soheil647/High_Level_Synthesis/Catapult_ImageProssesing/ESL_modelsim/Lena_Out.bmp

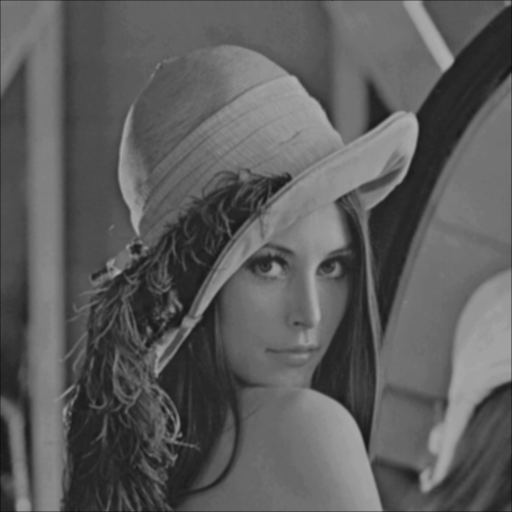
Catapult_ImageProssesing/ESL_modelsim/Lena_Out.bmp
