soheil647/High_Level_Synthesis/Catapult_Introduction/Report_AllStatus.pdf

All Status Report

مقدمه: در این ازمایش می خواهیم کد نرم افزاری را به زبان سخت افزار تبدیل کنیم و در هر مورد pipeline و Unroll کردن لوپ را ببینیم و این کاد را با استفاده از Catapult انجام می دهیم

کد++:C

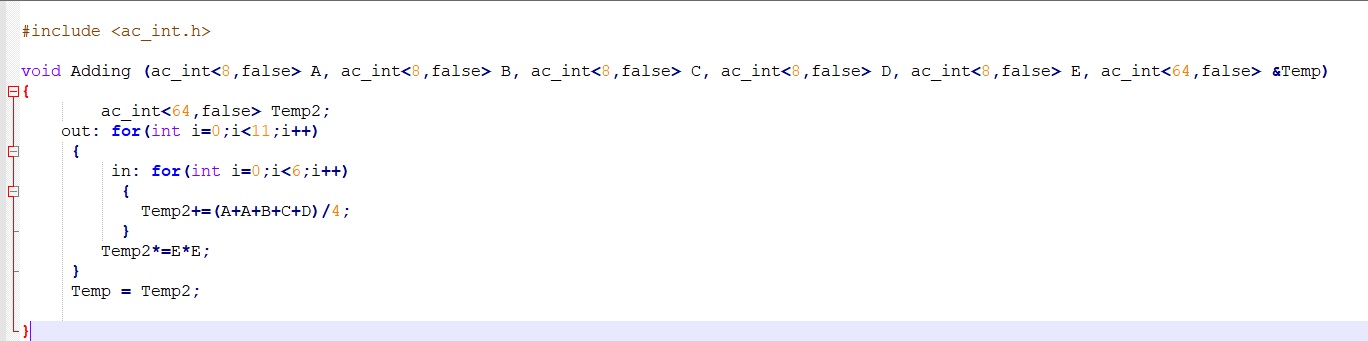
[picture p2: figure]

با استفاده از Catapult:

section A: (Min Latency) 1

Frequency: 50 MHz

Register count:179

Logic element count:395

Area: 2033.57

Latency cycle: 78

Latency time: 1560.00

Throughput cycle: 79

Throughput time: 1580.00

Data path:

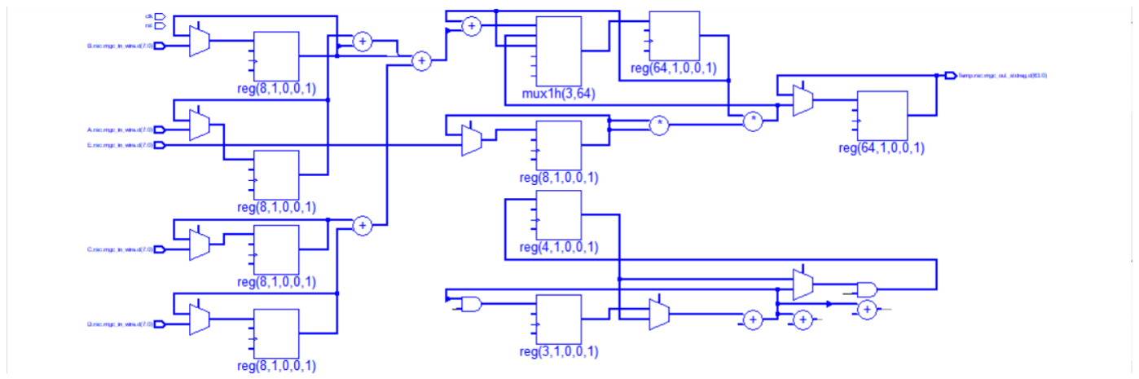
[picture p3: figure]

section B:

این قسمت pipeline با 1=II امکان پذیر نبود

main Loop Pipelining (II=2) 2

Frequency: 50Mhz

Register count: 194

Logic element count: 532

Area: 1902.86

Latency cycle: 132

Latency time: 2640.00

Throughput cycle: 132

Throughput time: 2640.00

Data path:

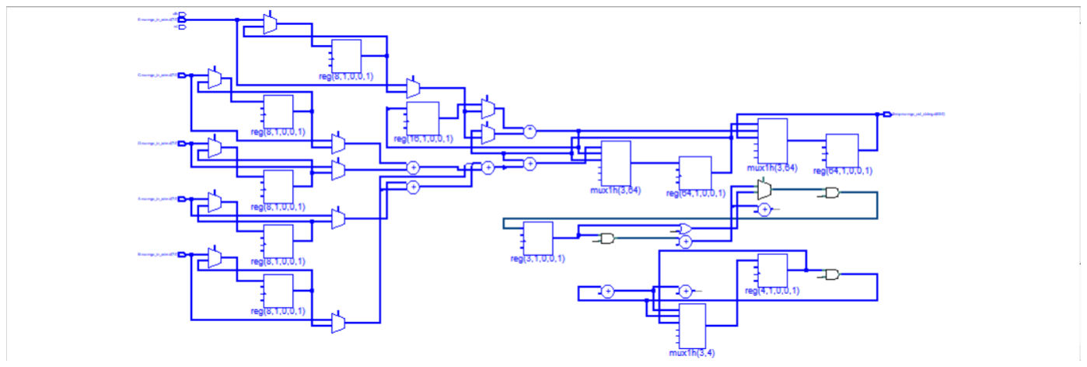
[picture p4: figure]

outer Loop Pipelining (II = 2) 3

Frequency:50Mhz

Register count: 197

Logic element count: 489

Area:1855.71

Latency cycle: 133

Latency time: 2660.00

Throughput cycle: 134

Throughput time: 2680.00

Data path:

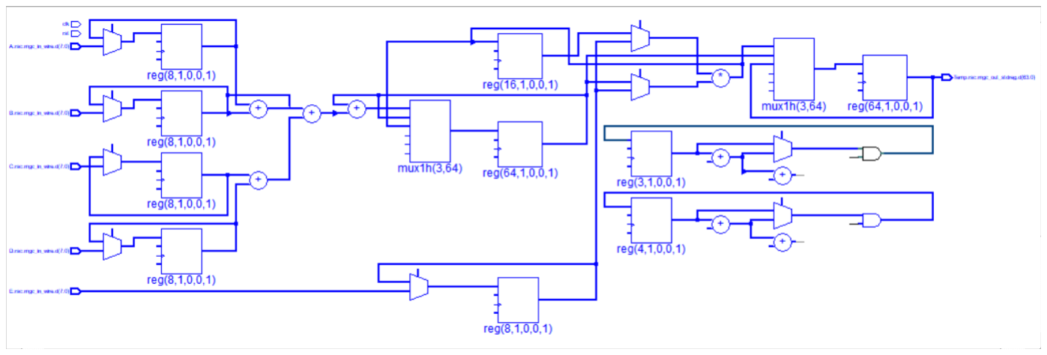
[picture p5: figure]

inner Loop Pipelining (II = 2) 4

Frequency: 50Mhz

Register count: 181

Logic element count: 398

Area:2036.65

Latency cycle: 144

Latency time: 2880.00

Throughput cycle: 145

Throughput time: 2900.00

Data path:

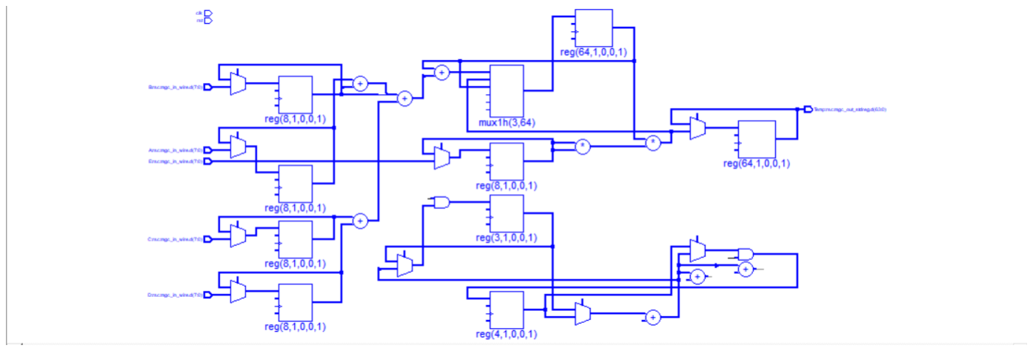
[picture p6: figure]

ر | عملکرد Pipeline: با Pipeline کردن مدار یم توانیم با Area
یکمتLatency ی بگرتیمکه به مع ین رسی ع تر بودن مدار است و

بهت ر
این
در بری 3 مورد Pipeline کردن main بوده است | ی

از بقیه بهت ر

section C:

outer loop unrolling 5

Frequency: 50Mhz

Register count: 274

Logic element count: 579

Area: 2156.89

Latency cycle: 78

Latency time: 1560.00

Throughput cycle: 79

Throughput time: 1580.00

Data path:

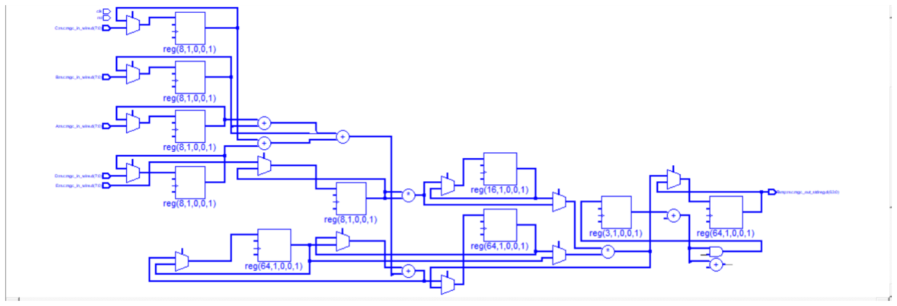
[picture p7: figure]

inner loop unrolling 6

Frequency: 50Mhz

Register count: 256

Logic element count: 427

Area: 1681.82

Latency cycle: 23

Latency time: 460.00

Throughput: 24

Throughput time: 480.00

Data path:

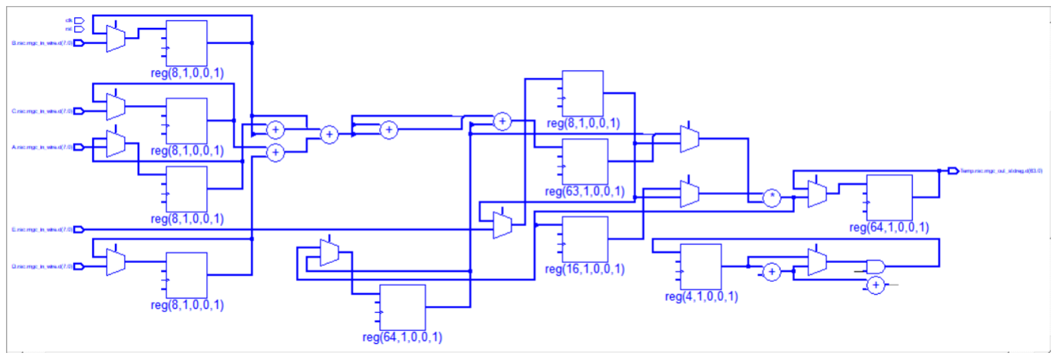
[picture p8: figure]

عملکرد Unroll: با Unroll کردن loop های مدار ما یم توانیم Iteration ها را با هم اجرا کنیم و این کار Latencyمدار را کم یم کند و رسعت باال یم رود ویل

Section D: (goal = Area) 7

Frequency: 50 MHz

Register count:197

Logic element count:492

Area: 1767.57

Latency cycle: 89

Latency time: 1780.00

Throughput cycle: 90

Throughput time: 1800.00

Data path:

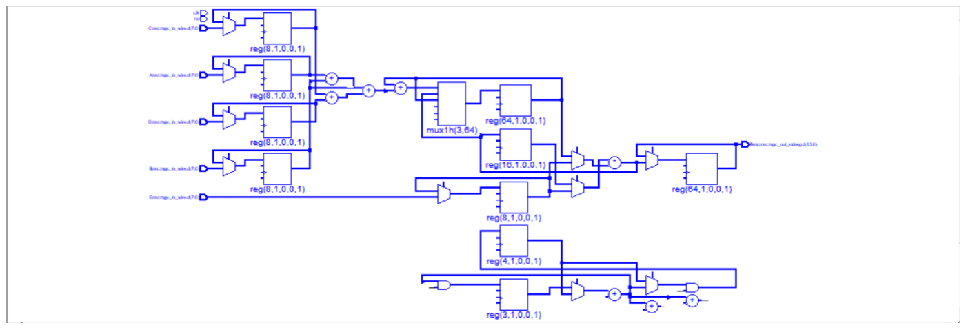
[picture p9: figure]

section D_B:

**Pipeline با 1=II قابل انجام نبوده است**

main Loop Pipelining (II=2) 8

Frequency: 50MHz

Register count: 194

Logic element count: 532

Area: 1902.86

Latency cycle: 132

Latency time: 2640.00

Throughput cycle: 132

Throughput time: 2640.00

Data path:

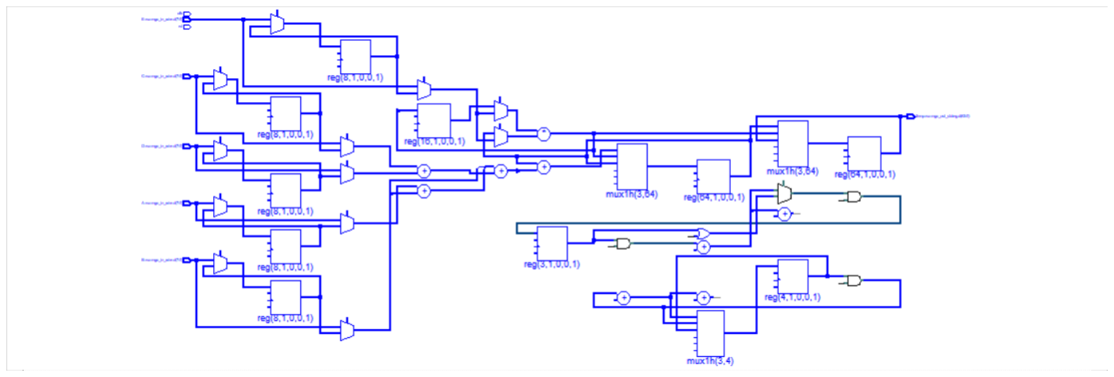
[picture p10: figure]

outer Loop Pipelining (II=2) 9

Frequency:50MHz

Register count: 197

Logic element count: 489

Area:1855.71

Latency cycle: 133

Latency time: 2660.00

Throughput cycle: 134

Throughput time: 2680.00

Data path:

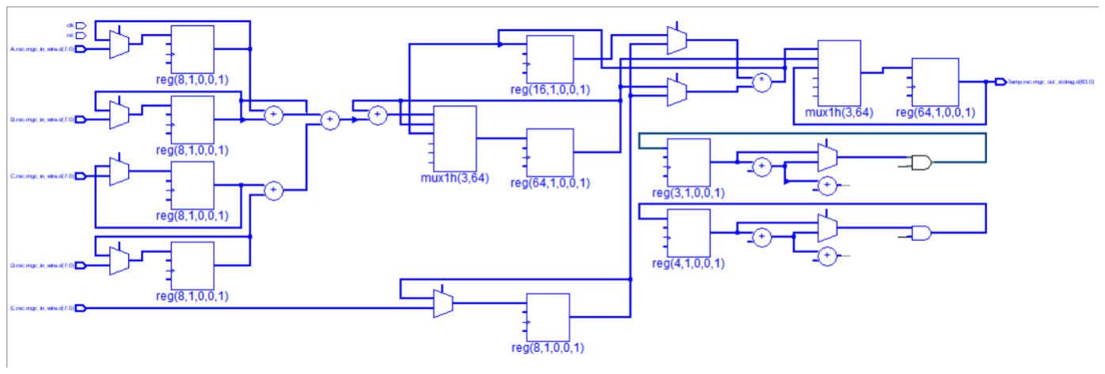
[picture p11: figure]

inner Loop Pipelining (II = 2) 10

Frequency: 50MHz

Register count: 199

Logic element count: 196

Area:1771.38

Latency cycle: 155

Latency time: 3100.00

Throughput cycle: 156

Throughput time: 3120.00

Data path:

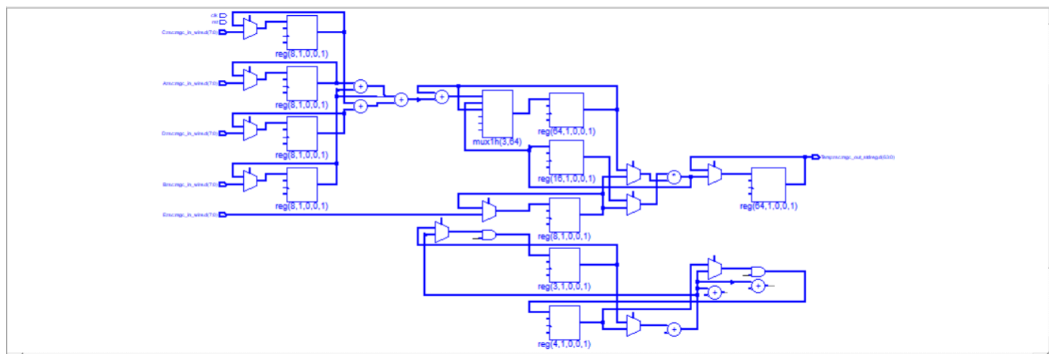
[picture p12: figure]

section C:

outer loop unrolling 11

Frequency: 50MHz

Register count: 276

Logic element count: 589

Area: 1579.79

Latency cycle: 79

Latency time: 1898.79

Throughput cycle: 80

Throughput time: 1600.00

Data path:

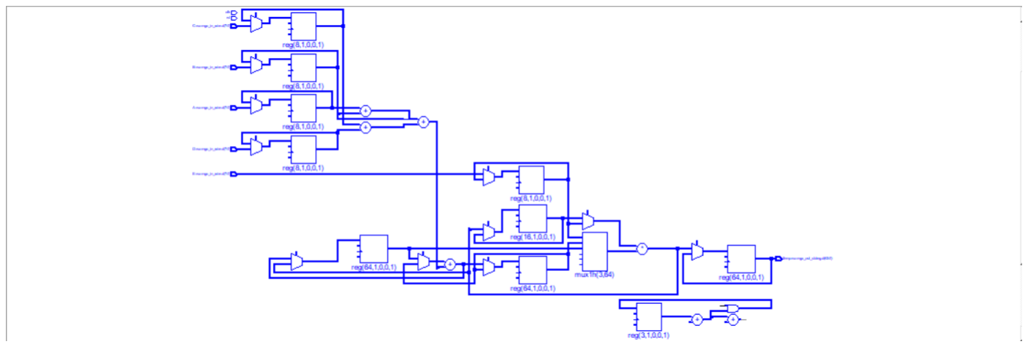
[picture p13: figure]

inner loop unrolling 12

Frequency: 50MHz

Register count: 256

Logic element count: 427

Area: 1681.82

Latency cycle: 23

Latency time: 460.00

Throughput: 24

Throughput time: 480.00

Data path:

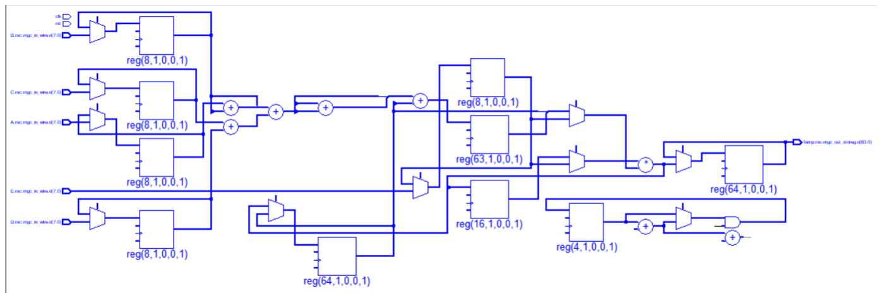
[picture p14: figure]
