soheil647/High_Level_Synthesis/Chisel_Introduction/Summery.pdf

Summery

چکیده:

در این پروژه می خواهیم نصب و کار با کتابخانه Chisel در زبان scala را بیاموزیم برای این کار نیاز است تا ابتدا سیستم عامل linux را نصب کنیم

مقدمه:

هزف از انجام این ازمایش یادگیری پایه ای Chisel و انجام دو ماژول ساده است برای این کار در ترمینال Linux قسمت های مورد نیاز را نصب کرده سپس Chisel را نصب می کنیم و در ان فایل Scala. را ساخته و ماژول های خود را در ان می نویسیم . در این ازمایش می خواهیم دو ماژول ALU و Stack را بسازیم

ابزار ها:

در این ازمایش در محیط Linux با استفاده از زبان Scala و کتابخانه Chisel ماژول های مورد نیاز را می سازیم

قسمت اول:

در قسمت اول خواسته شده تا یک ALU ساده با استفاده از 4 ALU که هر کدام عمل خاص خود را دارند بسازیم

ابتدا بعد از نصب Chisel و باز کردن فایل ان به پوشه solution/src رفته و یک فایل Scala. می سازیم و در ان پروژه را می سازیم

ابتده 4 ماژولALU برای هر یک از عملیات های جمع تفریق ضرب و تقسیم را مانند شکل های زیر می سازیم

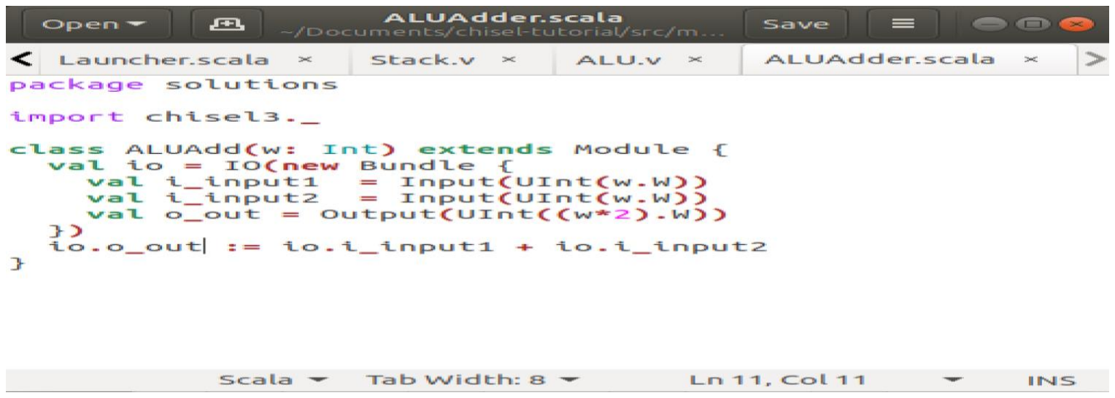
[picture p15: figure]

:ADDER:1 Figure

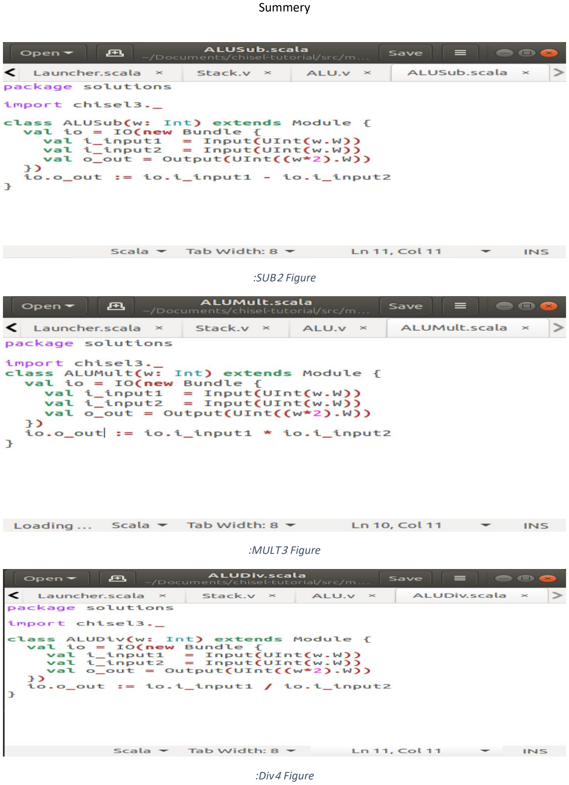
[picture p16: page 2]

:SUB2 Figure

:MULT3 Figure

:Div4 Figure

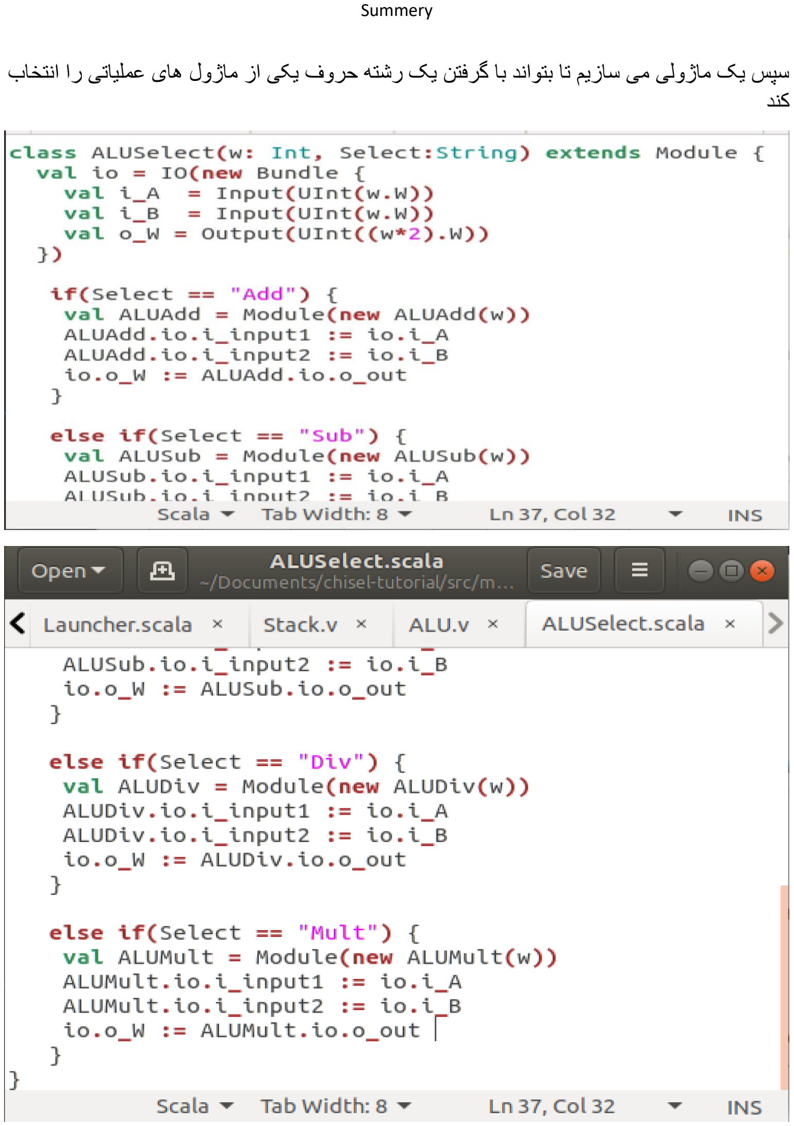
[picture p17: page 3]

سپس یک ماژولی می سازیم تا بتواند با گرفتن یک رشته حروف یکی از ماژول های عملیاتی را انتخاب کند

و سچس یک ماژول ساخته تا همه را به هم وصل کند ورودی خروجی ها را بگیرد و مقدار Delay دلخواه بدهد

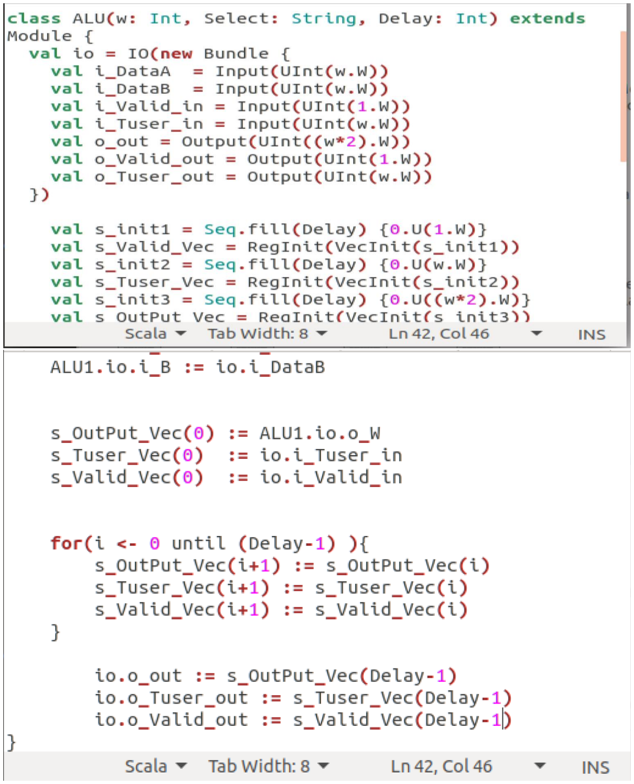
[picture p18: figure]

بعد از نوشتن ماژول ها ان را در ترمینال Compile می کنیم و از صحت ان مطمن می شویم

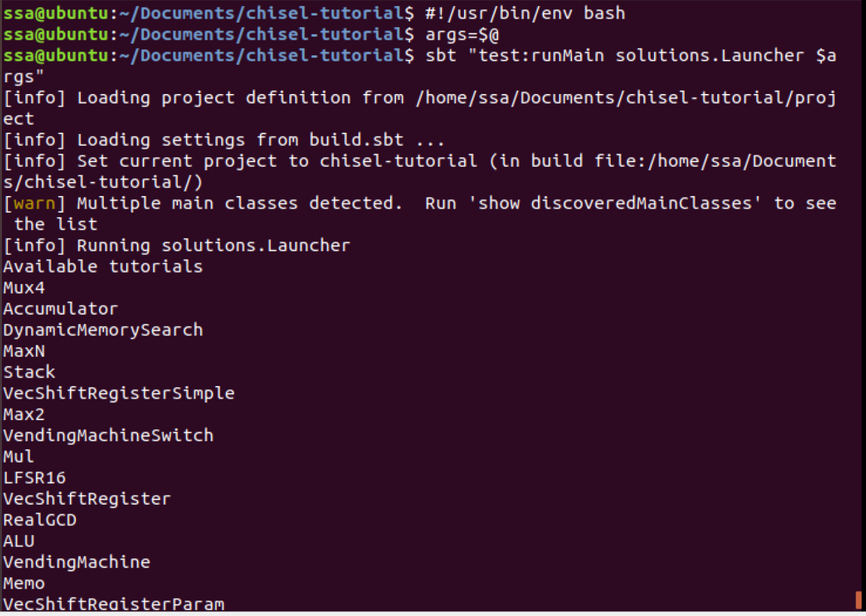
[picture p19: figure]

سپس به فایل تست رفته و تست ان را می نویسیم مانند شکل زیر:

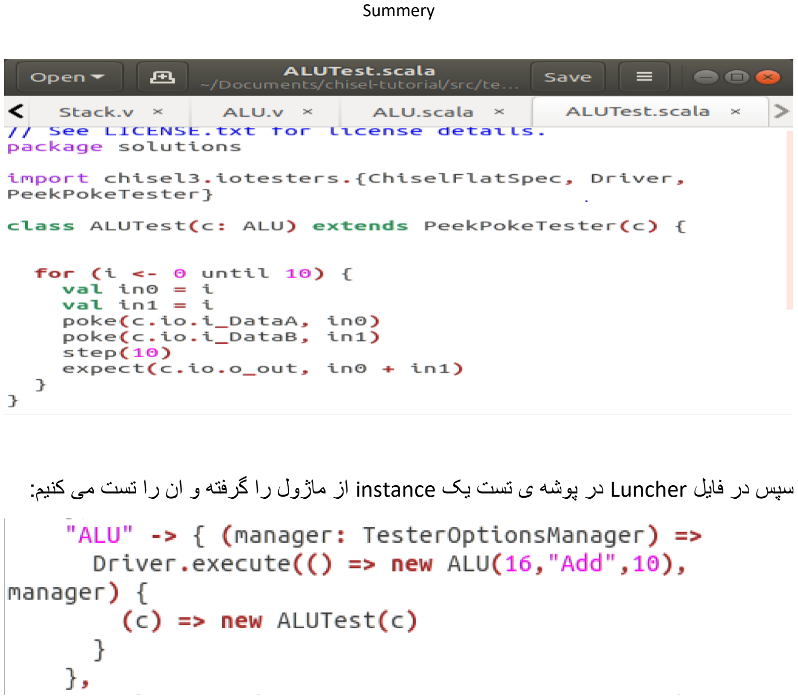
[picture p20: page 6]

سپس در فایل Luncher در پوشه ی تست یک instance از ماژول را گرفته و ان را تست می کنیم:

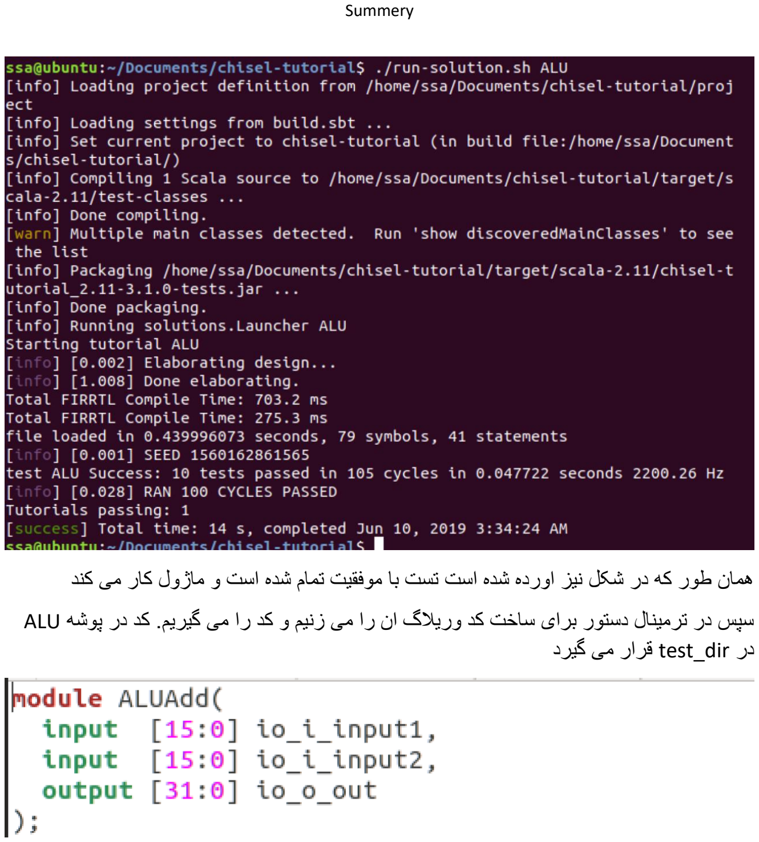
[picture p21: page 7]

همان طور که در شکل نیز اورده شده است تست با موفقیت تمام شده است و ماژول کار می کند

سپس در ترمینال دستور برای ساخت کد وریالگ ان را می زنیم و کد را می گیریم. کد در پوشه ALU در dir_test قرار می گیرد

کد را به Quartes برده و سنتز می کنیم و داریم:

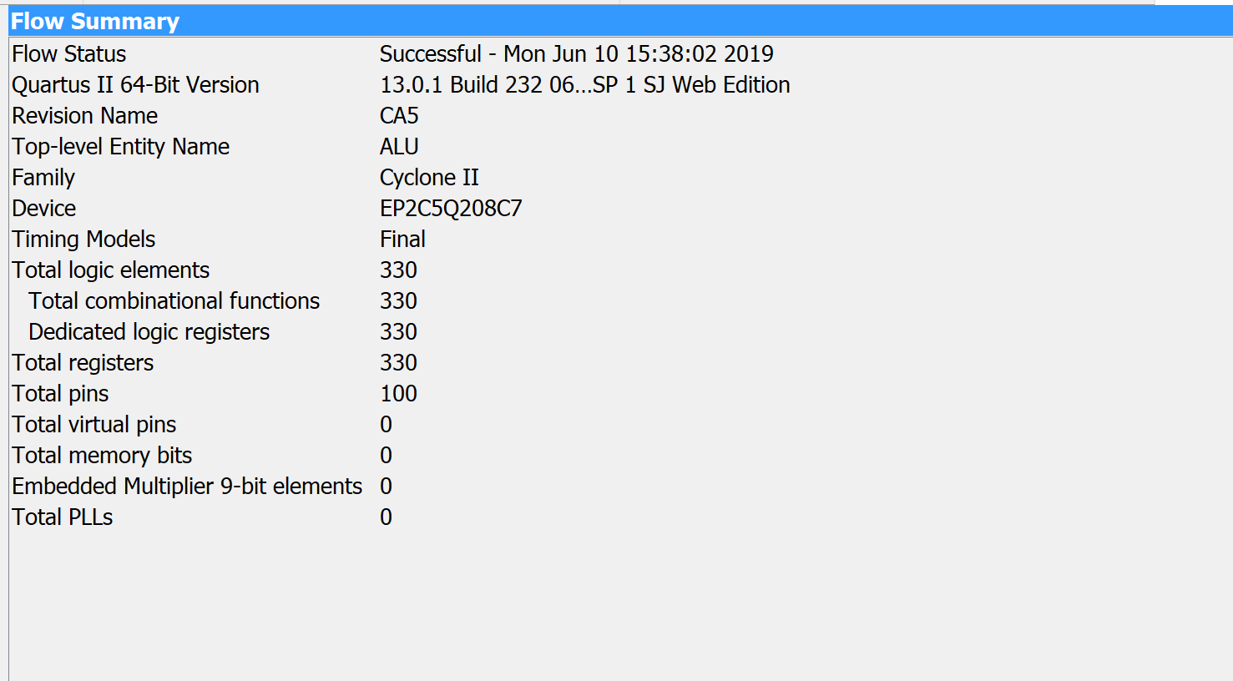
[picture p22: figure]

قسمت دوم:

در این قسمت می خاهیم یک استک بسازیم:

همانند قسمت قبل ابتدا فایل ماژول را ساخته و Compile می کنیم

ماژول استک را مانند زیر می سازیم:

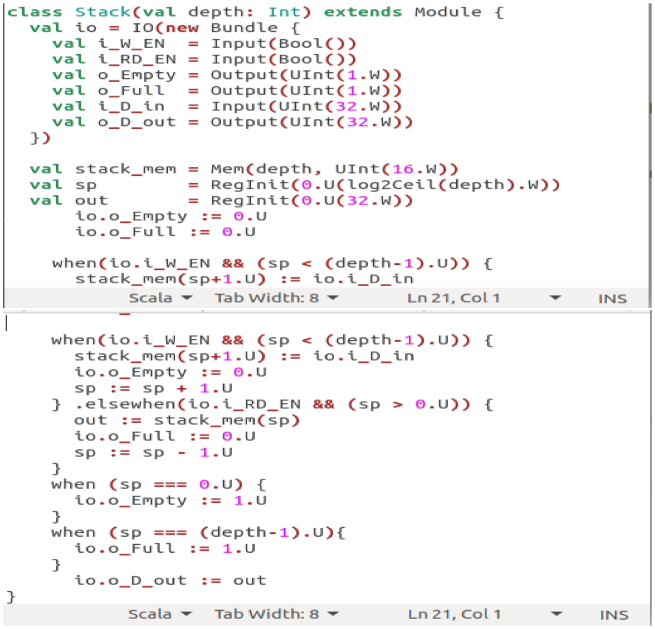
[picture p23: figure]

سپس ان را در ترمینال Compile می کنیم و درستی ان را جک می کنیم

سپس به پوشه تست رفته و تست بنچ مربوط به ان را می نویسیم

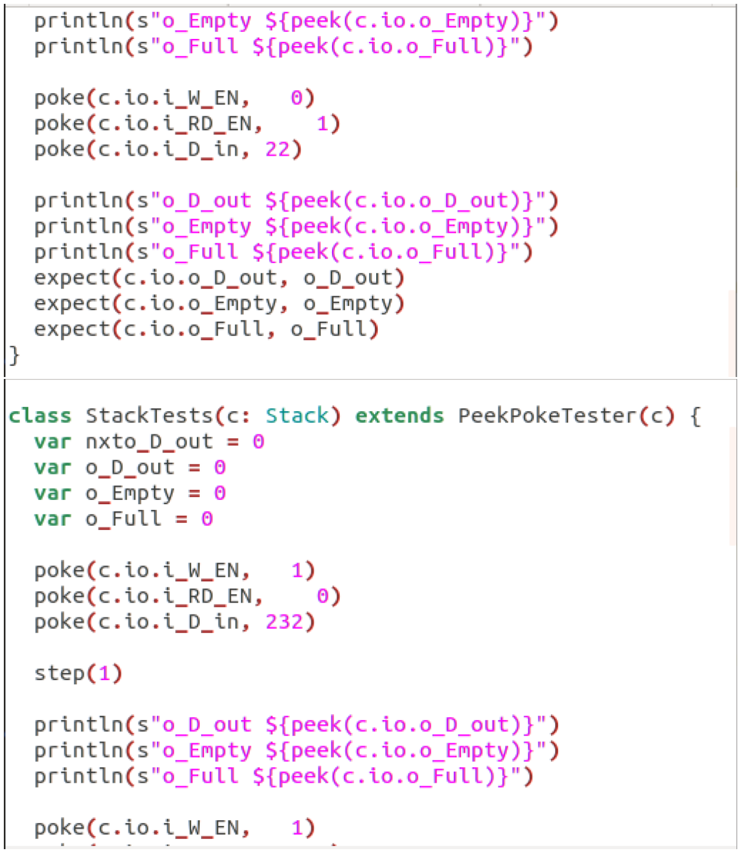
[picture p24: figure]
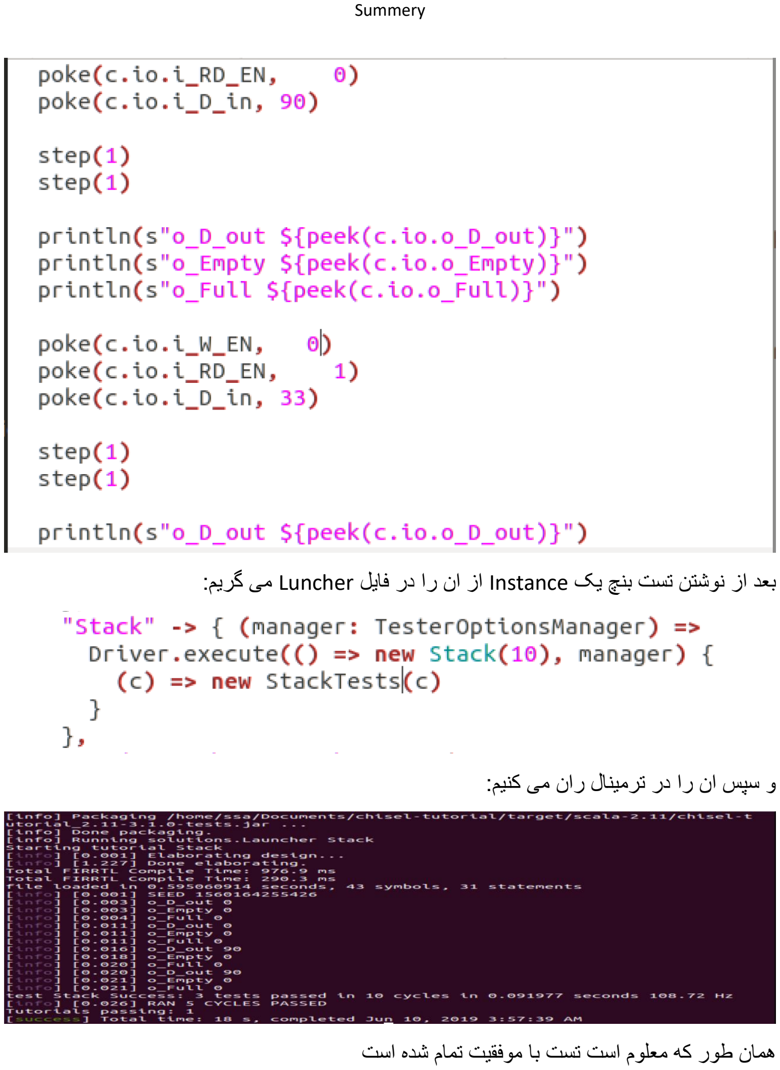
[picture p25: page 11]

بعد از نوشتن تست بنچ یک Instance از ان را در فایل Luncher می گریم:

و سپس ان را در ترمینال ران می کنیم:

همان طور که معلوم است تست با موفقیت تمام شده است

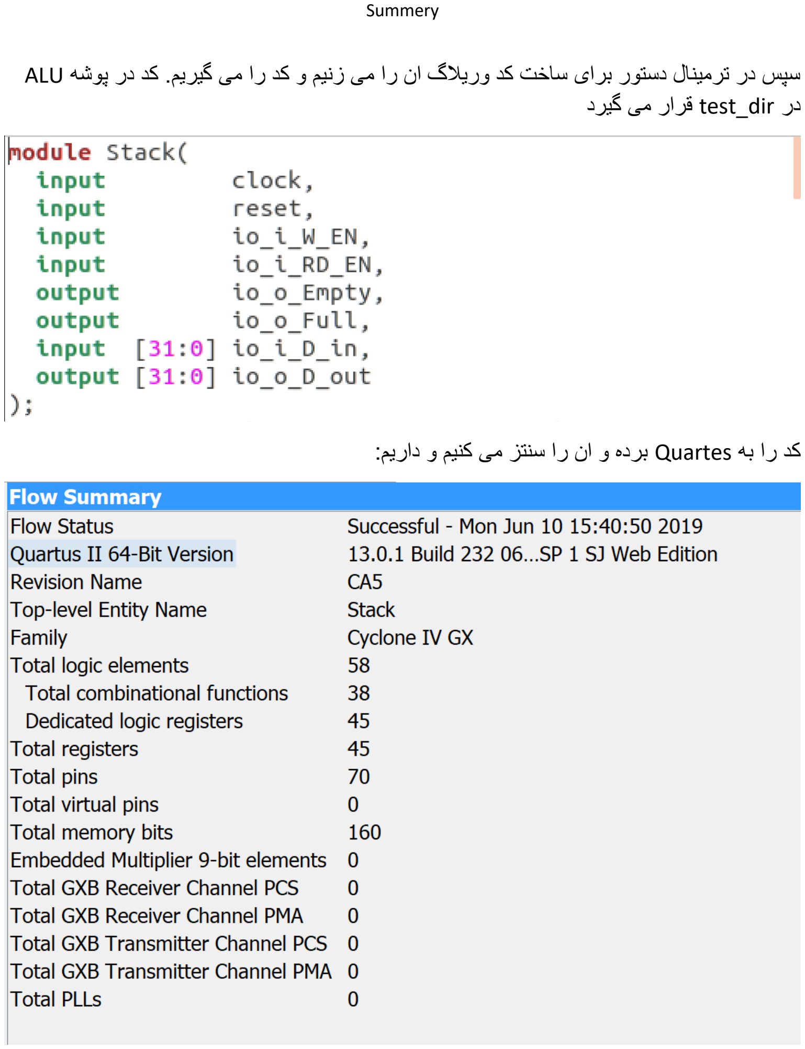
[picture p26: page 12]

سپس در ترمینال دستور برای ساخت کد وریالگ ان را می زنیم و کد را می گیریم. کد در پوشه ALU در dir_test قرار می گیرد

کد را به Quartes برده و ان را سنتز می کنیم و داریم:
