soheil647/High_Level_Synthesis/Matlab_HDLCoder_FIR/Gozaresh.pdf

Summery

### چکیده:

در این پروژه می خواهیم فیلتر FIR را با الگوریتم های مختلفی بسازیم و کار با HDL Matlab یاد بگیریم

### مفدمه:

در این پروژه از Coder HDL Matlab و Modelsim استفاده شده است که ما ابتدا فیلتری را به صورت دستی با زبان Verilog ساختیم سپس همان فیلتر را با Matlab ساختیم و کد Verilog را با ان تولید کردیم این کار را یک بار با الگریتم CSD و یک بار به صورت DA ساخته ایم

### ابزار ها:

در این پروژه از Modelsim و Matlab و Quartes استفاده شده است و مدل FPGA را II Cyclone انتخاب کرده ایم

### قسمت :1

1( ابتدا فیلتر FIR را که در زیر نیز امده است به صورت دستی نوشته ایم. در این فیلتر ضرایب 480و 320-و 31 است که انها را به صورت CSD در نظر گرفته ایم

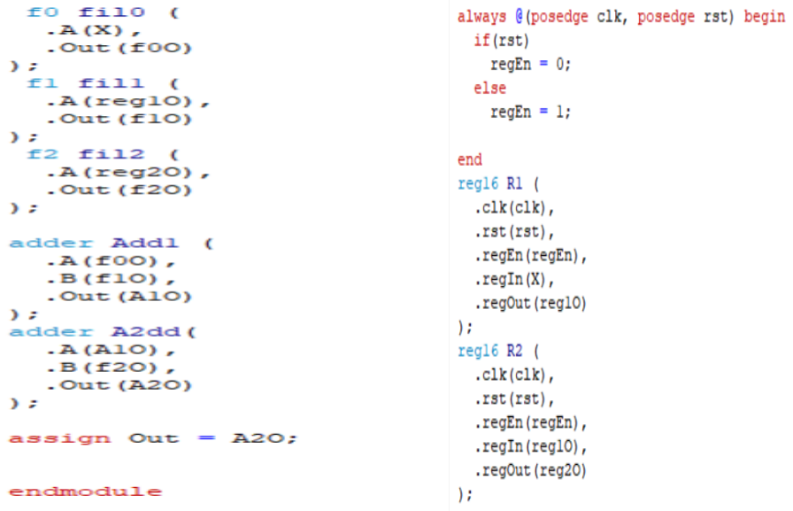
[picture p27: figure]

کد کامل در فایل قرار دهده شده است و ضرایب به صورت CSD هستند

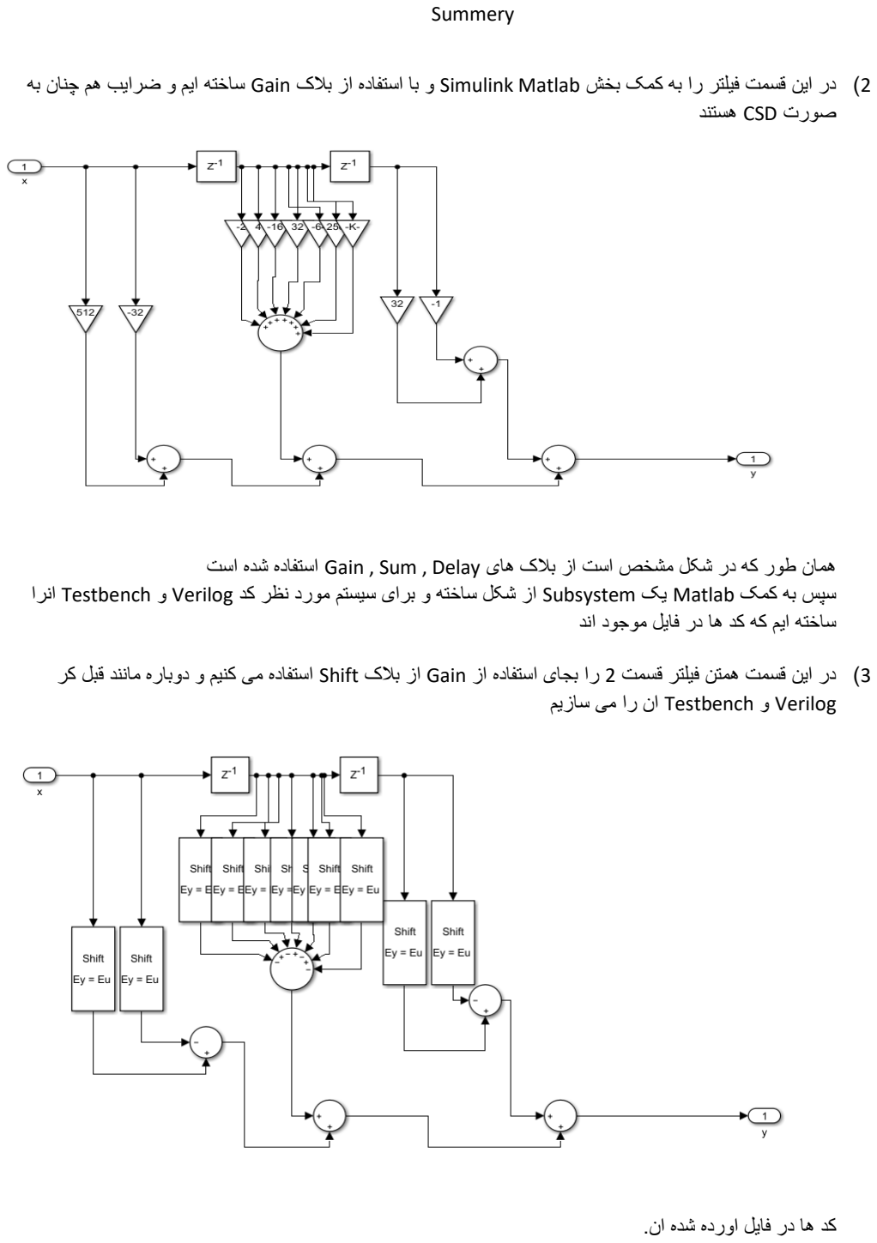
[picture p28: page 2]

2( در این قسمت فیلتر را به کمک بخش Matlab Simulink و با استفاده از بالک Gain ساخته ایم و ضرایب هم چنان به صورت CSD هستند

همان طور که در شکل مشخص است از بالک های Delay , Sum , Gain استفاده شده است سپس به کمک Matlab یک Subsystem از شکل ساخته و برای سیستم مورد نظر کد Verilog و Testbench انرا ساخته ایم که کد ها در فایل موجود اند

3( در این قسمت همتن فیلتر قسمت 2 را بجای استفاده از Gain از بالک Shift استفاده می کنیم و دوباره مانند قبل کر Verilog و Testbench ان را می سازیم

کد ها در فایل اورده شده ان.

4( با استفاده از کد های Testbench تولید شده فیلتر های ساخته شده را امتحان می کنیم و می بینیم که درست کار می کنند

5( حال کد های Verilog را به Quartes برده و انها را synthesis می کنیم و داده های زیر به دست می ایند:

Handwrite_FIR_CSD☺ Total Logic Elements: 135, Total Registers: 33;
Matlab_Gain_FIR☺ Total Logic Elements: 208, Total Registers: 102;
Matlab_Shift_FIR☺ Total Logic Elements: 133, Total Registers: 32;

6( تفاوت کد های Shift , Gain در ان است که در Gain کد تولید شده به ازای هر Block Gain یک رجیستر استفاده شده و تمام مقادیر ثابت ان رجیستر شده اند ولی در Shift این مقادیر با استفاده از Assign بدست امده ان و دیگر رجیستر
ن یستند به امین دلیل تعداد رجیستر و LE کمتری استفاده شده است.

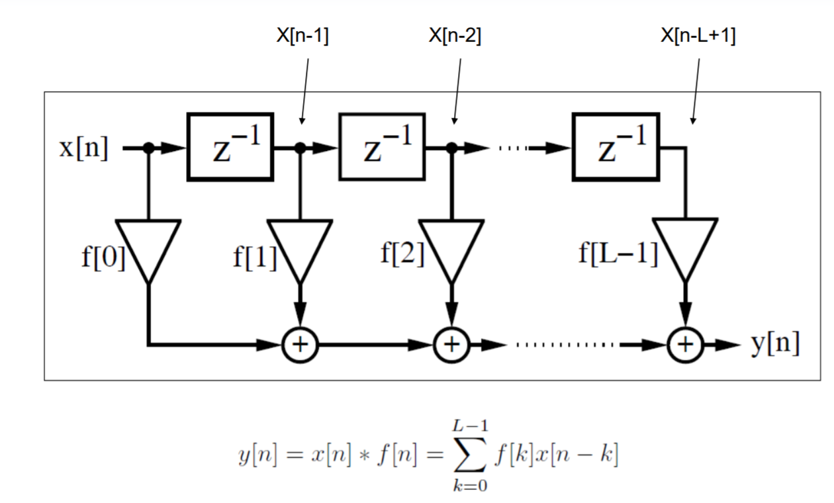
[picture p29: figure]
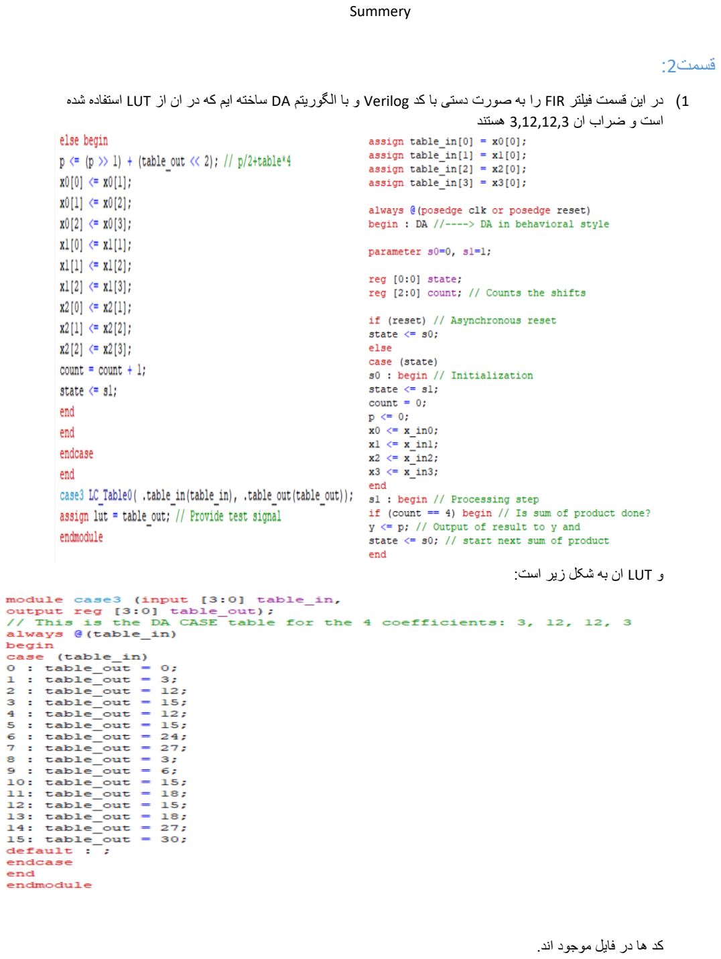
[picture p30: page 4]

### قسمت :2

1( در این قسمت فیلتر FIR را به صورت دستی با کد Verilog و با الگوریتم DA ساخته ایم که در ان از LUT استفاده شده است و ضراب ان 3,12,12,3 هستند

و LUT ان به شکل زیر است:

کد ها در فایل موجود اند.

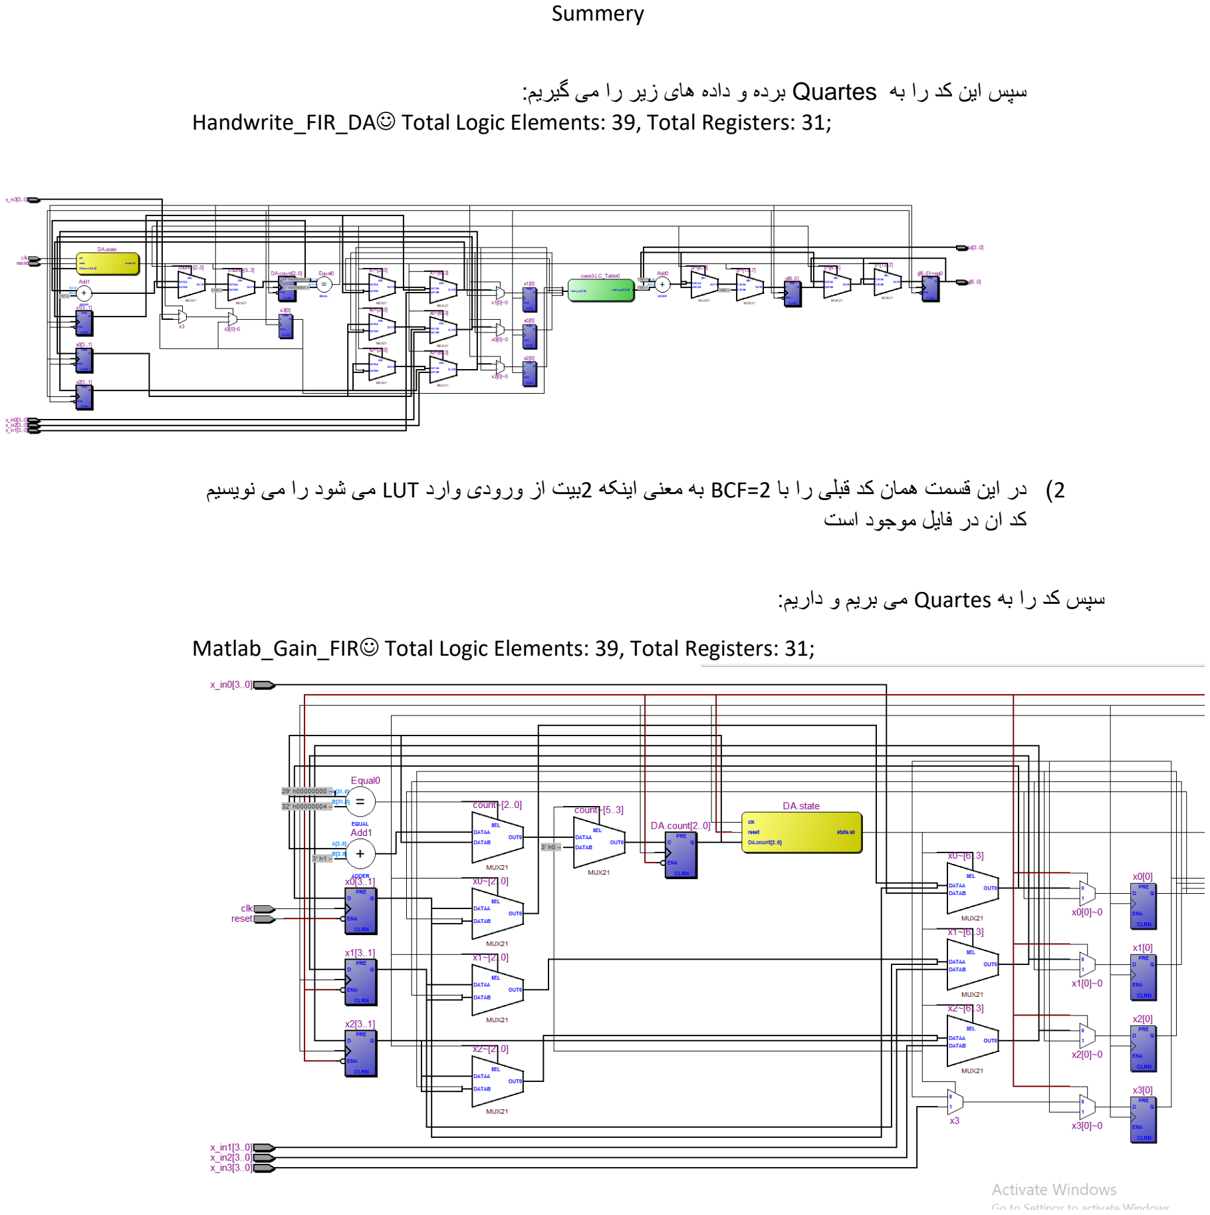
[picture p31: page 5]

سپس این کد را به Quartes برده و داده های زیر را می گیریم: Handwrite_FIR_DA☺ Total Logic Elements: 39, Total Registers: 31;

2( در این قسمت همان کد قبلی را با 2=BCF به معنی اینکه 2بیت از ورودی وارد LUT می شود را می نویسیم کد ان در فایل موجود است

سپس کد را به Quartes می بریم و داریم:

Matlab_Gain_FIR☺ Total Logic Elements: 39, Total Registers: 31;

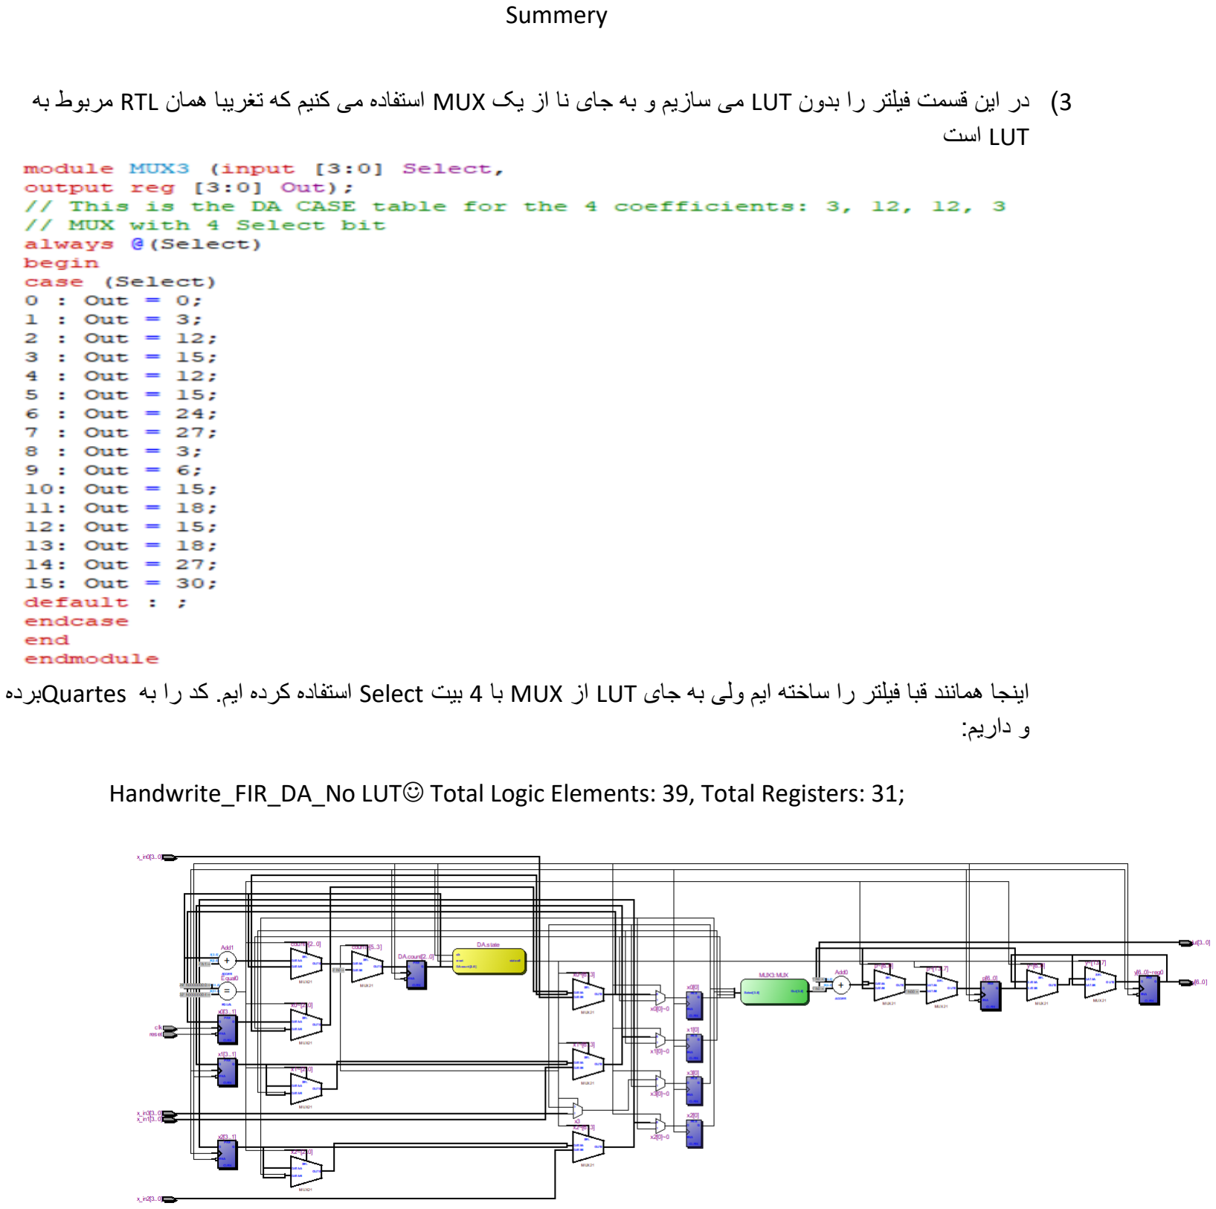
[picture p32: page 6]

3( در این قسمت فیلتر را بدون LUT می سازیم و به جای نا از یک MUX استفاده می کنیم که تغریبا همان RTL مربوط به LUT است

اینجا همانند قبا فیلتر را ساخته ایم ولی به جای LUT از MUX با 4 بیت Select استفاده کرده ایم. کد را به Quartesبرده و داریم:

Handwrite_FIR_DA_No LUT☺ Total Logic Elements: 39, Total Registers: 31;

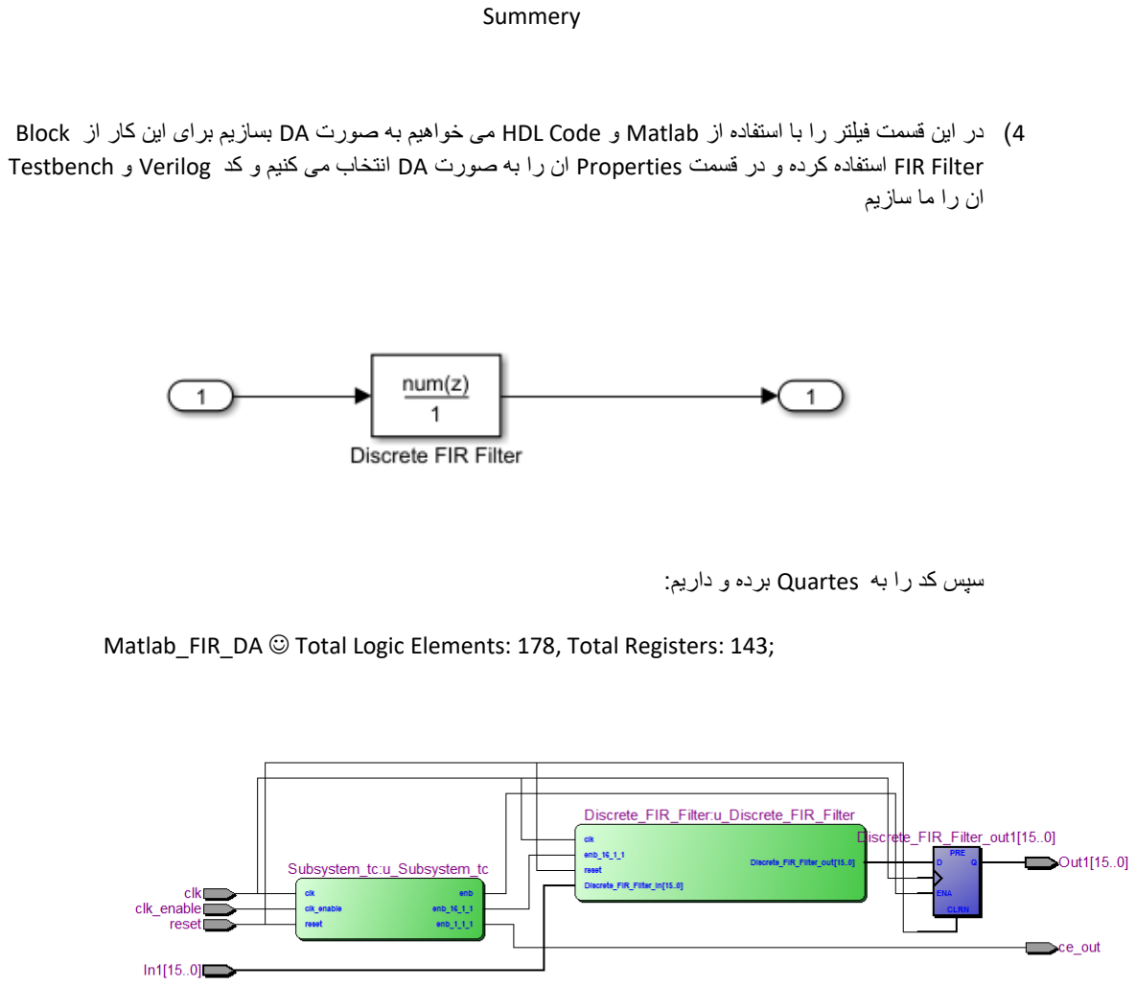
[picture p33: page 7]

4( در این قسمت فیلتر را با استفاده از Matlab و Code HDL می خواهیم به صورت DA بسازیم برای این کار از Block Filter FIR استفاده کرده و در قسمت Properties ان را به صورت DA انتخاب می کنیم و کد Verilog و Testbench
ان را ما سازیم

سپس کد را به Quartes برده و داریم:

Matlab_FIR_DA ☺ Total Logic Elements: 178, Total Registers: 143;

5( برای مقایسه این روش ها داریم:

Logic elements: HDL Code > No LUT > BCF=1 > BCF=2

Registers: HDL Code > No LUT > BCF=1 > BCF=2

دلیل ان این است که در 2=BCF LUT ها 8 بیتی است و به تعدهد کمتری رجیستر نیاز دارید و در LUT No که از MUX استفاده شده چون LUT ندارد و RTL است تعداد بیشتر دارد و در نهایت Code HDL بیشترین است
