soheil647/High_Level_Synthesis/Verilog_Cordic/Summery.pdf

Summery

## چکیده:

در این پروژه به بررسی و محاسبه ی توابع مختلف با استفاد از الگوریتم CORDIC می پردازیم و سعی می کنیم ان ها را به ازای مقادیر مختلف محاسبه کنیم و فرق بین CORDIC و بسط تیلور را در اخر مقایسه می کنیم

## مقدمه:

هدف از انجام این پروژه یادگیری الگوریتم CORDIC و نوشتن ان به زبان Verilog است. در این پروژه در Modelsim با استفاده از Verilog توابع مختلف را پیاده سازی کرده و ان ها را بررسی می کنیم.

## مراحل انجام تمرین:

در این پروژه ابتدا سعی می کنیم توابع Cos , Sin را با CORDIC محاسبه کنیم سپس تابع قدر مطلق را محاسبه کرده و سپس تابع جذر را به دو روش CORDIC و series Tylor محاسبه می کنیم و ان ها را با هم مقایسه می کنیم

## قسمت اول:

می خواهیم تابع Trigonometry را با CORDIC پیاده سازی کنیم

این ت ابع ورودی Theta را گرفته و مقادیر Cos , Sin ان را محاسبه می کند برای این کار یک سیگنال ورودی Valid و دو سیگنال Busy , Done نیز استفاده شده است.

طبق CORDIC در مد گردشی مقدار z را به 0 می رسانیم و مقادیر Cos , Sin را بدست می اوریم

برای این الگریتم ابتدا نیاز به مقادیر ثابت -1Tan ها داریم که در عکس امده اند.

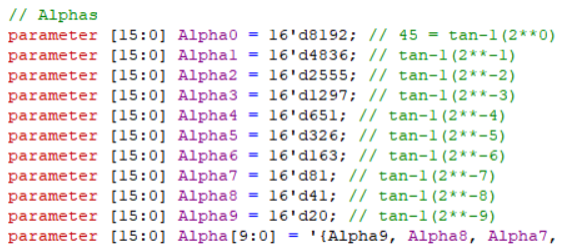
[picture p34: figure]
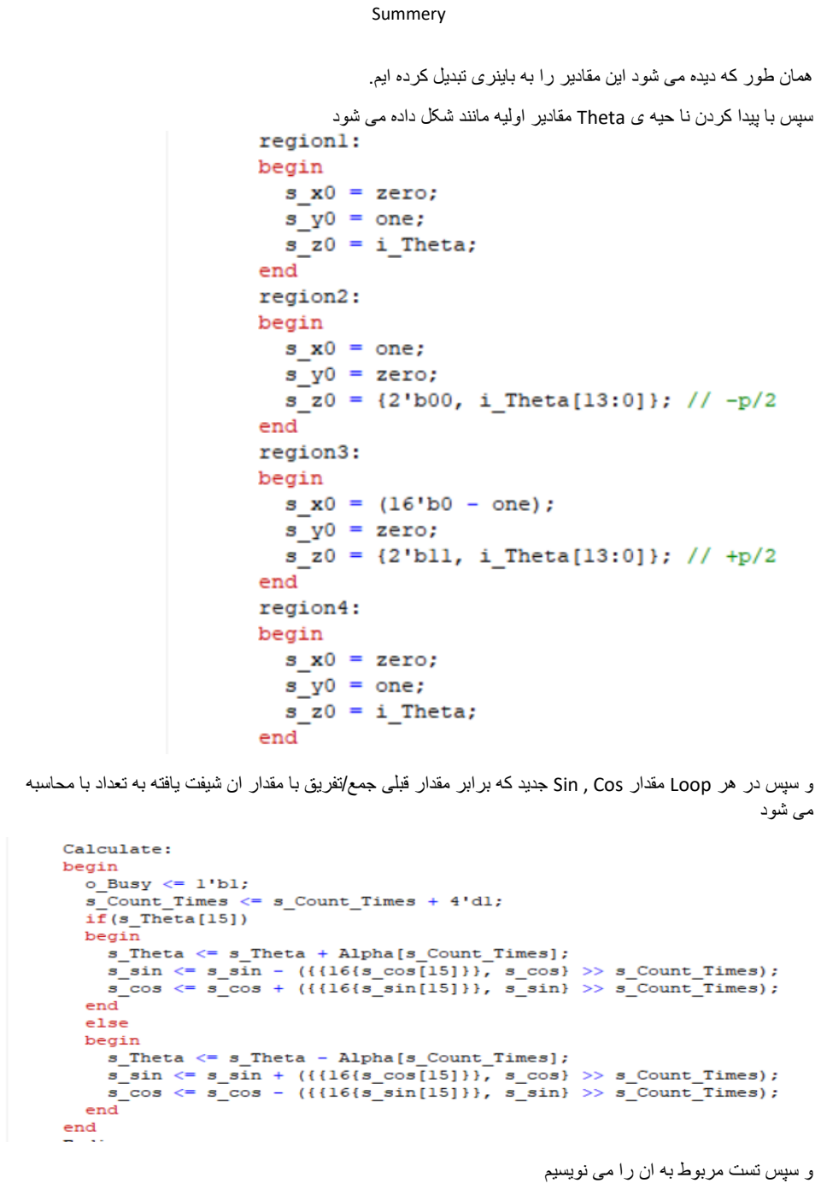
[picture p35: page 2]

همان طور که دیده می شود این مقادیر را به باینری تبدیل کرده ایم.

سپس با پیدا کردن نا حیه ی Theta مقادیر اولیه مانند شکل داده می شود

و سپس در هر Loop مقدار Cos , Sin جدید که برابر مقدار قبلی جمع/تفریق با مقدار ان شیفت یافته به تعداد با محاسبه می شود

و سپس تست مربوط به ان را می نویسیم

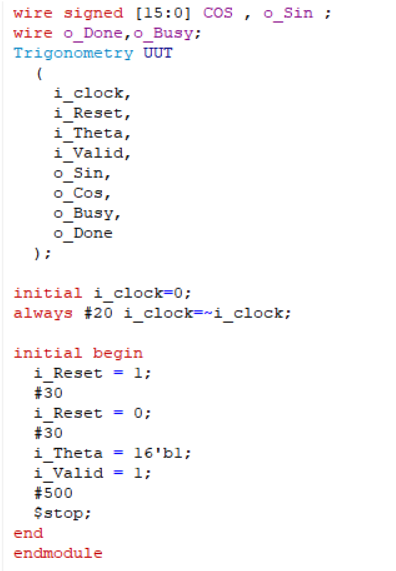
[picture p36: figure]

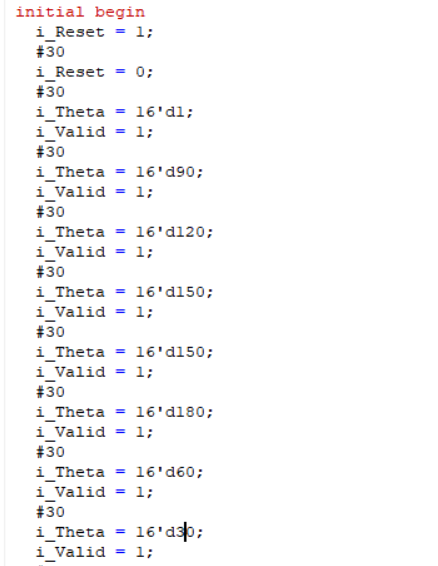
[picture p37: figure]

و مقادیر بدست امده را می بینیم

## قسمت دوم:

در این قسمت می خواهیم تابع قدر مطلق را پیاده سازی کنیم

تابع قدر مطلق به صورت

|A + jB| = K1√y
2 + x X | 2 0 = A , Y0 = B

با استفاده از الگریتم CORDIC پیاده سازی می شود در این قسمت از Pipeline با 1=Throughput نیز استفاده شده است و ضریب K برابر 1.62 در نظر گرفته شده است

برای این کار ابتدا به مقادیر -1Tan ها مانند قبل نیاز داریم

سپس باید با توجه به مقدار B , A ناحیه ی کارمان را پیدا کنیم

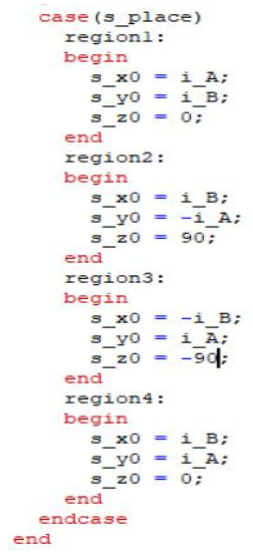
[picture p38: figure]
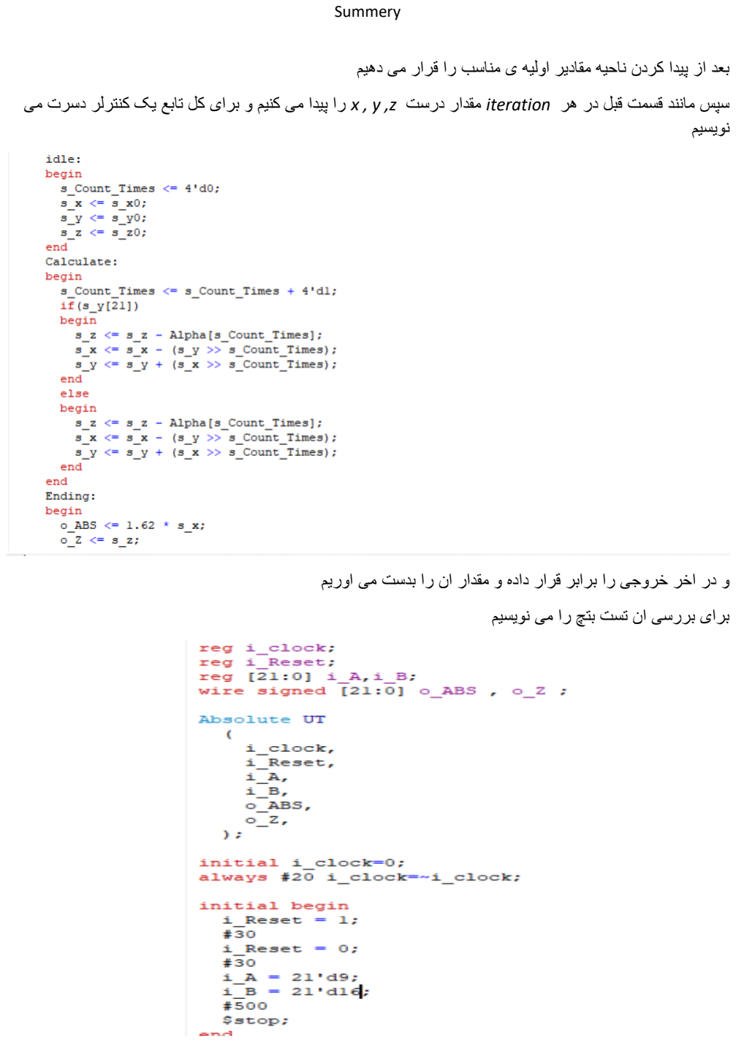
[picture p39: page 6]

بعد از پیدا کردن ناحیه مقادیر اولیه ی مناسب را قرار می دهیم

سپس مانند قسمت قبل در هر iteration مقدار درست z, y , x را پیدا می کنیم و برای کل تابع یک کنترلر دسرت می نویسیم

و در اخر خروجی را برابر قرار داده و مقدار ان را بدست می اوریم

برای بررسی ان تست بتچ را می نویسیم

## قسمت سوم:

در این قسمت می خواهیم تابع جذر را پیاده سازی کنیم

تابع قدر مطلق به صورت

√W = √y
2 − x X | 2 0 = W + 0.25 , Y0 = W + 0.25

با استفاده از الگریتم CORDIC پیاده سازی می شود در این قسمت از Pipeline با 1=Throughput نیز استفاده شده است

این تابع به صورت مستقیم از CORDIC قابل محاسبه نیست ول می توان با تغییر کوچکی در مقدار اولیه های تابع قدر مطلق ان را بدست اورد

برای این کار مانند قبل عمل می کنیم

ابتدا مقادیر -1Tan ها را ذخیره می کنیم

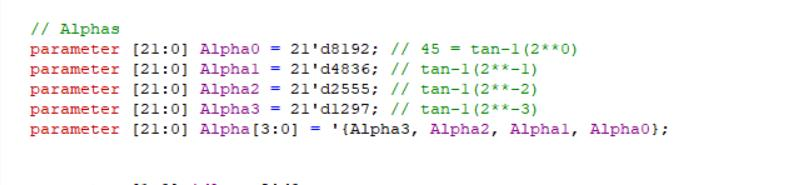
[picture p40: figure]

سپس برای پیدا کردن ناحیه ی کار چون x باید از Y بزرگ تر باشد پس بر خالف قسمت قبل فقط 1 ناحیه داریم که در شکل زیر اورده شده است

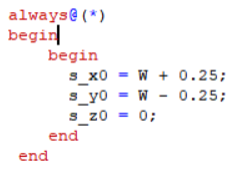
[picture p41: figure]

سپس برای هر Iteration مقادیر مورد نظر را با استفاده از الگوریتم پیدا کرده در مواقع نیاز ان را شیفت داده و یا از مقادیر ثابت Alpha استفاده می کنیم و برای ان کنترلر درست را می نویسیم

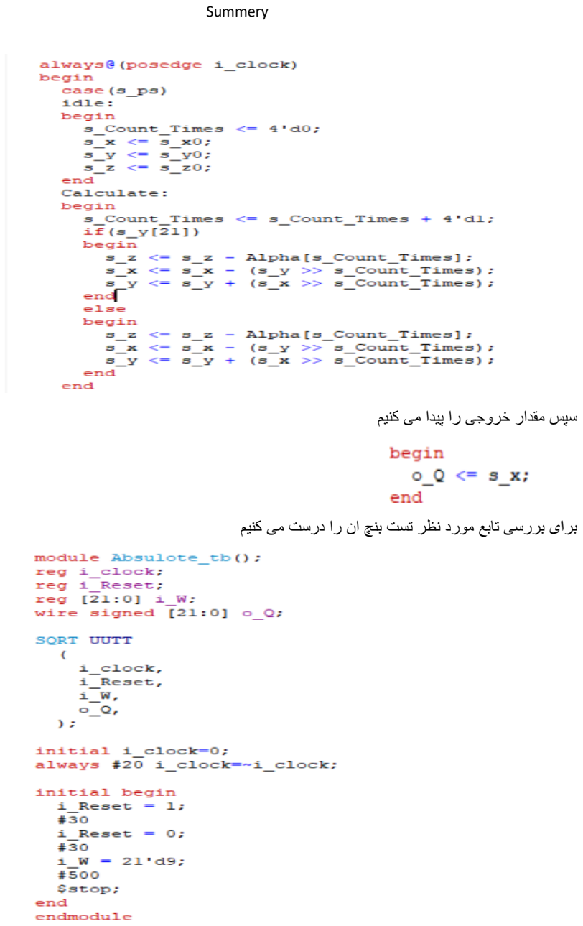
[picture p42: page 8]

سپس مقدار خروجی را پیدا می کنیم

برای بررسی تابع مورد نظر تست بنچ ان را درست می کنیم

## قسمت جهار:

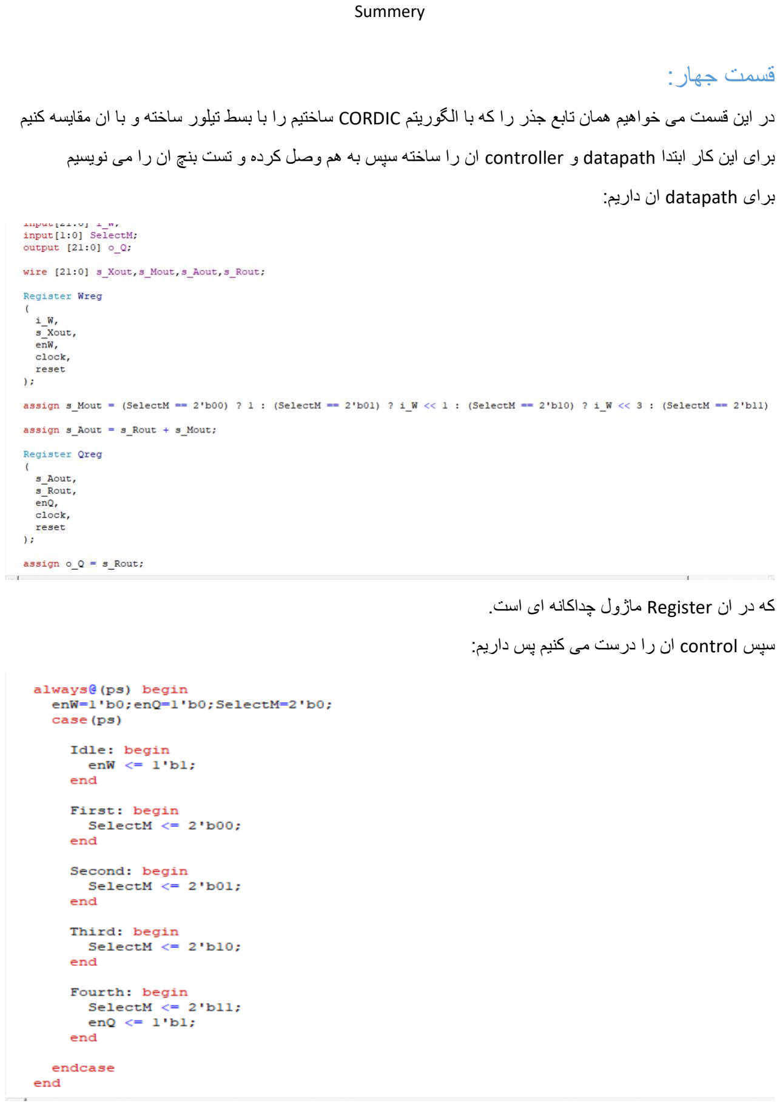
[picture p43: page 9]

در این قسمت می خواهیم همان تابع جذر را که با الگوریتم CORDIC ساختیم را با بسط تیلور ساخته و با ان مقایسه کنیم

برای این کار ابتدا datapath و controller ان را ساخته سپس به هم وصل کرده و تست بنچ ان را می نویسیم

برای datapath ان داریم:

که در ان Register ماژول چداکانه ای است.

سپس control ان را درست می کنیم پس داریم:

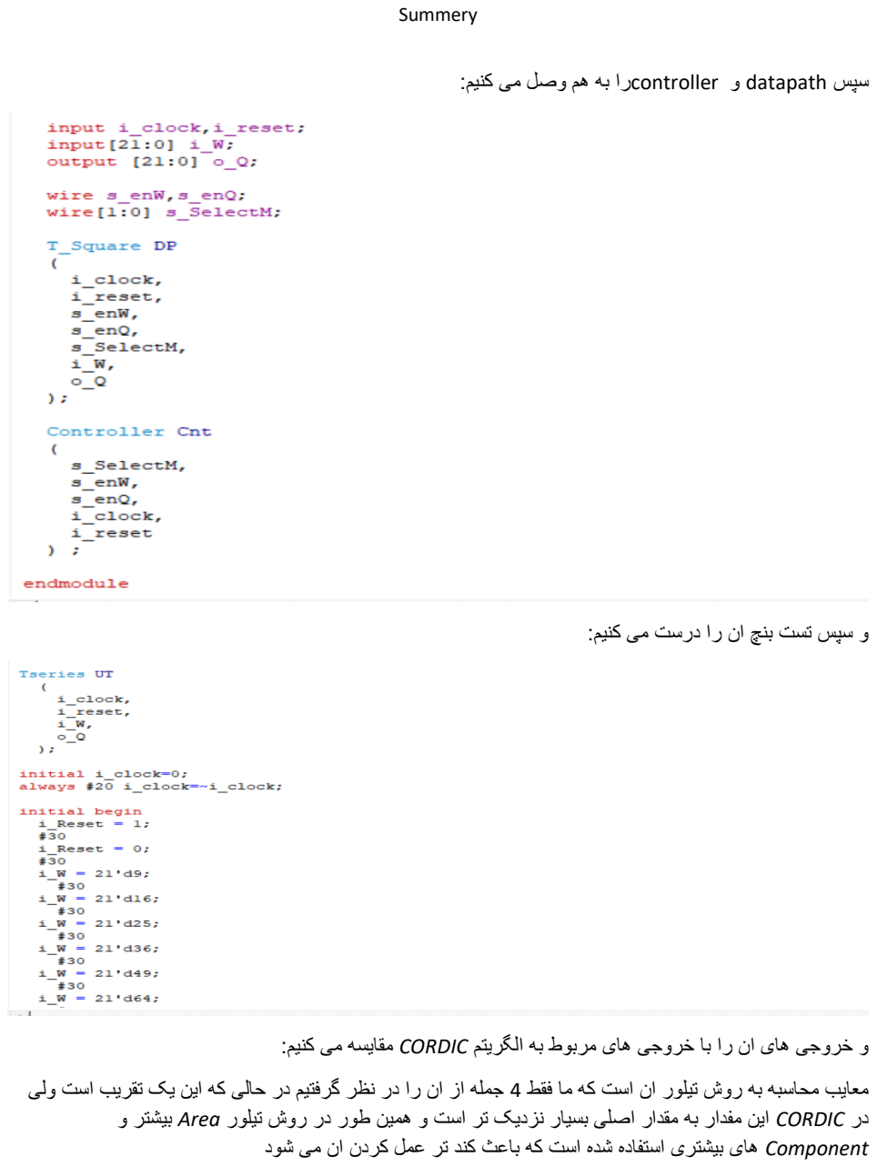
[picture p44: page 10]

سپس datapath و controllerرا به هم وصل می کنیم:

و سپس تست بنچ ان را درست می کنیم:

و خروجی های ان را با خروجی های مربوط به الگریتم CORDIC مقایسه می کنیم:

معایب محاسبه به روش تیلور ان است که ما فقط 4 جمله از ان را در نظر گرفتیم در حالی که این یک تقریب است ولی در CORDIC این مفدار به مقدار اصلی بسیار نزدیک تر است و همین طور در روش تیلور Area بیشتر و Component های بیشتری استفاده شده است که باعث کند تر عمل کردن ان می شود
