soheil647/High_Level_Synthesis/Catapult_ImageProssesing/Catapult/Convolotion.v15/rtl.vhdl_order.txt

./rtl_funcs.vhd
./rtl_mux_pkg.vhdl
./rtl.vhdl
