soheil647/High_Level_Synthesis/(list of files, cad)

Other CAD files:
Catapult_ImageProssesing/ESL_modelsim/work/@convolotion/verilog.psm
Catapult_ImageProssesing/ESL_modelsim/work/@convolotion_core/verilog.psm
Catapult_ImageProssesing/ESL_modelsim/work/@convolotion_core_fsm/verilog.psm
Catapult_ImageProssesing/ESL_modelsim/work/@e@s@l_quartes/verilog.psm
Catapult_ImageProssesing/ESL_modelsim/work/@ram/verilog.psm
Catapult_ImageProssesing/ESL_modelsim/work/@rom/verilog.psm
Catapult_ImageProssesing/ESL_modelsim/work/@test/verilog.psm
Catapult_ImageProssesing/ESL_modelsim/work/@top_@file/verilog.psm
Matlab_HDLCoder_FIR/modesim_ESL/work/@discrete_@f@i@r_@filter/verilog.psm
Matlab_HDLCoder_FIR/modesim_ESL/work/@f@i@r/verilog.psm
Matlab_HDLCoder_FIR/modesim_ESL/work/@f@i@r_@t@b/verilog.psm
Matlab_HDLCoder_FIR/modesim_ESL/work/@m@u@x3/verilog.psm
Matlab_HDLCoder_FIR/modesim_ESL/work/@subsystem/verilog.psm
Matlab_HDLCoder_FIR/modesim_ESL/work/@subsystem_tb/verilog.psm
Matlab_HDLCoder_FIR/modesim_ESL/work/@subsystem_tc/verilog.psm
Matlab_HDLCoder_FIR/modesim_ESL/work/adder/verilog.psm
Matlab_HDLCoder_FIR/modesim_ESL/work/case3/verilog.psm
Matlab_HDLCoder_FIR/modesim_ESL/work/da/verilog.psm
Matlab_HDLCoder_FIR/modesim_ESL/work/dafsm/verilog.psm
Matlab_HDLCoder_FIR/modesim_ESL/work/f0/verilog.psm
Matlab_HDLCoder_FIR/modesim_ESL/work/f1/verilog.psm
Matlab_HDLCoder_FIR/modesim_ESL/work/f2/verilog.psm
Matlab_HDLCoder_FIR/modesim_ESL/work/reg16/verilog.psm
Verilog_Cordic/CA4/work/@absolute/verilog.psm
Verilog_Cordic/CA4/work/@absulote_tb/verilog.psm
Verilog_Cordic/CA4/work/@controller/verilog.psm
Verilog_Cordic/CA4/work/@register/verilog.psm
Verilog_Cordic/CA4/work/@s@q@r@t/verilog.psm
Verilog_Cordic/CA4/work/@t_@square/verilog.psm
Verilog_Cordic/CA4/work/@trigonometry/verilog.psm
Verilog_Cordic/CA4/work/@tseries/verilog.psm
Verilog_Cordic/CA4/work/@tseries_tb/verilog.psm
Verilog_Cordic/CA4/work/cordic/verilog.psm
Verilog_Cordic/CA4/work/cordic_10_tb/verilog.psm
Verilog_Cordic/CA4/work/cordic_tb/verilog.psm
