soheil647/High_Level_Synthesis/Matlab_HDLCoder_FIR/HDL Coder Tutorial.pdf

بسمه تعالي

درس طراحي در سطح سیستم
نکاتي در مورد استفاده از Coder HDL
پردیس دانشکدههای فنی دانشگاه تهران دانشکده مهندسی برق و کامپيوتر
دکتر بيژن عليزاده
نيمسال دوم سال تحصيلی 9397-98
)arman.helli@yahoo.com( | واسعی | آرمان : | نگارش
در ابتدای استفاده از محيط سيمولينک برای توليد کد HDL حتما باید تنظيمات زیر را انجام بدهيم:

در ابتدا از منوی Simulation گزینه ی Parameters Configuration Model را انتخاب میکنيم.

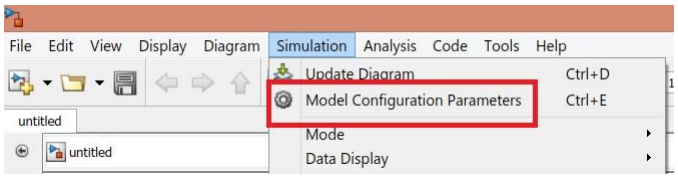
[picture p45: figure]

شکل 9 – تنظيمات شبيهسازی
بعد تنظيمات Solver را به گونهی زیر تغيير میدهيم. Solver نقش شبيهسازی ورودی و محاسبهی خروجی طبق ورودی را دارد و چون باید کد HDL توليد کنيم، پس ورودیها باید به صورت گسسته باشند و تنظيمات زیر نقش تعيين گسسته بودن مدل شبيهسازی را ایفا میکنند:

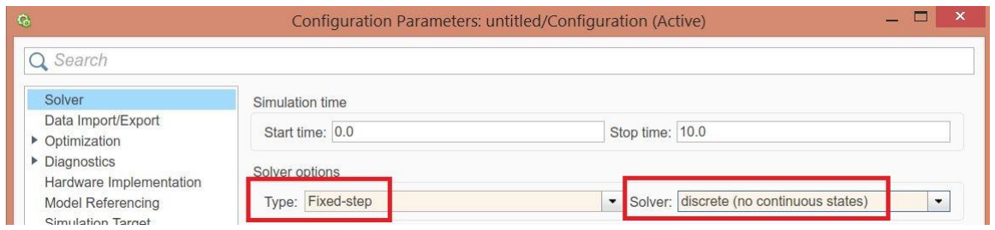
[picture p46: figure]

شکل 2 – تنظيمات Solver
برای سيستمهایی با انجام عملياتی مانند جمع و بهره)مانند فيلترهای FIR )که بلوکهای مربوطه به شکل Fixed Point توسط Coder HDL پشتيبانی میشوند صرفا نوع ورودی مورد نظر را با دبل کليک کردن بر روی ورودیها انتخاب میکنيم. سيستم ساده زیر را درنظر بگيرید:

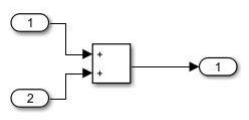
[picture p47: figure]

شکل 3 – سيستم ساده در نظر گرفته شده برای توليد کد HDL
روند تعيين نوع ورودی در شکل زیر مشاهده میشود. (1,8,0)fixdt به این معنی است که 9 عالمتدار بودن نوع داده را تعيين میکند، 8 به معنای تعداد بيت ورودی است و 0 نيز تعداد بيتهای اعشاری را نشان میدهد.

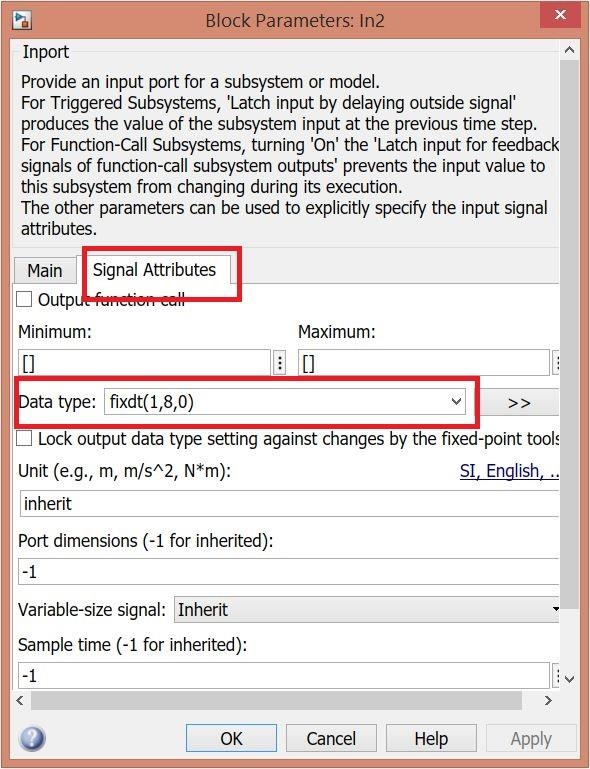
[picture p48: figure]

شکل 4 – تنظيمات نوع ورودی
همچنين نوع خروجی را نيز از نوع auto :Inherit انتخاب میکنيم که خود Coder HDL با مالحظات ریاضی و منطقی تعداد بيتهای آن را تعيين کند. سپس در محيط خط فرمان متلب دستور زیر را برای انتخاب ابزار سنتز وارد میکنيم:

Hdlsetuptoolpath ('ToolName', 'Altera Quartus II', 'ToolPath', 'C:\intelFPGA_lite\16.1\quartus\bin64\quartus.exe');
در مثال باال نوع سنتز طول II Quartus بود ولی می توان ابزار های دیگری مانند Vivado یا ISE را نيز انتخاب کرد. منتها باید دقت شود که پارامترهای ToolName و ToolPath هميشه به شکل باال در دستور نوشته میشوند

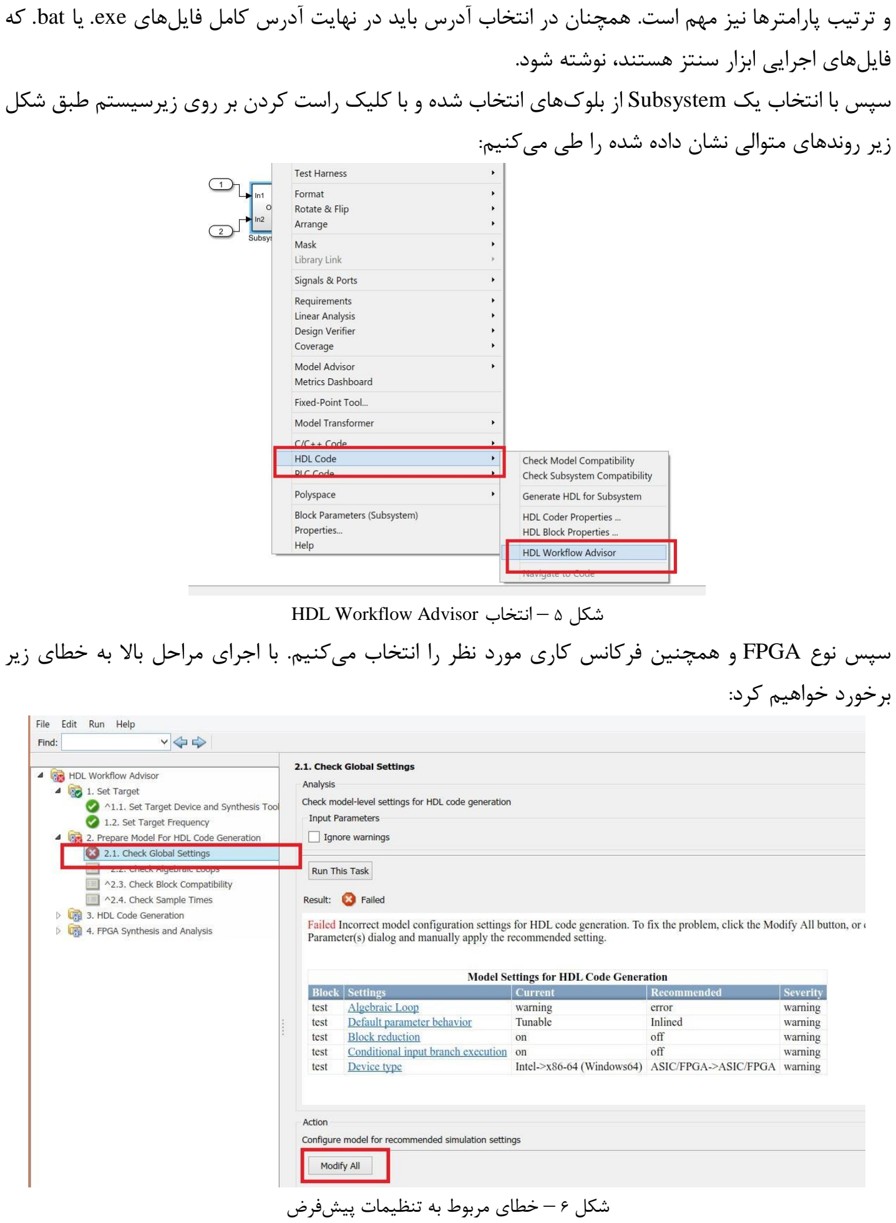
[picture p49: page 3]

و ترتيب پارامترها نيز مهم است. همچنان در انتخاب آدرس باید در نهایت آدرس کامل فایلهای exe. یا bat. که فایلهای اجرایی ابزار سنتز هستند، نوشته شود. سپس با انتخاب یک Subsystem از بلوکهای انتخاب شده و با کليک راست کردن بر روی زیرسيستم طبق شکل زیر روندهای متوالی نشان داده شده را طی میکنيم:

HDL Workflow Advisor | انتخاب | – 5 | شکل
سپس نوع FPGA و همچنين فرکانس کاری مورد نظر را انتخاب میکنيم. با اجرای مراحل باال به خطای زیر برخورد خواهيم کرد:

شکل 6 – خطای مربوط به تنظيمات پيشفرض

این خطا درواقع نوع واکنش ابزار سنتز به مواردی همچون حلقهی جبری یا فعال بودن تنظيماتی مانند کاهش بهينه بلوکها را نشان میدهد. با کليک بر گزینهی All Modify تنظيمات پيشفرض به تنظيمات پيشنهاد داده شده توسط خود Coder HDL تغيير داده میشوند و با بار دیگر اجرای این مرحله، این خطا برطرف خواهد شد. مراحل بعدی نيز در صورت وجود نداشتن حلقهی جبری و فيدبک و تنظيمات صحيح Solver که در باال اشاره شد نيز بدون هيچ مشکلی طی میشوند. مرحله 3 نيز به تنظيمات نوع کد توليدی)Verilog یا VHDL )و همچنين پایپ الین شدن و به اشتراک گذاشتن منابع اختصاص دارد. شکل زیر طی شدن موفقيت آميز مراحل متوالی را نشان میدهد:

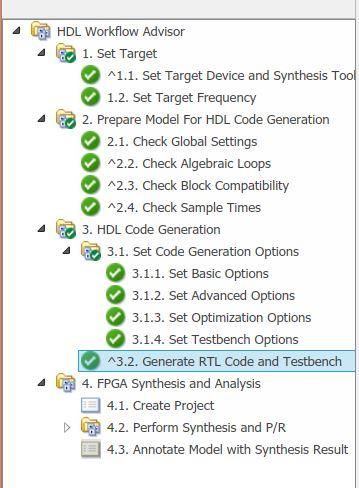
[picture p50: figure]

شکل 7 – طی شدن موفقيت آميز تمامی مراحل
برای صرفا توليد کد HDL اجرای مراحل تا مرحله 3.2 کافی است. حال نگاهی به کد HDL توليد شده برای سيستم مذکور در باال می اندازیم:

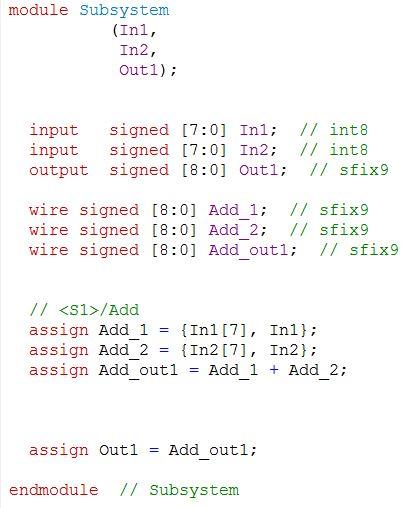
[picture p51: figure]

همانطور که در کد توليد شده مشاهده میشود،Coder HDL نوع خروجی را 9 بيت درنظر گرفته است که با توجه به ورودی 8 بيتی انتخاب شده کامال صحيح است. اما بلوک هایی نيز وجود دارند که فقط از اعداد point floating پشتيبانی میکنند مانند توابع مثلثاتی. سيستم زیر را در نظر بگيرید:

شکل 8 – سيستم درنظر گرفته شده دوم برای توليد کد HDL
در ابتدا نوع ورودی را از جنس (1,16,13)fixdt انتخاب میکنيم. )دليل انتخاب این بازه آن است که چون ورودی باید به رادیان باشد و زاویه مورد نظر ما بين π و π –است، پس در یک عدد 96 بيتی، صرفا 3 بيت عالمت و صحيح برای نمایش این بازه کفایت میکند.( سپس باید از ابزار Tool Point-Fixed استفاده کنيم که پنجره آن با کليک راست کردن روی زیرسيستم باز میشود:

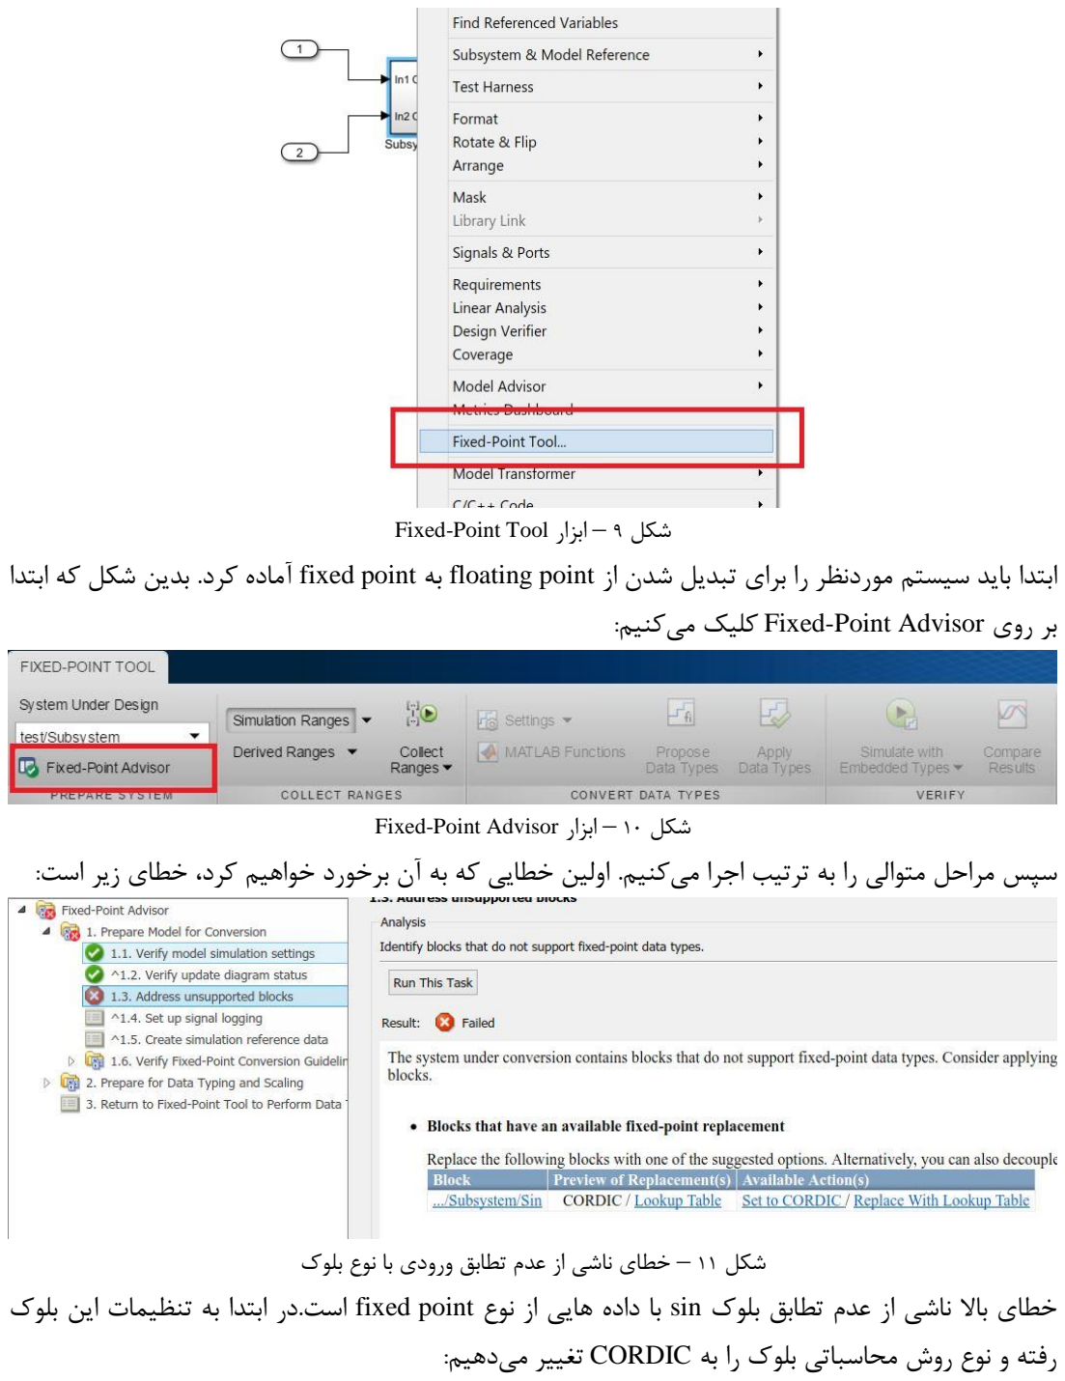
[picture p52: page 6]

Fixed-Point Tool | ابزار – 9 | شکل
ابتدا باید سيستم موردنظر را برای تبدیل شدن از point floating به point fixed آماده کرد. بدین شکل که ابتدا

بر روی Advisor Point-Fixed کليک میکنيم:

Fixed-Point Advisor | ابزار – 90 | شکل
سپس مراحل متوالی را به ترتيب اجرا میکنيم. اولين خطایی که به آن برخورد خواهيم کرد، خطای زیر است:

شکل 99 – خطای ناشی از عدم تطابق ورودی با نوع بلوک
خطای باال ناشی از عدم تطابق بلوک sin با داده هایی از نوع point fixed است.در ابتدا به تنظيمات این بلوک رفته و نوع روش محاسباتی بلوک را به CORDIC تغيير میدهيم:

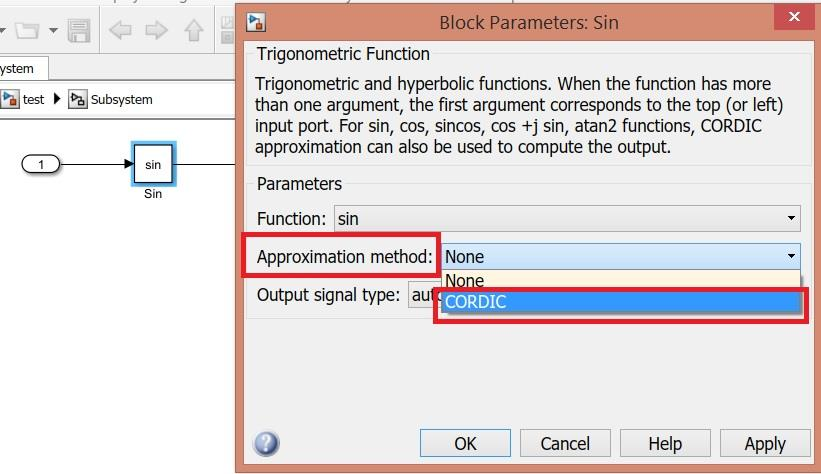
[picture p53: figure]

شکل 92 – تغيير روش محاسبات بلوک sin
با انتخاب این گزینه همچنين تعداد تکرارهای مبتنی بر الگوریتم CORDIC را نيز میتوان انتخاب کرد. هشدار بعدی مربوط به log کردن حداقل یک سيگنال است که برای شبيهسازی سيستم توسط خود نرمافزار به کار میرود. بهتر است سيگنال ورودی را برای این کار انتخاب کنيم. طریقه log کردن سيگنال نيز در شکل زیر نشان داده شده:

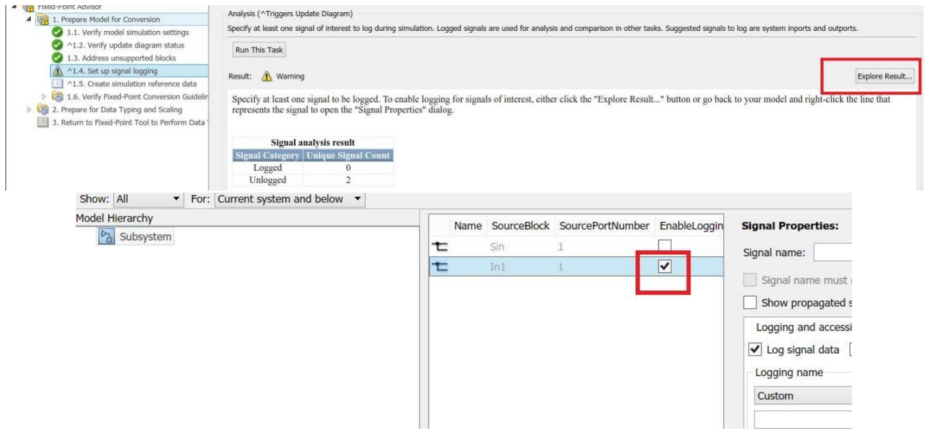
[picture p54: figure]

شکل 93 – log کردن سيگنال ها
بعد از طی شدن مراحل باال به هشدار زیر که باز به نوع برخورد با سيگنال مرجع برای شبيهسازی است، برخورد خواهيم کرد و سپس باز هم با استفاده از دکمه All Modify و اجرای دوباره این مشکل را برطرف میکنيم.

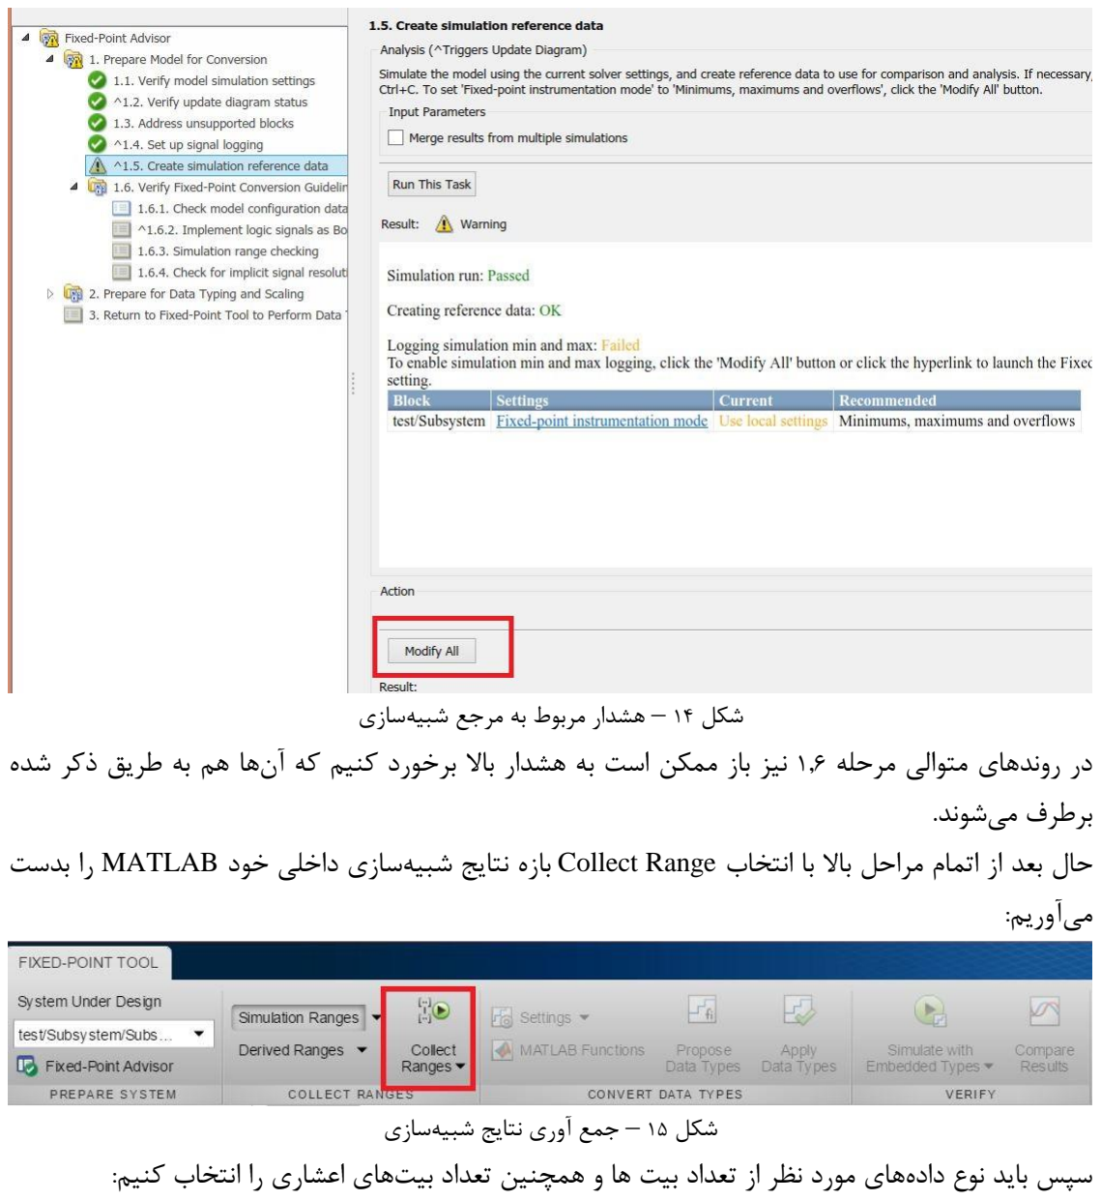
[picture p55: page 8]

شکل 94 – هشدار مربوط به مرجع شبيهسازی
در روندهای متوالی مرحله 9.6 نيز باز ممکن است به هشدار باال برخورد کنيم که آنها هم به طریق ذکر شده برطرف میشوند.
حال بعد از اتمام مراحل باال با انتخاب Range Collect بازه نتایج شبيهسازی داخلی خود MATLAB را بدست میآوریم:

شکل 95 – جمع آوری نتایج شبيهسازی
سپس باید نوع دادههای مورد نظر از تعداد بيت ها و همچنين تعداد بيتهای اعشاری را انتخاب کنيم:

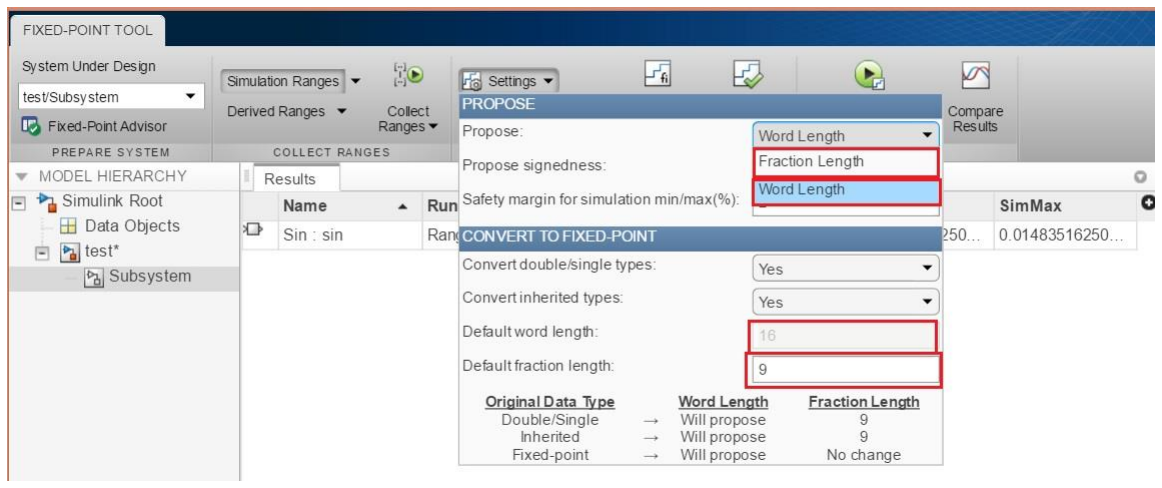
[picture p56: figure]

شکل 96 – انتخاب نوع داده ها
با انتخاب Length Fraction به عنوان پارامتر ثابت انتخاب طول Word برای ما باز میشود و سپس با انتخاب Length Word به عنوان پارامتر ثابت میتوانيم تعداد بيت اعشاری را انتخاب کنيم. چون در اینجا طول Word مد نظر است پس آن را به عنوان هدف انتخاب میکنيم. سپس با انتخاب Types Data Propose هدف را نهایی خواهيم کرد و بعد با انتخاب تيک نشان داده شده نوع داده مورد نظر را تایيد نهایی و با کليک بر Types Data Apply کار را تکميل میکنيم. همانگونه که در شکل زیر نشان داده شده است، نوع خروجی خود به خود به (1,16,14)fixdt تغيير میکند و چون سينوس یک زاویه بين 1 و -1 میباشد، پس نوع خروجی نيز درست مشخص شده است.

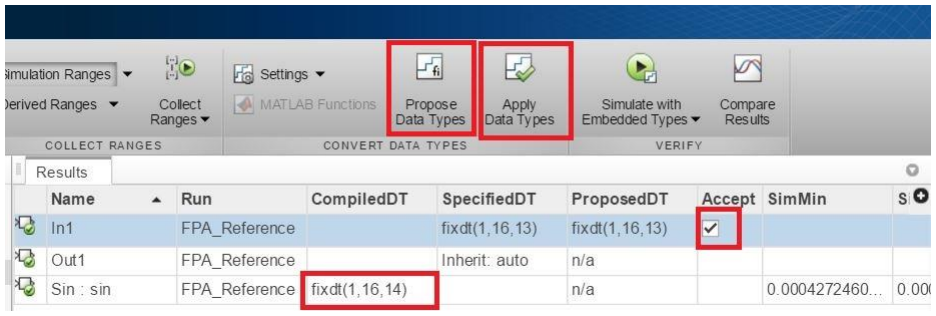
[picture p57: figure]

شکل 97 – نحوه تثبيت نوع داده ها
مابقی مراحل هم که برای توليد کد HDL است همانند مثال قبلی میباشد.
