soheil647/High_Level_Synthesis/Chisel_Introduction/CA5/Chisel/chisel-installation.pdf

# Chisel Installation

## Jonathan Bachrach EECS Department, UC Berkeley {jrb}@eecs.berkeley.edu

## August 29, 2014

# 1 Introduction

## This document is an installation guide for Chisel (Con-

structing Hardware In a Scala Embedded Language).

## Chisel is a hardware construction language embed-

ded in the high-level programming language Scala.

## 1.1 Github

### - Get an account on www.github.com

## - Register your public key on github.com

## 1.2 Development Tool Installation

### 1.2.1 MacOSX

1. Install XCODE including console tools.

## 2. Install MacPorts from http://www.macports.org

## From there install the following MacPorts packages:

### 1. git

### 2. openjdk6

## using

sudo p o r t i n s t a l l

### 1.2.2 Linux

## To install Chisel on Linux, install the following packages:

### 1. git

2. g++

### 3. openjdk-7-jre

### 4. openjdk-7-jdk

## using

sudo apt - g e t i n s t a l l

# 2 Setting Up Tutorial

## cd above directory = $DIR you’ve chosen to place Chisel tutorial and type:

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

## Your copy of the Chisel Tutorial repository will then be in $DIR/chisel-tutorial. Define this as a variable in your bash environment: The following is the Chisel tutorial directory structure:

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

The tutorial is split into problems and solutions,

## where the problems have some piece of the design to be filled in by the user and where the solutions are meant to be complete designs that should pass the given tests. In order to run either, you change directory into the appropriate subdirectory and type make of the particular lesson name:

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

## or you can run all tests using

1

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

## and the output should show that all tests have

passed.

## In order to produce Verilog, just do the following:

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

# 3 Creating Your Own Projects

## SBT has a particular directory structure that we adhere to and somewhat improve. Assuming that we have a project named gpu, then the following would be the directory structure template:

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

## and the following is the build.scala template:

import s b t ._
import Keys ._

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

## If you want to update your version of Chisel, all you have to do is change the version number for

Chisel. For instance,

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

## is using release 1.0, and

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

## is using release 1.0.1

2
