soheil647/High_Level_Synthesis/Catapult_ImageProssesing/result.txt

53	83	83	83	83	81	80	78	78	78	78	78	78	78	78	78	78	78	78	78	78	78	78	78	78	78	78	78	78	78	78	78	78	80	79	80	78	78	80	81	83	82	81	81	81	83	83	83	83	83	83	81	82	80	81	81	79	82	81	83	83	83	83	83	83	83	84	84	85	86	86	87	87	86	87	86	85	84	83	83	81	82	81	81	80	77	77	75	76	73	72	69	68	65	63	60	57	54	51	48	47	45	45	45	45	45	45	47	46	47	47	46	49	46	47	45	45	47	48	48	47	45	45	45	47	46	49	48	50	50	50	50	50	50	50	51	52	51	51	50	51	51	52	52	51	51	51	51	52	52	53	52	51	50	50	50	50	50	51	51	51	50	50	50	50	50	50	50	50	50	50	51	51	51	50	50	50	50	50	51	51	52	50	50	51	51	52	52	53	53	53	53	54	56	55	57	54	55	53	53	53	53	55	54	55	55	54	55	53	53	55	54	55	53	53	53	53	53	53	53	53	53	53	53	52	52	52	53	53	53	53	53	53	53	53	53	53	53	53	53	53	53	52	52	52	52	52	50	51	52	53	53	53	52	51	50	51	51	51	50	50	50	50	50	50	50	51	51	52	52	53	53	52	52	52	53	53	53	53	53	53	53	52	52	52	53	52	51	50	48	49	46	47	45	45	44	44	44	44	44	43	40	40	39	41	41	42	41	42	41	41	41	42	41	43	41	43	44	45	45	45	45	44	42	42	41	41	41	41	41	41	42	41	42	41	41	39	40	37	38	36	38	37	38	36	36	36	35	32	32	31	33	31	30	28	28	28	28	28	28	30	29	30	30	29	30	28	27	29	28	30	27	27	26	26	25	25	25	25	25	26	27	28	26	26	25	25	25	25	26	27	28	28	30	32	40	46	54	57	60	63	65	67	68	68	68	67	65	63	61	61	61	60	56	51	44	36	31	27	24	22	20	20	20	19	19	20	19	19	20	19	19	19	19	19	18	19	19	19	19	19	19	19	18	18	18	19	20	19	20	20	20	19	22	23	25	23	22	20	20	21	20	21	20	20	20	20	19	20	22	23	26	26	26	28	31	38	43	46	45	43	44	42	40	37	34	31	30	27	26	25	25	25	25	25	25	26	26	27	27	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
