soheil647/High_Level_Synthesis/Catapult_ImageProssesing/ESL_modelsim/result.txt

35
53
53
53
53
51
50
4e
4e
4e
4e
4e
4e
4e
4e
4e
4e
4e
4e
4e
4e
4e
4e
4e
4e
4e
4e
4e
4e
4e
4e
4e
4e
50
4f
50
4e
4e
50
51
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
ae
a5
80
54
32
2c
2d
2f
2a
26
23
21
20
22
25
25
29
2b
2e
31
33
37
3f
41
42
3d
31
2a
27
29
2e
34
36
37
3b
42
49
4e
4c
4c
46
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
ae
96
6a
3d
29
2a
2d
2c
28
24
21
20
21
23
26
2a
2b
30
34
37
3b
3e
3d
3c
37
2f
2b
27
28
2a
2c
2f
33
34
36
3d
44
44
3e
3a
3a
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
