soheil647/High_Level_Synthesis/Catapult_ImageProssesing/Result Summery.pdf

Image Processing

### چکیده:

این ازمایش درباره ی پردازش تصویر ساده با استفاده از HLS است که ما در این جا از Catapult استفاده کرده ایم.

### مقدمه:

در این ازمایش ابتدا عکسی را به وسیله ی matlab به پیکسل های ان تبدیل کرده سپس در کرنل مخصوصی ضرب می شوند و توسط catapult اجرا می شود و 1 ram و یک rom می نویسیم و دیتا ی جدید را ذخیره می کنیم و سپس به وسیله ی متلب ان را نمایش می دهیم

انجام پروژه:

### مرحله:1

ابتده عکس داده شده را به پیکسل هایش تبدیل می کنیم که چون عکس سیاه سفید است از هر پیکسل فقط 1 مقدار داریم. این کار را با متلب و دستور imread انجام می دهیم

### مرحله:2

سپس کرنل خود را پیدا کردیم)Blur Gaussian 3 × 3 )

### مرحله:3

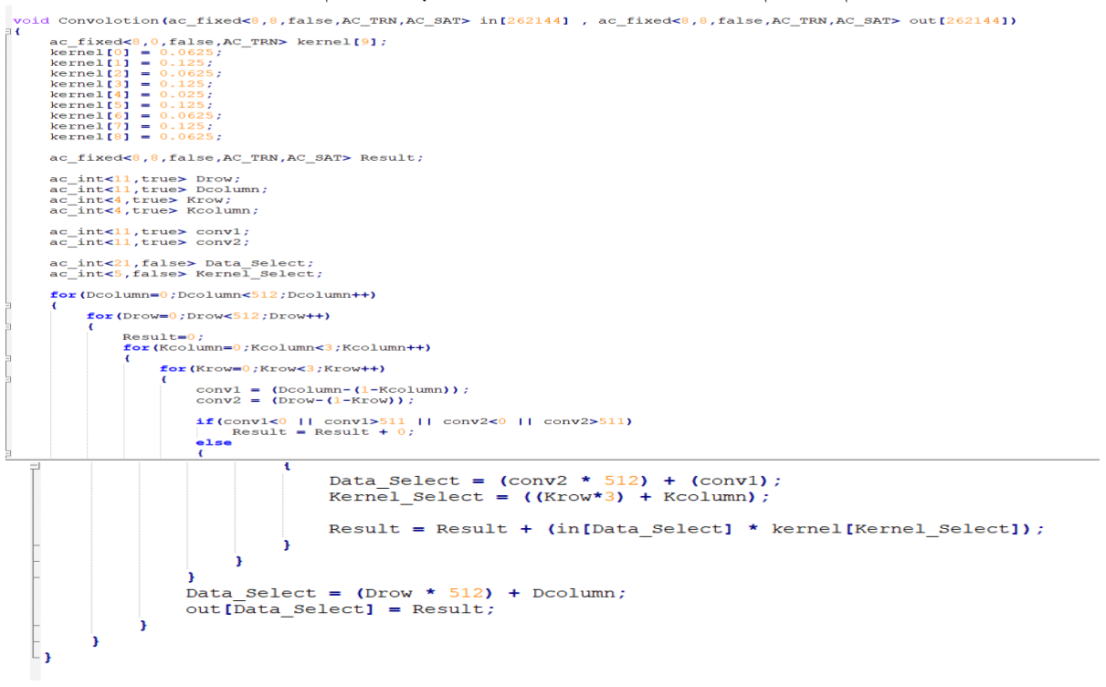
[picture p61: figure]

برنامه ای به زبان C می نویسیم و الگریتم ضرب را در ان همان طور که گفته شده پیاده می کنیم

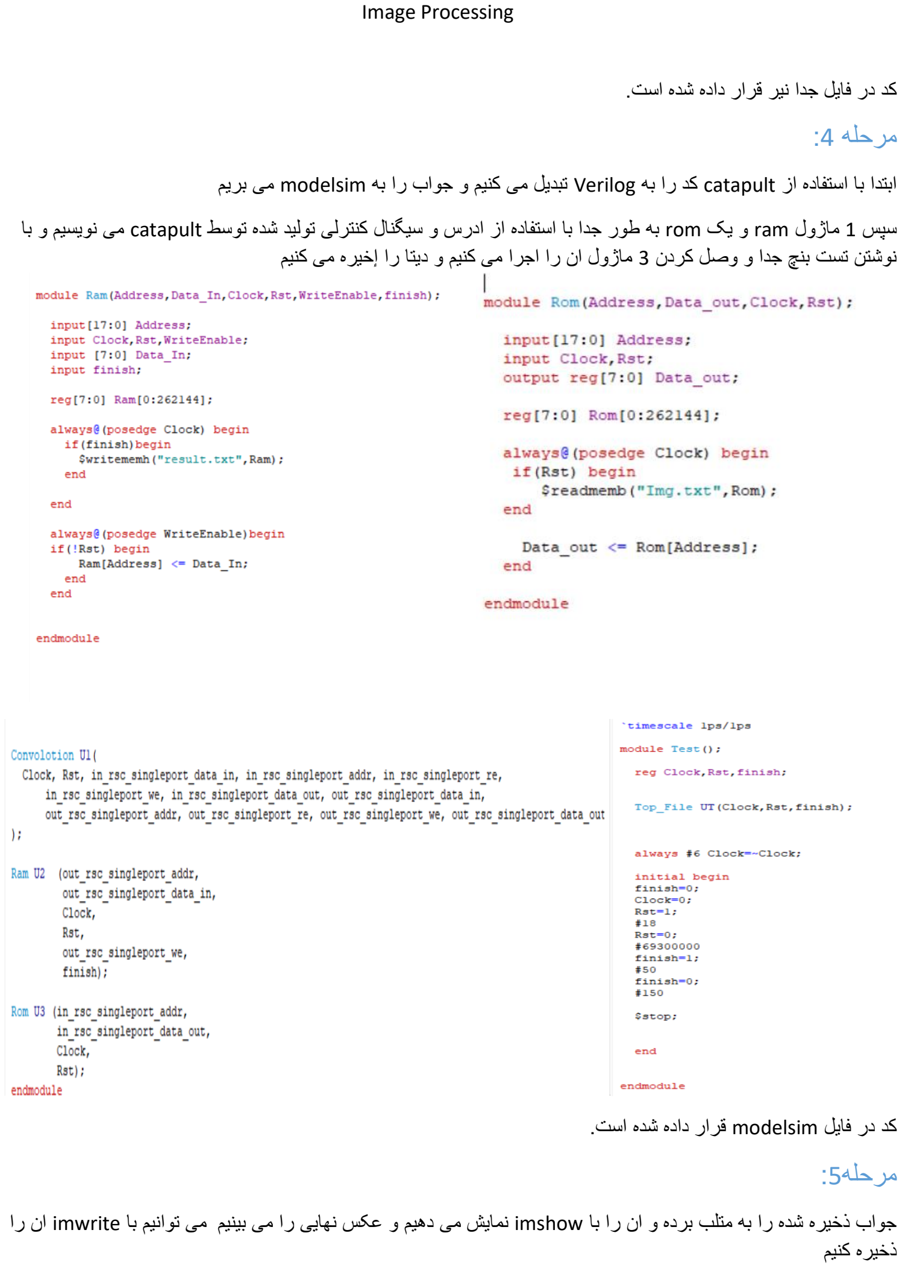
[picture p62: page 2]

کد در فایل جدا نیر قرار داده شده است.

### مرحله :4

ابتدا با استفاده از catapult کد را به Verilog تبدیل می کنیم و جواب را به modelsim می بریم

سپس 1 ماژول ram و یک rom به طور جدا با استفاده ا ز ادرس و سیگنال کنترلی تولید شده توسط catapult می نویسیم و با نوشتن تست بنچ جدا و وصل کردن 3 ماژول ان را اجرا می کنیم و دیتا را إخیره می کنیم

کد در فایل modelsim قرار داده شده است.

### مرحله:5

جواب ذخیره شده را به متلب برده و ان را با imshow نمایش می دهیم و عکس نهایی را می بینیم می توانیم با imwrite ان را ذخیره کنیم

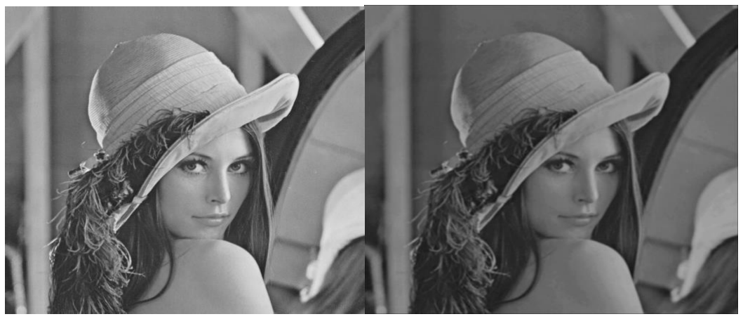
[picture p63: figure]

a:input | b:output

می بینیم که عکس همان طور که انتظار می رفت Blur شده است

### مرحله:۶

قبل از pipelining loop :

Latency Cycle: 5767165, Latency Time: 115343300.00, Slack: 10.57

Throughput Cycle: 5767681, Throughput Time: 115353620.00, Area: 505.82

:Main Loop Pipeline

Latency Cycle: 4718790, Latency Time: 94371800.00, Slack: 10.88

Throughput Cycle: 4718592, Throughput Time: 94371840.00, Area: 667.21

:First Loop Pipeline (Row of pixels)

Latency Cycle: 4718790, Latency Time: 94371800.00, Slack: 9.75

Throughput Cycle: 4718594, Throughput Time: 94371880.00, Area: 614.12

:Second Loop Pipeline (Column of pixels)

Latency Cycle: 4719101, Latency Time: 94382020.00, Slack: 10.88

Throughput Cycle: 4719617, Throughput Time: 94392340.00, Area: 573.95

:Third Loop Pipeline (Row of kernel)

Latency Cycle: 4980733, Latency Time: 99614660.00, Slack: 10.88

Throughput Cycle: 4981249, Throughput Time: 99624980.00, Area: 521.43

:Fourth Loop Pipeline (Column of kernel)

Latency Cycle: 5767165, Latency Time: 115343300.0.00, Slack: 10.566727

Throughput Cycle: 5767681, Throughput Time: 115353620.0.00, Area: 505.8216669600001

تمام حاالت باال برای 2=II انجام شده است

### مرحله :۷

قبل از Unrolling loop :

Latency Cycle: 5767165, Latency Time: 115343300.00, Slack: 10.57

Throughput Cycle: 5767681, Throughput Time: 115353620.00, Area: 505.82

:First Loop Unroll (Row of pixels)

Latency Cycle: 6041087, Latency Time: 120821740.00, Slack: 10.566727

Throughput Cycle: 6041602, Throughput Time: 120832040.00, Area: 560.4563520700001

:Second Loop Unroll (Column of pixels)

Latency Cycle: 6041085, Latency Time: 120821700.00, Slack: 10.566727

Throughput Cycle: 6041601, Throughput Time: 120832020.00, Area: 553.47773927

:Third Loop Unroll (Row of kernel)

Latency Cycle: 4980733, Latency Time: 99614660.00, Slack: 9.433713

Throughput Cycle: 4981249, Throughput Time: 99624980.0, Area: 542.64190249

:Fourth Loop Unroll (Column of kernel)

Latency Cycle: 3407869, Latency Time: 68157380.0, Slack: 5.8345590000000005

Throughput Cycle: 3408385, Throughput Time: 68167700.0, Area: 620.6673237

تمام کار های باال با unroll partialبا 3=ii انجام شده است ) نمی توانست بدون partial انرول کند(

### مرحله :۸

با تغییر در ساختار کد می توان Area یای کمتری استفاده کرد ) می توان ریسورس ها را ایتیمایز کرد(

و اگر کد به صورت Class نوشته شود با کمترین تغییر تو کد میشه ازش استفاده کرد.
