soheil647/High_Level_Synthesis/Catapult_ImageProssesing/Catapult/Convolotion.v15/concat_rtl.vhdl

--------> ./rtl_funcs.vhd 
-----------------------------------------------------------------------
-- Package that declares synthesizable functions needed for RTL output
-----------------------------------------------------------------------

library ieee;
use ieee.std_logic_1164.all;
use ieee.std_logic_arith.all;

PACKAGE funcs IS

-----------------------------------------------------------------
-- utility functions
-----------------------------------------------------------------

   FUNCTION TO_STDLOGIC(arg1: BOOLEAN) RETURN STD_LOGIC;
   FUNCTION TO_STDLOGIC(arg1: STD_ULOGIC_VECTOR(0 DOWNTO 0)) RETURN STD_LOGIC;
   FUNCTION TO_STDLOGIC(arg1: STD_LOGIC_VECTOR(0 DOWNTO 0)) RETURN STD_LOGIC;
   FUNCTION TO_STDLOGIC(arg1: UNSIGNED) RETURN STD_LOGIC;
   FUNCTION TO_STDLOGIC(arg1: SIGNED(0 DOWNTO 0)) RETURN STD_LOGIC;
   FUNCTION TO_STDLOGICVECTOR(arg1: STD_LOGIC) RETURN STD_LOGIC_VECTOR;

   FUNCTION maximum(arg1, arg2 : INTEGER) RETURN INTEGER;
   FUNCTION minimum(arg1, arg2 : INTEGER) RETURN INTEGER;
   FUNCTION ifeqsel(arg1, arg2, seleq, selne : INTEGER) RETURN INTEGER;
   FUNCTION resolve_std_logic_vector(input1: STD_LOGIC_VECTOR; input2 : STD_LOGIC_VECTOR) RETURN STD_LOGIC_VECTOR;

-----------------------------------------------------------------
-- logic functions
-----------------------------------------------------------------

   FUNCTION and_s(inputs: STD_LOGIC_VECTOR) RETURN STD_LOGIC;
   FUNCTION or_s (inputs: STD_LOGIC_VECTOR) RETURN STD_LOGIC;
   FUNCTION xor_s(inputs: STD_LOGIC_VECTOR) RETURN STD_LOGIC;

   FUNCTION and_v(inputs: STD_LOGIC_VECTOR; olen: POSITIVE) RETURN STD_LOGIC_VECTOR;
   FUNCTION or_v (inputs: STD_LOGIC_VECTOR; olen: POSITIVE) RETURN STD_LOGIC_VECTOR;
   FUNCTION xor_v(inputs: STD_LOGIC_VECTOR; olen: POSITIVE) RETURN STD_LOGIC_VECTOR;

-----------------------------------------------------------------
-- mux functions
-----------------------------------------------------------------

   FUNCTION mux_s(inputs: STD_LOGIC_VECTOR; sel: STD_LOGIC       ) RETURN STD_LOGIC;
   FUNCTION mux_s(inputs: STD_LOGIC_VECTOR; sel: STD_LOGIC_VECTOR) RETURN STD_LOGIC;
   FUNCTION mux_v(inputs: STD_LOGIC_VECTOR; sel: STD_LOGIC       ) RETURN STD_LOGIC_VECTOR;
   FUNCTION mux_v(inputs: STD_LOGIC_VECTOR; sel: STD_LOGIC_VECTOR) RETURN STD_LOGIC_VECTOR;

   FUNCTION mux1hot_s(inputs: STD_LOGIC_VECTOR; sel: STD_LOGIC_VECTOR) RETURN STD_LOGIC;
   FUNCTION mux1hot_v(inputs: STD_LOGIC_VECTOR; sel: STD_LOGIC_VECTOR) RETURN STD_LOGIC_VECTOR;

-----------------------------------------------------------------
-- latch functions
-----------------------------------------------------------------
   FUNCTION lat_s(dinput: STD_LOGIC       ; clk: STD_LOGIC; doutput: STD_LOGIC       ) RETURN STD_LOGIC;
   FUNCTION lat_v(dinput: STD_LOGIC_VECTOR; clk: STD_LOGIC; doutput: STD_LOGIC_VECTOR) RETURN STD_LOGIC_VECTOR;

-----------------------------------------------------------------
-- tristate functions
-----------------------------------------------------------------
--   FUNCTION tri_s(dinput: STD_LOGIC       ; control: STD_LOGIC) RETURN STD_LOGIC;
--   FUNCTION tri_v(dinput: STD_LOGIC_VECTOR; control: STD_LOGIC) RETURN STD_LOGIC_VECTOR;

-----------------------------------------------------------------
-- compare functions returning STD_LOGIC
-- in contrast to the functions returning boolean
-----------------------------------------------------------------

   FUNCTION "=" (l, r: UNSIGNED) RETURN STD_LOGIC;
   FUNCTION "=" (l, r: SIGNED  ) RETURN STD_LOGIC;
   FUNCTION "/="(l, r: UNSIGNED) RETURN STD_LOGIC;
   FUNCTION "/="(l, r: SIGNED  ) RETURN STD_LOGIC;
   FUNCTION "<="(l, r: UNSIGNED) RETURN STD_LOGIC;
   FUNCTION "<="(l, r: SIGNED  ) RETURN STD_LOGIC;
   FUNCTION "<" (l, r: UNSIGNED) RETURN STD_LOGIC;
   FUNCTION "<" (l, r: SIGNED  ) RETURN STD_LOGIC;
   FUNCTION ">="(l, r: UNSIGNED) RETURN STD_LOGIC;
   FUNCTION ">="(l, r: SIGNED  ) RETURN STD_LOGIC;
   FUNCTION ">" (l, r: UNSIGNED) RETURN STD_LOGIC;
   FUNCTION ">" (l, r: SIGNED  ) RETURN STD_LOGIC;

   -- RETURN 2 bits (left => lt, right => eq)
   FUNCTION cmp (l, r: STD_LOGIC_VECTOR) RETURN STD_LOGIC;

-----------------------------------------------------------------
-- Vectorized Overloaded Arithmetic Operators
-----------------------------------------------------------------

   FUNCTION faccu(arg: UNSIGNED; width: NATURAL) RETURN UNSIGNED;

   FUNCTION fabs(arg1: SIGNED  ) RETURN UNSIGNED;

   FUNCTION "/"  (l, r: UNSIGNED) RETURN UNSIGNED;
   FUNCTION "MOD"(l, r: UNSIGNED) RETURN UNSIGNED;
   FUNCTION "REM"(l, r: UNSIGNED) RETURN UNSIGNED;
   FUNCTION "**" (l, r: UNSIGNED) RETURN UNSIGNED;

   FUNCTION "/"  (l, r: SIGNED  ) RETURN SIGNED  ;
   FUNCTION "MOD"(l, r: SIGNED  ) RETURN SIGNED  ;
   FUNCTION "REM"(l, r: SIGNED  ) RETURN SIGNED  ;
   FUNCTION "**" (l, r: SIGNED  ) RETURN SIGNED  ;

-----------------------------------------------------------------
--               S H I F T   F U C T I O N S
-- negative shift shifts the opposite direction
-- *_stdar functions use shift functions from std_logic_arith
-----------------------------------------------------------------

   FUNCTION fshl(arg1: UNSIGNED; arg2: UNSIGNED; olen: POSITIVE) RETURN UNSIGNED;
   FUNCTION fshr(arg1: UNSIGNED; arg2: UNSIGNED; olen: POSITIVE) RETURN UNSIGNED;
   FUNCTION fshl(arg1: UNSIGNED; arg2: SIGNED  ; olen: POSITIVE) RETURN UNSIGNED;
   FUNCTION fshr(arg1: UNSIGNED; arg2: SIGNED  ; olen: POSITIVE) RETURN UNSIGNED;

   FUNCTION fshl(arg1: SIGNED  ; arg2: UNSIGNED; olen: POSITIVE) RETURN SIGNED  ;
   FUNCTION fshr(arg1: SIGNED  ; arg2: UNSIGNED; olen: POSITIVE) RETURN SIGNED  ;
   FUNCTION fshl(arg1: SIGNED  ; arg2: SIGNED  ; olen: POSITIVE) RETURN SIGNED  ;
   FUNCTION fshr(arg1: SIGNED  ; arg2: SIGNED  ; olen: POSITIVE) RETURN SIGNED  ;

   FUNCTION fshl(arg1: UNSIGNED; arg2: UNSIGNED; sbit: STD_LOGIC; olen: POSITIVE) RETURN UNSIGNED;
   FUNCTION fshr(arg1: UNSIGNED; arg2: UNSIGNED; sbit: STD_LOGIC; olen: POSITIVE) RETURN UNSIGNED;
   FUNCTION fshl(arg1: UNSIGNED; arg2: SIGNED  ; sbit: STD_LOGIC; olen: POSITIVE) RETURN UNSIGNED;
   FUNCTION fshr(arg1: UNSIGNED; arg2: SIGNED  ; sbit: STD_LOGIC; olen: POSITIVE) RETURN UNSIGNED;

   FUNCTION frot(arg1: STD_LOGIC_VECTOR; arg2: STD_LOGIC_VECTOR; signd2: BOOLEAN; sdir: INTEGER range -1 TO 1) RETURN STD_LOGIC_VECTOR;
   FUNCTION frol(arg1: STD_LOGIC_VECTOR; arg2: UNSIGNED) RETURN STD_LOGIC_VECTOR;
   FUNCTION fror(arg1: STD_LOGIC_VECTOR; arg2: UNSIGNED) RETURN STD_LOGIC_VECTOR;
   FUNCTION frol(arg1: STD_LOGIC_VECTOR; arg2: SIGNED  ) RETURN STD_LOGIC_VECTOR;
   FUNCTION fror(arg1: STD_LOGIC_VECTOR; arg2: SIGNED  ) RETURN STD_LOGIC_VECTOR;

   -----------------------------------------------------------------
   -- *_stdar functions use shift functions from std_logic_arith
   -----------------------------------------------------------------
   FUNCTION fshl_stdar(arg1: UNSIGNED; arg2: UNSIGNED; olen: POSITIVE) RETURN UNSIGNED;
   FUNCTION fshr_stdar(arg1: UNSIGNED; arg2: UNSIGNED; olen: POSITIVE) RETURN UNSIGNED;
   FUNCTION fshl_stdar(arg1: UNSIGNED; arg2: SIGNED  ; olen: POSITIVE) RETURN UNSIGNED;
   FUNCTION fshr_stdar(arg1: UNSIGNED; arg2: SIGNED  ; olen: POSITIVE) RETURN UNSIGNED;

   FUNCTION fshl_stdar(arg1: SIGNED  ; arg2: UNSIGNED; olen: POSITIVE) RETURN SIGNED  ;
   FUNCTION fshr_stdar(arg1: SIGNED  ; arg2: UNSIGNED; olen: POSITIVE) RETURN SIGNED  ;
   FUNCTION fshl_stdar(arg1: SIGNED  ; arg2: SIGNED  ; olen: POSITIVE) RETURN SIGNED  ;
   FUNCTION fshr_stdar(arg1: SIGNED  ; arg2: SIGNED  ; olen: POSITIVE) RETURN SIGNED  ;

   FUNCTION fshl_stdar(arg1: UNSIGNED; arg2: UNSIGNED; sbit: STD_LOGIC; olen: POSITIVE) RETURN UNSIGNED;
   FUNCTION fshr_stdar(arg1: UNSIGNED; arg2: UNSIGNED; sbit: STD_LOGIC; olen: POSITIVE) RETURN UNSIGNED;
   FUNCTION fshl_stdar(arg1: UNSIGNED; arg2: SIGNED  ; sbit: STD_LOGIC; olen: POSITIVE) RETURN UNSIGNED;
   FUNCTION fshr_stdar(arg1: UNSIGNED; arg2: SIGNED  ; sbit: STD_LOGIC; olen: POSITIVE) RETURN UNSIGNED;

-----------------------------------------------------------------
-- indexing functions: LSB always has index 0
-----------------------------------------------------------------

   FUNCTION readindex(vec: STD_LOGIC_VECTOR; index: INTEGER                 ) RETURN STD_LOGIC;
   FUNCTION readslice(vec: STD_LOGIC_VECTOR; index: INTEGER; width: POSITIVE) RETURN STD_LOGIC_VECTOR;

   FUNCTION writeindex(vec: STD_LOGIC_VECTOR; dinput: STD_LOGIC       ; index: INTEGER) RETURN STD_LOGIC_VECTOR;
   FUNCTION n_bits(p: NATURAL) RETURN POSITIVE;
   --FUNCTION writeslice(vec: STD_LOGIC_VECTOR; dinput: STD_LOGIC_VECTOR; index: INTEGER) RETURN STD_LOGIC_VECTOR;
   FUNCTION writeslice(vec: STD_LOGIC_VECTOR; dinput: STD_LOGIC_VECTOR; enable: STD_LOGIC_VECTOR; byte_width: INTEGER;  index: INTEGER) RETURN STD_LOGIC_VECTOR ;

   FUNCTION ceil_log2(size : NATURAL) return NATURAL;
   FUNCTION bits(size : NATURAL) return NATURAL;
END funcs;


--------------------------- B O D Y ----------------------------


PACKAGE BODY funcs IS

-----------------------------------------------------------------
-- utility functions
-----------------------------------------------------------------

   FUNCTION TO_STDLOGIC(arg1: BOOLEAN) RETURN STD_LOGIC IS
     BEGIN IF arg1 THEN RETURN '1'; ELSE RETURN '0'; END IF; END;
   FUNCTION TO_STDLOGIC(arg1: STD_ULOGIC_VECTOR(0 DOWNTO 0)) RETURN STD_LOGIC IS
     BEGIN RETURN arg1(0); END;
   FUNCTION TO_STDLOGIC(arg1: STD_LOGIC_VECTOR(0 DOWNTO 0)) RETURN STD_LOGIC IS
     BEGIN RETURN arg1(0); END;
   FUNCTION TO_STDLOGIC(arg1: UNSIGNED) RETURN STD_LOGIC IS
     BEGIN RETURN arg1(0); END;
   FUNCTION TO_STDLOGIC(arg1: SIGNED(0 DOWNTO 0)) RETURN STD_LOGIC IS
     BEGIN RETURN arg1(0); END;

   FUNCTION TO_STDLOGICVECTOR(arg1: STD_LOGIC) RETURN STD_LOGIC_VECTOR IS
     VARIABLE result: STD_LOGIC_VECTOR(0 DOWNTO 0);
   BEGIN
     result := (0 => arg1);
     RETURN result;
   END;

   FUNCTION maximum (arg1,arg2: INTEGER) RETURN INTEGER IS
   BEGIN
     IF(arg1 > arg2) THEN
       RETURN(arg1) ;
     ELSE
       RETURN(arg2) ;
     END IF;
   END;

   FUNCTION minimum (arg1,arg2: INTEGER) RETURN INTEGER IS
   BEGIN
     IF(arg1 < arg2) THEN
       RETURN(arg1) ;
     ELSE
       RETURN(arg2) ;
     END IF;
   END;

   FUNCTION ifeqsel(arg1, arg2, seleq, selne : INTEGER) RETURN INTEGER IS
   BEGIN
     IF(arg1 = arg2) THEN
       RETURN(seleq) ;
     ELSE
       RETURN(selne) ;
     END IF;
   END;

   FUNCTION resolve_std_logic_vector(input1: STD_LOGIC_VECTOR; input2: STD_LOGIC_VECTOR) RETURN STD_LOGIC_VECTOR IS
     CONSTANT len: INTEGER := input1'length;
     ALIAS input1a: STD_LOGIC_VECTOR(len-1 DOWNTO 0) IS input1;
     ALIAS input2a: STD_LOGIC_VECTOR(len-1 DOWNTO 0) IS input2;
     VARIABLE result: STD_LOGIC_VECTOR(len-1 DOWNTO 0) := (others=>'0');
   BEGIN
     result := (others => '0');
--pragma translate_off
     FOR i IN len-1 DOWNTO 0 LOOP
       result(i) := resolved(input1a(i) & input2a(i));
     END LOOP;
--pragma translate_on
     RETURN result;
   END;

   FUNCTION resolve_unsigned(input1: UNSIGNED; input2: UNSIGNED) RETURN UNSIGNED IS
   BEGIN RETURN UNSIGNED(resolve_std_logic_vector(STD_LOGIC_VECTOR(input1), STD_LOGIC_VECTOR(input2))); END;

   FUNCTION resolve_signed(input1: SIGNED; input2: SIGNED) RETURN SIGNED IS
   BEGIN RETURN SIGNED(resolve_std_logic_vector(STD_LOGIC_VECTOR(input1), STD_LOGIC_VECTOR(input2))); END;

-----------------------------------------------------------------
-- Logic Functions
-----------------------------------------------------------------

   FUNCTION "not"(arg1: UNSIGNED) RETURN UNSIGNED IS
     BEGIN RETURN UNSIGNED(not STD_LOGIC_VECTOR(arg1)); END;
   FUNCTION and_s(inputs: STD_LOGIC_VECTOR) RETURN STD_LOGIC IS
     BEGIN RETURN TO_STDLOGIC(and_v(inputs, 1)); END;
   FUNCTION or_s (inputs: STD_LOGIC_VECTOR) RETURN STD_LOGIC IS
     BEGIN RETURN TO_STDLOGIC(or_v(inputs, 1)); END;
   FUNCTION xor_s(inputs: STD_LOGIC_VECTOR) RETURN STD_LOGIC IS
     BEGIN RETURN TO_STDLOGIC(xor_v(inputs, 1)); END;

   FUNCTION and_v(inputs: STD_LOGIC_VECTOR; olen: POSITIVE) RETURN STD_LOGIC_VECTOR IS
     CONSTANT ilen: POSITIVE := inputs'length;
     CONSTANT ilenM1: POSITIVE := ilen-1; --2.1.6.3
     CONSTANT olenM1: INTEGER := olen-1; --2.1.6.3
     CONSTANT ilenMolenM1: INTEGER := ilen-olen-1; --2.1.6.3
     VARIABLE inputsx: STD_LOGIC_VECTOR(ilen-1 DOWNTO 0);
     CONSTANT icnt2: POSITIVE:= inputs'length/olen;
     VARIABLE result: STD_LOGIC_VECTOR(olen-1 DOWNTO 0);
   BEGIN
--pragma translate_off
     ASSERT ilen REM olen = 0 SEVERITY FAILURE;
--pragma translate_on
     inputsx := inputs;
     result := inputsx(olenM1 DOWNTO 0);
     FOR i IN icnt2-1 DOWNTO 1 LOOP
       inputsx(ilenMolenM1 DOWNTO 0) := inputsx(ilenM1 DOWNTO olen);
       result := result AND inputsx(olenM1 DOWNTO 0);
     END LOOP;
     RETURN result;
   END;

   FUNCTION or_v(inputs: STD_LOGIC_VECTOR; olen: POSITIVE) RETURN STD_LOGIC_VECTOR IS
     CONSTANT ilen: POSITIVE := inputs'length;
     CONSTANT ilenM1: POSITIVE := ilen-1; --2.1.6.3
     CONSTANT olenM1: INTEGER := olen-1; --2.1.6.3
     CONSTANT ilenMolenM1: INTEGER := ilen-olen-1; --2.1.6.3
     VARIABLE inputsx: STD_LOGIC_VECTOR(ilen-1 DOWNTO 0);
     CONSTANT icnt2: POSITIVE:= inputs'length/olen;
     VARIABLE result: STD_LOGIC_VECTOR(olen-1 DOWNTO 0);
   BEGIN
--pragma translate_off
     ASSERT ilen REM olen = 0 SEVERITY FAILURE;
--pragma translate_on
     inputsx := inputs;
     result := inputsx(olenM1 DOWNTO 0);
     FOR i IN icnt2-1 DOWNTO 1 LOOP
       inputsx(ilenMolenM1 DOWNTO 0) := inputsx(ilenM1 DOWNTO olen);
       result := result OR inputsx(olenM1 DOWNTO 0);
     END LOOP;
     RETURN result;
   END;

   FUNCTION xor_v(inputs: STD_LOGIC_VECTOR; olen: POSITIVE) RETURN STD_LOGIC_VECTOR IS
     CONSTANT ilen: POSITIVE := inputs'length;
     CONSTANT ilenM1: POSITIVE := ilen-1; --2.1.6.3
     CONSTANT olenM1: INTEGER := olen-1; --2.1.6.3
     CONSTANT ilenMolenM1: INTEGER := ilen-olen-1; --2.1.6.3
     VARIABLE inputsx: STD_LOGIC_VECTOR(ilen-1 DOWNTO 0);
     CONSTANT icnt2: POSITIVE:= inputs'length/olen;
     VARIABLE result: STD_LOGIC_VECTOR(olen-1 DOWNTO 0);
   BEGIN
--pragma translate_off
     ASSERT ilen REM olen = 0 SEVERITY FAILURE;
--pragma translate_on
     inputsx := inputs;
     result := inputsx(olenM1 DOWNTO 0);
     FOR i IN icnt2-1 DOWNTO 1 LOOP
       inputsx(ilenMolenM1 DOWNTO 0) := inputsx(ilenM1 DOWNTO olen);
       result := result XOR inputsx(olenM1 DOWNTO 0);
     END LOOP;
     RETURN result;
   END;

-----------------------------------------------------------------
-- Muxes
-----------------------------------------------------------------

   FUNCTION mux_sel2_v(inputs: STD_LOGIC_VECTOR; sel: STD_LOGIC_VECTOR(1 DOWNTO 0))
   RETURN STD_LOGIC_VECTOR IS
     CONSTANT size   : POSITIVE := inputs'length / 4;
     ALIAS    inputs0: STD_LOGIC_VECTOR( inputs'length-1 DOWNTO 0) IS inputs;
     VARIABLE result : STD_LOGIC_Vector( size-1 DOWNTO 0):= (others=>'0') ;
   BEGIN
     -- synthesis only
     -- simulation inconsistent with control values 'UXZHLWD'
     CASE sel IS
     WHEN "00" =>
       result := inputs0(1*size-1 DOWNTO 0*size);
     WHEN "10" =>
       result := inputs0(2*size-1 DOWNTO 1*size);
     WHEN "01" =>
       result := inputs0(3*size-1 DOWNTO 2*size);
     WHEN "11" =>
       result := inputs0(4*size-1 DOWNTO 3*size);
     WHEN others =>
--pragma translate_off
       result := (others => '0');
--pragma translate_on
     END CASE;
     RETURN result;
   END;

   FUNCTION mux_sel3_v(inputs: STD_LOGIC_VECTOR; sel: STD_LOGIC_VECTOR(2 DOWNTO 0))
   RETURN STD_LOGIC_VECTOR IS
     CONSTANT size   : POSITIVE := inputs'length / 8;
     ALIAS    inputs0: STD_LOGIC_VECTOR(inputs'length-1 DOWNTO 0) IS inputs;
     VARIABLE result : STD_LOGIC_Vector(size-1 DOWNTO 0) := (others=>'0');
   BEGIN
     -- synthesis only
     -- simulation inconsistent with control values 'UXZHLWD'
     CASE sel IS
     WHEN "000" =>
       result := inputs0(1*size-1 DOWNTO 0*size);
     WHEN "001" =>
       result := inputs0(2*size-1 DOWNTO 1*size);
     WHEN "010" =>
       result := inputs0(3*size-1 DOWNTO 2*size);
     WHEN "011" =>
       result := inputs0(4*size-1 DOWNTO 3*size);
     WHEN "100" =>
       result := inputs0(5*size-1 DOWNTO 4*size);
     WHEN "101" =>
       result := inputs0(6*size-1 DOWNTO 5*size);
     WHEN "110" =>
       result := inputs0(7*size-1 DOWNTO 6*size);
     WHEN "111" =>
       result := inputs0(8*size-1 DOWNTO 7*size);
     WHEN others =>
--pragma translate_off
       result := (others => '0');
--pragma translate_on
     END CASE;
     RETURN result;
   END;

   FUNCTION mux_sel4_v(inputs: STD_LOGIC_VECTOR; sel: STD_LOGIC_VECTOR(3 DOWNTO 0))
   RETURN STD_LOGIC_VECTOR IS
     CONSTANT size   : POSITIVE := inputs'length / 16;
     ALIAS    inputs0: STD_LOGIC_VECTOR(inputs'length-1 DOWNTO 0) IS inputs;
     VARIABLE result : STD_LOGIC_Vector(size-1 DOWNTO 0) := (others => '0');
   BEGIN
     -- synthesis only
     -- simulation inconsistent with control values 'UXZHLWD'
     CASE sel IS
     WHEN "0000" =>
       result := inputs0( 1*size-1 DOWNTO 0*size);
     WHEN "0001" =>
       result := inputs0( 2*size-1 DOWNTO 1*size);
     WHEN "0010" =>
       result := inputs0( 3*size-1 DOWNTO 2*size);
     WHEN "0011" =>
       result := inputs0( 4*size-1 DOWNTO 3*size);
     WHEN "0100" =>
       result := inputs0( 5*size-1 DOWNTO 4*size);
     WHEN "0101" =>
       result := inputs0( 6*size-1 DOWNTO 5*size);
     WHEN "0110" =>
       result := inputs0( 7*size-1 DOWNTO 6*size);
     WHEN "0111" =>
       result := inputs0( 8*size-1 DOWNTO 7*size);
     WHEN "1000" =>
       result := inputs0( 9*size-1 DOWNTO 8*size);
     WHEN "1001" =>
       result := inputs0( 10*size-1 DOWNTO 9*size);
     WHEN "1010" =>
       result := inputs0( 11*size-1 DOWNTO 10*size);
     WHEN "1011" =>
       result := inputs0( 12*size-1 DOWNTO 11*size);
     WHEN "1100" =>
       result := inputs0( 13*size-1 DOWNTO 12*size);
     WHEN "1101" =>
       result := inputs0( 14*size-1 DOWNTO 13*size);
     WHEN "1110" =>
       result := inputs0( 15*size-1 DOWNTO 14*size);
     WHEN "1111" =>
       result := inputs0( 16*size-1 DOWNTO 15*size);
     WHEN others =>
--pragma translate_off
       result := (others => '0');
--pragma translate_on
     END CASE;
     RETURN result;
   END;

   FUNCTION mux_sel5_v(inputs: STD_LOGIC_VECTOR; sel: STD_LOGIC_VECTOR(4 DOWNTO 0))
   RETURN STD_LOGIC_VECTOR IS
     CONSTANT size   : POSITIVE := inputs'length / 32;
     ALIAS    inputs0: STD_LOGIC_VECTOR(inputs'length-1 DOWNTO 0) IS inputs;
     VARIABLE result : STD_LOGIC_Vector(size-1 DOWNTO 0 ):= (others=>'0');
   BEGIN
     -- synthesis only
     -- simulation inconsistent with control values 'UXZHLWD'
     CASE sel IS
     WHEN "00000" =>
       result := inputs0( 1*size-1 DOWNTO 0*size);
     WHEN "00001" =>
       result := inputs0( 2*size-1 DOWNTO 1*size);
     WHEN "00010" =>
       result := inputs0( 3*size-1 DOWNTO 2*size);
     WHEN "00011" =>
       result := inputs0( 4*size-1 DOWNTO 3*size);
     WHEN "00100" =>
       result := inputs0( 5*size-1 DOWNTO 4*size);
     WHEN "00101" =>
       result := inputs0( 6*size-1 DOWNTO 5*size);
     WHEN "00110" =>
       result := inputs0( 7*size-1 DOWNTO 6*size);
     WHEN "00111" =>
       result := inputs0( 8*size-1 DOWNTO 7*size);
     WHEN "01000" =>
       result := inputs0( 9*size-1 DOWNTO 8*size);
     WHEN "01001" =>
       result := inputs0( 10*size-1 DOWNTO 9*size);
     WHEN "01010" =>
       result := inputs0( 11*size-1 DOWNTO 10*size);
     WHEN "01011" =>
       result := inputs0( 12*size-1 DOWNTO 11*size);
     WHEN "01100" =>
       result := inputs0( 13*size-1 DOWNTO 12*size);
     WHEN "01101" =>
       result := inputs0( 14*size-1 DOWNTO 13*size);
     WHEN "01110" =>
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
   END;

   FUNCTION mux_s(inputs: STD_LOGIC_VECTOR; sel: STD_LOGIC) RETURN STD_LOGIC IS
   BEGIN RETURN TO_STDLOGIC(mux_v(inputs, sel)); END;

   FUNCTION mux_s(inputs: STD_LOGIC_VECTOR; sel: STD_LOGIC_VECTOR) RETURN STD_LOGIC IS
   BEGIN RETURN TO_STDLOGIC(mux_v(inputs, sel)); END;

   FUNCTION mux_v(inputs: STD_LOGIC_VECTOR; sel: STD_LOGIC) RETURN STD_LOGIC_VECTOR IS  --pragma hls_map_to_operator mux
     ALIAS    inputs0: STD_LOGIC_VECTOR(inputs'length-1 DOWNTO 0) IS inputs;
     CONSTANT size   : POSITIVE := inputs'length / 2;
     CONSTANT olen   : POSITIVE := inputs'length / 2;
     VARIABLE result : STD_LOGIC_VECTOR(olen-1 DOWNTO 0) := (others=>'0');
   BEGIN
--pragma translate_off
     ASSERT inputs'length = olen * 2 SEVERITY FAILURE;
--pragma translate_on
       CASE sel IS
       WHEN '1' | 'H' =>
         result := inputs0( size-1 DOWNTO 0);
       WHEN '0' | 'L' =>
         result := inputs0(2*size-1  DOWNTO size);
       WHEN others =>
--pragma translate_off
         result := resolve_std_logic_vector(inputs0(size-1 DOWNTO 0), inputs0( 2*size-1 DOWNTO size));
--pragma translate_on
       END CASE;
       RETURN result;
   END;
--   BEGIN RETURN mux_v(inputs, TO_STDLOGICVECTOR(sel)); END;

   FUNCTION mux_v(inputs: STD_LOGIC_VECTOR; sel : STD_LOGIC_VECTOR) RETURN STD_LOGIC_VECTOR IS --pragma hls_map_to_operator mux
     ALIAS    inputs0: STD_LOGIC_VECTOR( inputs'length-1 DOWNTO 0) IS inputs;
     ALIAS    sel0   : STD_LOGIC_VECTOR( sel'length-1 DOWNTO 0 ) IS sel;

     VARIABLE sellen : INTEGER RANGE 2-sel'length TO sel'length;
     CONSTANT size   : POSITIVE := inputs'length / 2;
     CONSTANT olen   : POSITIVE := inputs'length / 2**sel'length;
     VARIABLE result : STD_LOGIC_VECTOR(olen-1 DOWNTO 0):= (others=>'0');
     TYPE inputs_array_type is array(natural range <>) of std_logic_vector( olen - 1 DOWNTO 0);
     VARIABLE inputs_array : inputs_array_type( 2**sel'length - 1 DOWNTO 0);
   BEGIN
     sellen := sel'length;
--pragma translate_off
     ASSERT inputs'length = olen * 2**sellen SEVERITY FAILURE;
     sellen := 2-sellen;
--pragma translate_on
     CASE sellen IS
     WHEN 1 =>
       CASE sel0(0) IS

       WHEN '1' | 'H' =>
         result := inputs0(  size-1 DOWNTO 0);
       WHEN '0' | 'L' =>
         result := inputs0(2*size-1 DOWNTO size);
       WHEN others =>
--pragma translate_off
         result := resolve_std_logic_vector(inputs0( size-1 DOWNTO 0), inputs0( 2*size-1 DOWNTO size));
--pragma translate_on
       END CASE;
     WHEN 2 =>
       result := mux_sel2_v(inputs, sel);
     WHEN 3 =>
       result := mux_sel3_v(inputs, sel);
     WHEN 4 =>
       result := mux_sel4_v(inputs, sel);
     WHEN 5 =>
       result := mux_sel5_v(inputs, sel);
     WHEN 6 =>
       result := mux_sel6_v(inputs, sel);
     WHEN others =>
-- pragma translate_off
       IF(Is_X(sel0)) THEN
         result := (others => '0');
       ELSE
-- pragma translate_on
         FOR i in 0 to 2**sel'length - 1 LOOP
           inputs_array(i) := inputs0( ((i + 1) * olen) - 1  DOWNTO i*olen);
         END LOOP;
         result := inputs_array(CONV_INTEGER( (UNSIGNED(NOT sel0)) ));
-- pragma translate_off
       END IF;
-- pragma translate_on
     END CASE;
     RETURN result;
   END;

-----------------------------------------------------------------
-- 1-hot Multipexors
-----------------------------------------------------------------

   FUNCTION mux1hot_sel4_v(inputs: STD_LOGIC_VECTOR; sel: STD_LOGIC_VECTOR(3 DOWNTO 0))
   RETURN STD_LOGIC_VECTOR IS
     CONSTANT size   : POSITIVE := inputs'length / 4;
     ALIAS    inputs0: STD_LOGIC_VECTOR(inputs'length-1 DOWNTO 0) IS inputs;
     VARIABLE result : STD_LOGIC_Vector(size-1 DOWNTO 0) := (others=>'0');
   BEGIN
     -- synthesis only
     -- simulation inconsistent with input values 'UXZHLWD'
     CASE sel IS
     WHEN "1000" =>
       result := inputs0(1*size-1 DOWNTO 0*size);
     WHEN "0100" =>
       result := inputs0(2*size-1 DOWNTO 1*size);
     WHEN "0010" =>
       result := inputs0(3*size-1 DOWNTO 2*size);
     WHEN "0001" =>
       result := inputs0(4*size-1 DOWNTO 3*size);
     WHEN others =>
       result := (others => '0');
     END CASE;
     RETURN result;
   END;

   FUNCTION mux1hot_sel16_v(inputs: STD_LOGIC_VECTOR; sel: STD_LOGIC_VECTOR(15 DOWNTO 0))
   RETURN STD_LOGIC_VECTOR IS
     CONSTANT size   : POSITIVE := inputs'length / 16;
     ALIAS    inputs0: STD_LOGIC_VECTOR(inputs'length-1 DOWNTO 0) IS inputs;
     VARIABLE result : STD_LOGIC_Vector(size-1 DOWNTO 0);
   BEGIN
     -- synthesis only
     -- simulation inconsistent with input values 'UXZHLWD'
     CASE sel IS
     WHEN "1000000000000000" =>
       result := inputs0(1*size-1 DOWNTO 0*size);
     WHEN "0100000000000000" =>
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
       result := inputs0(240*size-1 DOWNTO 239*size);
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
