soheil647/High_Level_Synthesis/Catapult_Introduction/Catapult_1/Adding.v12/cycle_mgc_ioport.vhd

--------------------------------------------------------------------
--                M G C _ I O P O R T _ C O M P S
--------------------------------------------------------------------

LIBRARY ieee;
USE ieee.std_logic_1164.all;
USE ieee.std_logic_unsigned.all;

PACKAGE mgc_ioport_comps IS

-- INPUT COMPONENTS

COMPONENT mgc_in_wire
  GENERIC (
    rscid    : INTEGER;
    width    : INTEGER
  );
  PORT (
    d        : OUT std_logic_vector(width-1 DOWNTO 0);
    z        : IN  std_logic_vector(width-1 DOWNTO 0)
  );
END COMPONENT;

COMPONENT mgc_in_wire_en
  GENERIC (
    rscid    : INTEGER;
    width    : INTEGER
  );
  PORT (
    ld       : IN  std_logic;
    d        : OUT std_logic_vector(width-1 DOWNTO 0);
    lz       : OUT std_logic;
    z        : IN  std_logic_vector(width-1 DOWNTO 0)
  );
END COMPONENT;

COMPONENT mgc_in_wire_wait
  GENERIC (
    rscid    : INTEGER;
    width    : INTEGER
  );
  PORT (
    ld       : IN  std_logic;
    vd       : OUT std_logic;
    d        : OUT std_logic_vector(width-1 DOWNTO 0);
    lz       : OUT std_logic;
    vz       : IN  std_logic;
    z        : IN  std_logic_vector(width-1 DOWNTO 0)
   );
END COMPONENT;

COMPONENT mgc_chan_in
  GENERIC (
    rscid    : INTEGER;
    width    : INTEGER;
    sz_width : INTEGER
  );
  PORT (
    ld       : IN  std_logic;
    vd       : OUT std_logic;
    d        : OUT std_logic_vector(width-1 DOWNTO 0);
    lz       : OUT std_logic;
    vz       : IN  std_logic;
    z        : IN  std_logic_vector(width-1 DOWNTO 0);
    size     : OUT std_logic_vector(sz_width-1 DOWNTO 0);
    req_size : IN  std_logic;
    sizez    : IN std_logic_vector(sz_width-1 DOWNTO 0);
    sizelz   : OUT std_logic
   );
END COMPONENT;

COMPONENT mgc_in_wire_wait_nb
  GENERIC (
    rscid    : INTEGER;
    width    : INTEGER;
    sz_width : INTEGER
  );
  PORT (
    ld       : IN  std_logic;
    vd       : OUT std_logic;
    d        : OUT std_logic_vector(width-1 DOWNTO 0);
    lz       : OUT std_logic;
    vz       : IN  std_logic;
    z        : IN  std_logic_vector(width-1 DOWNTO 0);
    size     : OUT   std_logic_vector(sz_width-1 DOWNTO 0);
    req_size : in    std_logic
  );
END COMPONENT;

-- OUTPUT COMPONENTS

COMPONENT mgc_out_stdreg
  GENERIC (
    rscid    : INTEGER;
    width    : INTEGER
  );
  PORT (
    d        : IN  std_logic_vector(width-1 DOWNTO 0);
    z        : OUT std_logic_vector(width-1 DOWNTO 0)
  );
END COMPONENT;

COMPONENT mgc_out_stdreg_en
  GENERIC (
    rscid    : INTEGER;
    width    : INTEGER
  );
  PORT (
    ld       : IN  std_logic;
    d        : IN  std_logic_vector(width-1 DOWNTO 0);
    lz       : OUT std_logic;
    z        : OUT std_logic_vector(width-1 DOWNTO 0)
  );
END COMPONENT;


COMPONENT mgc_out_stdreg_wait
  GENERIC (
    rscid    : INTEGER;
    width    : INTEGER
  );
  PORT (
    ld       : IN  std_logic;
    vd       : OUT std_logic;
    d        : IN  std_logic_vector(width-1 DOWNTO 0);
    lz       : OUT std_logic;
    vz       : IN  std_logic;
    z        : OUT std_logic_vector(width-1 DOWNTO 0)
  );
END COMPONENT;

COMPONENT mgc_out_reg_pos
  GENERIC (
    rscid    : INTEGER;
    width    : INTEGER;
    ph_en    : INTEGER RANGE 0 TO 1;
    ph_arst  : INTEGER RANGE 0 TO 1;
    ph_srst  : INTEGER RANGE 0 TO 1
  );
  PORT (
    clk      : IN  std_logic;
    en       : IN  std_logic;
    arst     : IN  std_logic;
    srst     : IN  std_logic;
    ld       : IN  std_logic;
    d        : IN  std_logic_vector(width-1 DOWNTO 0);
    lz       : OUT std_logic;
    z        : OUT std_logic_vector(width-1 DOWNTO 0)
  );
END COMPONENT;

COMPONENT mgc_out_reg_neg
  GENERIC (
    rscid    : INTEGER;
    width    : INTEGER;
    ph_en    : INTEGER RANGE 0 TO 1;
    ph_arst  : INTEGER RANGE 0 TO 1;
    ph_srst  : INTEGER RANGE 0 TO 1
  );
  PORT (
    clk      : IN  std_logic;
    en       : IN  std_logic;
    arst     : IN  std_logic;
    srst     : IN  std_logic;
    ld       : IN  std_logic;
    d        : IN  std_logic_vector(width-1 DOWNTO 0);
    lz       : OUT std_logic;
    z        : OUT std_logic_vector(width-1 DOWNTO 0)
  );
END COMPONENT;

COMPONENT mgc_out_reg
  GENERIC (
    rscid    : INTEGER;
    width    : INTEGER;
    ph_clk   : INTEGER RANGE 0 TO 1;
    ph_en    : INTEGER RANGE 0 TO 1;
    ph_arst  : INTEGER RANGE 0 TO 1;
    ph_srst  : INTEGER RANGE 0 TO 1
  );
  PORT (
    clk      : IN  std_logic;
    en       : IN  std_logic;
    arst     : IN  std_logic;
    srst     : IN  std_logic;
    ld       : IN  std_logic;
    d        : IN  std_logic_vector(width-1 DOWNTO 0);
    lz       : OUT std_logic;
    z        : OUT std_logic_vector(width-1 DOWNTO 0)
  );
END COMPONENT;

COMPONENT mgc_out_buf_wait
  GENERIC (
    rscid    : INTEGER;
    width    : INTEGER;
    ph_clk   : INTEGER RANGE 0 TO 1;
    ph_en    : INTEGER RANGE 0 TO 1;
    ph_arst  : INTEGER RANGE 0 TO 1;
    ph_srst  : INTEGER RANGE 0 TO 1
  );
  PORT (
    clk      : IN  std_logic;
    en       : IN  std_logic;
    arst     : IN  std_logic;
    srst     : IN  std_logic;
    ld       : IN  std_logic;
    vd       : OUT std_logic;
    d        : IN  std_logic_vector(width-1 DOWNTO 0);
    lz       : OUT std_logic;
    vz       : IN  std_logic;
    z        : OUT std_logic_vector(width-1 DOWNTO 0)
  );
END COMPONENT;

COMPONENT mgc_out_fifo_wait
  GENERIC (
    rscid    : INTEGER;
    width    : INTEGER;
    fifo_sz  : INTEGER;
    ph_clk   : INTEGER RANGE 0 TO 1;
    ph_en    : INTEGER RANGE 0 TO 1;
    ph_arst  : INTEGER RANGE 0 TO 1;
    ph_srst  : INTEGER RANGE 0 TO 1;
    ph_log2  : INTEGER;
    pwropt   : INTEGER RANGE 0 TO 2 := 0
  );
  PORT (
    clk      : IN  std_logic;
    en       : IN  std_logic;
    arst     : IN  std_logic;
    srst     : IN  std_logic;
    ld       : IN  std_logic;
    vd       : OUT std_logic;
    d        : IN  std_logic_vector(width-1 DOWNTO 0);
    lz       : OUT std_logic;
    vz       : IN  std_logic;
    z        : OUT std_logic_vector(width-1 DOWNTO 0)
  );
END COMPONENT;

-- implementation for mgc_out_fifo_wait
COMPONENT mgc_out_fifo_wait_core
  GENERIC (
    rscid    : INTEGER;
    width    : INTEGER;
    sz_width : INTEGER;
    fifo_sz  : INTEGER;
    ph_clk   : INTEGER RANGE 0 TO 1;
    ph_en    : INTEGER RANGE 0 TO 1;
    ph_arst  : INTEGER RANGE 0 TO 1;
    ph_srst  : INTEGER RANGE 0 TO 1;
    ph_log2  : INTEGER;
    pwropt   : INTEGER RANGE 0 TO 2 := 0
  );
  PORT (
    clk      : IN  std_logic;
    en       : IN  std_logic;
    arst     : IN  std_logic;
    srst     : IN  std_logic;
    ld       : IN  std_logic;
    vd       : OUT std_logic;
    d        : IN  std_logic_vector(width-1 DOWNTO 0);
    lz       : OUT std_logic;
    vz       : IN  std_logic;
    z        : OUT std_logic_vector(width-1 DOWNTO 0);
    size     : OUT std_logic_vector(sz_width-1 DOWNTO 0)
  );
END COMPONENT;

COMPONENT mgc_out_prereg_en
  GENERIC (
    rscid    : INTEGER;
    width    : INTEGER
  );
  PORT (
    ld       : IN  std_logic;
    d        : IN  std_logic_vector(width-1 DOWNTO 0);
    lz       : OUT std_logic;
    z        : OUT std_logic_vector(width-1 DOWNTO 0)
  );
END COMPONENT;

-- INOUT COMPONENTS

COMPONENT mgc_inout_stdreg_en
  GENERIC (
    rscid    : INTEGER;
    width    : INTEGER
  );
  PORT (
    ldin     : IN    std_logic;
    din      : OUT   std_logic_vector(width-1 DOWNTO 0);
    ldout    : IN    std_logic;
    dout     : IN    std_logic_vector(width-1 DOWNTO 0);
    lzin     : OUT   std_logic;
    lzout    : OUT   std_logic;
    z        : INOUT std_logic_vector(width-1 DOWNTO 0)
  );
END COMPONENT;

COMPONENT mgc_inout_stdreg_wait
  GENERIC (
    rscid    : INTEGER;
    width    : INTEGER
  );
  PORT (
    ldin     : IN    std_logic;
    vdin     : OUT   std_logic;
    din      : OUT   std_logic_vector(width-1 DOWNTO 0);
    ldout    : IN    std_logic;
    vdout    : OUT   std_logic;
    dout     : IN    std_logic_vector(width-1 DOWNTO 0);
    lzin     : OUT   std_logic;
    vzin     : IN    std_logic;
    lzout    : OUT   std_logic;
    vzout    : IN    std_logic;
    z        : INOUT std_logic_vector(width-1 DOWNTO 0)
  );
END COMPONENT;

COMPONENT mgc_hid_tribuf
  GENERIC (
    width    : INTEGER
  );
  PORT (
    I_SIG    : IN     std_logic_vector(width-1 DOWNTO 0);
    ENABLE   : IN     boolean ;
    O_SIG    : OUT    std_logic_vector(width-1 DOWNTO 0)
  );
END COMPONENT;

COMPONENT mgc_inout_buf_wait
  GENERIC (
    rscid    : INTEGER;
    width    : INTEGER;
    ph_clk   : INTEGER RANGE 0 TO 1;
    ph_en    : INTEGER RANGE 0 TO 1;
    ph_arst  : INTEGER RANGE 0 TO 1;
    ph_srst  : INTEGER RANGE 0 TO 1
  );
  PORT (
    clk      : IN    std_logic;
    en       : IN    std_logic;
    arst     : IN    std_logic;
    srst     : IN    std_logic;
    ldin     : IN    std_logic;
    vdin     : OUT   std_logic;
    din      : OUT   std_logic_vector(width-1 DOWNTO 0);
    ldout    : IN    std_logic;
    vdout    : OUT   std_logic;
    dout     : IN    std_logic_vector(width-1 DOWNTO 0);
    lzin     : OUT   std_logic;
    vzin     : IN    std_logic;
    lzout    : OUT   std_logic;
    vzout    : IN    std_logic;
    z        : INOUT std_logic_vector(width-1 DOWNTO 0)
  );
END COMPONENT;

COMPONENT mgc_inout_fifo_wait
  GENERIC (
    rscid    : INTEGER;
    width    : INTEGER;
    fifo_sz  : INTEGER;
    ph_clk   : INTEGER RANGE 0 TO 1;
    ph_en    : INTEGER RANGE 0 TO 1;
    ph_arst  : INTEGER RANGE 0 TO 1;
    ph_srst  : INTEGER RANGE 0 TO 1;
    ph_log2  : INTEGER;
    pwropt   : INTEGER RANGE 0 TO 2 := 0
  );
  PORT (
    clk      : IN    std_logic;
    en       : IN    std_logic;
    arst     : IN    std_logic;
    srst     : IN    std_logic;
    ldin     : IN    std_logic;
    vdin     : OUT   std_logic;
    din      : OUT   std_logic_vector(width-1 DOWNTO 0);
    ldout    : IN    std_logic;
    vdout    : OUT   std_logic;
    dout     : IN    std_logic_vector(width-1 DOWNTO 0);
    lzin     : OUT   std_logic;
    vzin     : IN    std_logic;
    lzout    : OUT   std_logic;
    vzout    : IN    std_logic;
    z        : INOUT std_logic_vector(width-1 DOWNTO 0)
  );
END COMPONENT;

-- IO SYNCHRONIZATION

COMPONENT mgc_io_sync
  PORT (
    ld       : IN    std_logic;
    lz       : OUT   std_logic
  );
END COMPONENT;

COMPONENT mgc_bsync_rdy
  GENERIC (
    rscid    : INTEGER;
    ready    : INTEGER RANGE 0 TO 1;
    valid    : INTEGER RANGE 0 TO 1
  );
  PORT (
    rd       : IN    std_logic;
    rz       : OUT   std_logic
  );
END COMPONENT;

COMPONENT mgc_bsync_vld
  GENERIC (
    rscid    : INTEGER;
    ready    : INTEGER RANGE 0 TO 1;
    valid    : INTEGER RANGE 0 TO 1
  );
  PORT (
    vd       : OUT   std_logic;
    vz       : IN    std_logic
  );
END COMPONENT;

COMPONENT mgc_bsync_rv
  GENERIC (
    rscid    : INTEGER;
    ready    : INTEGER RANGE 0 TO 1;
    valid    : INTEGER RANGE 0 TO 1
  );
  PORT (
    rd       : IN    std_logic;
    vd       : OUT   std_logic;
    rz       : OUT   std_logic;
    vz       : IN    std_logic
  );
END COMPONENT;

-- PIPE

COMPONENT mgc_pipe
  GENERIC (
    rscid    : INTEGER;
    width    : INTEGER;
    sz_width : INTEGER;
    fifo_sz  : INTEGER;
    log2_sz  : INTEGER;
    ph_clk   : INTEGER RANGE 0 TO 1;
    ph_en    : INTEGER RANGE 0 TO 1;
    ph_arst  : INTEGER RANGE 0 TO 1;
    ph_srst  : INTEGER RANGE 0 TO 1;
    pwropt   : INTEGER RANGE 0 TO 2 := 0
  );
  PORT (
    clk      : IN    std_logic;
    en       : IN    std_logic;
    arst     : IN    std_logic;
    srst     : IN    std_logic;
    ldin     : IN    std_logic;
    vdin     : OUT   std_logic;
    din      : OUT   std_logic_vector(width-1 DOWNTO 0);
    ldout    : IN    std_logic;
    vdout    : OUT   std_logic;
    dout     : IN    std_logic_vector(width-1 DOWNTO 0);
    size     : OUT   std_logic_vector(sz_width-1 DOWNTO 0);
    req_size : in    std_logic
  );
END COMPONENT;

COMPONENT mgc_sync
  PORT (
    ldin     : IN    std_logic;
    vdin     : OUT   std_logic;
    ldout    : IN    std_logic;
    vdout    : OUT   std_logic
  );
END COMPONENT;

-- The start of the asynch CDC components
COMPONENT mgc_regfile_pos
generic
(
  data_width   : integer;
  addr_width   : integer;
  num_of_words : integer;
  ph_en        : integer RANGE 0 to 1;
  ph_arst      : integer RANGE 0 to 1;
  ph_srst      : integer RANGE 0 to 1
);
port
(
  clk           : IN  std_logic;
  arst          : IN  std_logic;
  srst          : IN  std_logic;
  en            : IN  std_logic;
  write_en      : IN  std_logic;
  write_address : IN  std_logic_vector (addr_width - 1 downto 0);
  write_data    : IN  std_logic_vector (data_width - 1 downto 0);
  read_address  : IN  std_logic_vector (addr_width - 1 downto 0);
  read_data     : OUT std_logic_vector (data_width - 1 downto 0)
);
END COMPONENT;

COMPONENT mgc_regfile_neg
generic
(
  data_width   : integer;
  addr_width   : integer;
  num_of_words : integer;
  ph_en        : integer RANGE 0 to 1;
  ph_arst      : integer RANGE 0 to 1;
  ph_srst      : integer RANGE 0 to 1
);
port
(
  clk           : IN  std_logic;
  arst          : IN  std_logic;
  srst          : IN  std_logic;
  en            : IN  std_logic;
  write_en      : IN  std_logic;
  write_address : IN  std_logic_vector (addr_width - 1 downto 0);
  write_data    : IN  std_logic_vector (data_width - 1 downto 0);
  read_address  : IN  std_logic_vector (addr_width - 1 downto 0);
  read_data     : OUT std_logic_vector (data_width - 1 downto 0)
);
END COMPONENT;

COMPONENT mgc_regfile
generic
(
  data_width   : integer;
  addr_width   : integer;
  num_of_words : integer;
  ph_clk       : integer RANGE 0 TO 1;
  ph_en        : integer RANGE 0 to 1;
  ph_arst      : integer RANGE 0 to 1;
  ph_srst      : integer RANGE 0 to 1
);
port
(
  clk           : IN  std_logic;
  arst          : IN  std_logic;
  srst          : IN  std_logic;
  en            : IN  std_logic;
  write_en      : IN  std_logic;
  write_address : IN  std_logic_vector (addr_width - 1 downto 0);
  write_data    : IN  std_logic_vector (data_width - 1 downto 0);
  read_address  : IN  std_logic_vector (addr_width - 1 downto 0);
  read_data     : OUT std_logic_vector (data_width - 1 downto 0)
);
END COMPONENT;

COMPONENT mgc_in_ram
generic
(
  ram_id            : integer;
  words             : integer;
  width             : integer;
  addr_width        : integer;
  re_active         : integer;
  num_byte_enables  : integer;
  no_of_ports       : integer
);
port
(
 d  : out  STD_LOGIC_VECTOR((no_of_ports * width) - 1 downto 0);
 ad : in  STD_LOGIC_VECTOR((no_of_ports * addr_width) - 1 downto 0) ;
 bd : in  STD_LOGIC_VECTOR((no_of_ports * num_byte_enables) - 1 downto 0) ;
 z  : in  STD_LOGIC_VECTOR((no_of_ports * width) - 1 downto 0);
 az : out  STD_LOGIC_VECTOR((no_of_ports * addr_width) - 1 downto 0) ;
 bz : out  STD_LOGIC_VECTOR((no_of_ports * num_byte_enables) - 1 downto 0)
);
END COMPONENT;

COMPONENT mgc_out_ram
generic
(
  ram_id            : integer;
  words             : integer;
  width             : integer;
  addr_width        : integer;
  re_active         : integer;
  num_byte_enables  : integer;
  no_of_ports       : integer
);
port
(
 d  : in  STD_LOGIC_VECTOR((no_of_ports * width) - 1 downto 0);
 ad : in  STD_LOGIC_VECTOR((no_of_ports * addr_width) - 1 downto 0) ;
 bd : in  STD_LOGIC_VECTOR((no_of_ports * num_byte_enables) - 1 downto 0) ;
 z  : out  STD_LOGIC_VECTOR((no_of_ports * width) - 1 downto 0);
 az : out  STD_LOGIC_VECTOR((no_of_ports * addr_width) - 1 downto 0) ;
 bz : out  STD_LOGIC_VECTOR((no_of_ports * num_byte_enables) - 1 downto 0)
);
END COMPONENT;

COMPONENT mgc_inout_ram
generic
(
  ram_id            : integer;
  words             : integer;
  width             : integer;
  addr_width        : integer;
  re_active         : integer;
  we_active         : integer;
  num_byte_enables  : integer;
  no_of_ports       : integer
);
port
(
 id  : out  STD_LOGIC_VECTOR((no_of_ports * width) - 1 downto 0);
 od  : in  STD_LOGIC_VECTOR((no_of_ports * width) - 1 downto 0);
 ad  : in  STD_LOGIC_VECTOR((no_of_ports * addr_width) - 1 downto 0) ;
 rd  : in  STD_LOGIC_VECTOR((no_of_ports * num_byte_enables) - 1 downto 0) ;
 wd  : in  STD_LOGIC_VECTOR((no_of_ports * num_byte_enables) - 1 downto 0) ;
 iz  : in  STD_LOGIC_VECTOR((no_of_ports * width) - 1 downto 0);
 oz  : out  STD_LOGIC_VECTOR((no_of_ports * width) - 1 downto 0);
 az  : out  STD_LOGIC_VECTOR((no_of_ports * addr_width) - 1 downto 0) ;
 rz  : out  STD_LOGIC_VECTOR((no_of_ports * num_byte_enables) - 1 downto 0);
 wz  : out  STD_LOGIC_VECTOR((no_of_ports * num_byte_enables) - 1 downto 0)
);
END COMPONENT;


COMPONENT funccall_inout
generic
(
  ram_id           : integer;
  width           : integer;  -- models the concat of the return value (data)
  addr_width      : integer  -- models the concat of the input arguments (addr)
);
port
(
  d  : out  STD_LOGIC_VECTOR(width - 1 downto 0);
  ad : in  STD_LOGIC_VECTOR(addr_width - 1 downto 0) ;
  bd : in  STD_LOGIC;
  z  : in  STD_LOGIC_VECTOR(width - 1 downto 0);
  az : out  STD_LOGIC_VECTOR(addr_width - 1 downto 0) ;
  bz : out  STD_LOGIC
);
END COMPONENT;

COMPONENT modulario_en_in
  GENERIC (
    rscid    : INTEGER;
    width    : INTEGER
  );
  PORT (
    vd       : OUT std_logic;
    d        : OUT std_logic_vector(width-1 DOWNTO 0);
    vz       : IN  std_logic;
    z        : IN  std_logic_vector(width-1 DOWNTO 0)
   );
END COMPONENT;


END mgc_ioport_comps;


--------------------------------------------------------------------
--                        E N T I T I E S
--------------------------------------------------------------------

-----------------
-- INPUT ENTITIES
-----------------

LIBRARY ieee;
USE ieee.std_logic_1164.all;
USE ieee.std_logic_unsigned.all;

LIBRARY mgc_hls;
USE mgc_hls.mgc_ioport_comps.all;

ENTITY mgc_in_wire IS
  GENERIC (
    rscid    : INTEGER;
    width    : INTEGER
  );
  PORT (
    d        : OUT std_logic_vector(width-1 DOWNTO 0);
    z        : IN  std_logic_vector(width-1 DOWNTO 0)
  );
END mgc_in_wire;

ARCHITECTURE beh OF mgc_in_wire IS
BEGIN

  d <= z;

END beh;


LIBRARY ieee;
USE ieee.std_logic_1164.all;
USE ieee.std_logic_unsigned.all;

LIBRARY mgc_hls;
USE mgc_hls.mgc_ioport_comps.all;

ENTITY mgc_in_wire_en IS
  GENERIC (
    rscid    : INTEGER;
    width    : INTEGER
  );
  PORT (
    ld       : IN  std_logic;
    d        : OUT std_logic_vector(width-1 DOWNTO 0);
    lz       : OUT std_logic;
    z        : IN  std_logic_vector(width-1 DOWNTO 0)
  );
END mgc_in_wire_en;

ARCHITECTURE beh OF mgc_in_wire_en IS
BEGIN

  lz <= ld;
  d  <= z;

END beh;


LIBRARY ieee;
USE ieee.std_logic_1164.all;
USE ieee.std_logic_unsigned.all;

LIBRARY mgc_hls;
USE mgc_hls.mgc_ioport_comps.all;

ENTITY mgc_in_wire_wait IS
  GENERIC (
    rscid    : INTEGER;
    width    : INTEGER
  );
  PORT (
    ld       : IN  std_logic;
    vd       : OUT std_logic;
    d        : OUT std_logic_vector(width-1 DOWNTO 0);
    lz       : OUT std_logic;
    vz       : IN  std_logic;
    z        : IN  std_logic_vector(width-1 DOWNTO 0)
  );
END mgc_in_wire_wait;

ARCHITECTURE beh OF mgc_in_wire_wait IS
BEGIN

  lz <= ld;
  vd <= vz;
  d  <= z;

END beh;


LIBRARY ieee;
USE ieee.std_logic_1164.all;
USE ieee.std_logic_unsigned.all;

LIBRARY mgc_hls;
USE mgc_hls.mgc_ioport_comps.all;

ENTITY mgc_chan_in IS
  GENERIC (
    rscid    : INTEGER;
    width    : INTEGER;
    sz_width : INTEGER
  );
  PORT (
    ld       : IN  std_logic;
    vd       : OUT std_logic;
    d        : OUT std_logic_vector(width-1 DOWNTO 0);
    lz       : OUT std_logic;
    vz       : IN  std_logic;
    z        : IN  std_logic_vector(width-1 DOWNTO 0);
    size     : OUT std_logic_vector(sz_width-1 DOWNTO 0);
    req_size : IN  std_logic;
    sizez    : IN std_logic_vector(sz_width-1 DOWNTO 0);
    sizelz   : OUT std_logic
  );
END mgc_chan_in;

ARCHITECTURE beh OF mgc_chan_in IS
BEGIN

  lz <= ld;
  vd <= vz;
  d  <= z;
  size <= sizez;
  sizelz <= req_size;

END beh;


------------------
-- OUTPUT ENTITIES
------------------

LIBRARY ieee;
USE ieee.std_logic_1164.all;
USE ieee.std_logic_unsigned.all;

LIBRARY mgc_hls;
USE mgc_hls.mgc_ioport_comps.all;

ENTITY mgc_out_stdreg IS
  GENERIC (
    rscid    : INTEGER;
    width    : INTEGER
  );
  PORT (
    d        : IN  std_logic_vector(width-1 DOWNTO 0);
    z        : OUT std_logic_vector(width-1 DOWNTO 0)
  );
END mgc_out_stdreg;

ARCHITECTURE beh OF mgc_out_stdreg IS
BEGIN

  z <= d;

End beh;


LIBRARY ieee;
USE ieee.std_logic_1164.all;
USE ieee.std_logic_unsigned.all;

LIBRARY mgc_hls;
USE mgc_hls.mgc_ioport_comps.all;

ENTITY mgc_out_stdreg_en IS
  GENERIC (
    rscid    : INTEGER;
    width    : INTEGER
  );
  PORT (
    ld       : IN  std_logic;
    d        : IN  std_logic_vector(width-1 DOWNTO 0);
    lz       : OUT std_logic;
    z        : OUT std_logic_vector(width-1 DOWNTO 0)
  );
END mgc_out_stdreg_en;

ARCHITECTURE beh OF mgc_out_stdreg_en IS
BEGIN

  lz <= ld;
  z  <= d;

END beh;


LIBRARY ieee;
USE ieee.std_logic_1164.all;
USE ieee.std_logic_unsigned.all;

LIBRARY mgc_hls;
USE mgc_hls.mgc_ioport_comps.all;

ENTITY mgc_out_stdreg_wait IS
  GENERIC (
    rscid    : INTEGER;
    width    : INTEGER
  );
  PORT (
    ld       : IN  std_logic;
    vd       : OUT std_logic;
    d        : IN  std_logic_vector(width-1 DOWNTO 0);
    lz       : OUT std_logic;
    vz       : IN  std_logic;
    z        : OUT std_logic_vector(width-1 DOWNTO 0)
  );
END mgc_out_stdreg_wait;

ARCHITECTURE beh OF mgc_out_stdreg_wait IS
BEGIN

  lz   <= ld;
  vd   <= vz;
  z    <= d;

END beh;


LIBRARY ieee;
USE ieee.std_logic_1164.all;
USE ieee.std_logic_arith.all;
USE ieee.std_logic_unsigned.all;

LIBRARY mgc_hls;
USE mgc_hls.mgc_ioport_comps.all;

ENTITY mgc_out_reg_pos IS
  GENERIC (
    rscid    : INTEGER;
    width    : INTEGER;
    ph_en    : INTEGER RANGE 0 TO 1;
    ph_arst  : INTEGER RANGE 0 TO 1;
    ph_srst  : INTEGER RANGE 0 TO 1
  );
  PORT (
    clk      : IN  std_logic;
    en       : IN  std_logic;
    arst     : IN  std_logic;
    srst     : IN  std_logic;
    ld       : IN  std_logic;
    d        : IN  std_logic_vector(width-1 DOWNTO 0);
    lz       : OUT std_logic;
    z        : OUT std_logic_vector(width-1 DOWNTO 0)
  );
END mgc_out_reg_pos;

ARCHITECTURE beh OF mgc_out_reg_pos IS
BEGIN

  PROCESS ( clk, arst )
  BEGIN
    IF conv_integer(arst) = ph_arst THEN
      lz <= '0';
    ELSIF clk'EVENT AND clk = '1' THEN
      IF conv_integer(srst) = ph_srst THEN
        lz <= '0';
      ELSIF conv_integer(en) = ph_en THEN
        lz <= ld;
      END IF;
    END IF;
  END PROCESS;

  PROCESS ( clk, arst )
  BEGIN
    IF conv_integer(arst) = ph_arst THEN
      z  <= (others => '0');
    ELSIF clk'EVENT AND clk = '1' THEN
      IF conv_integer(srst) = ph_srst THEN
        z  <= (others => '0');
      ELSIF (conv_integer(en) = ph_en) AND (conv_integer(ld) = 1) THEN
        z <= d;
      END IF;
    END IF;
  END PROCESS;

END beh;


LIBRARY ieee;
USE ieee.std_logic_1164.all;
USE ieee.std_logic_arith.all;
USE ieee.std_logic_unsigned.all;

LIBRARY mgc_hls;
USE mgc_hls.mgc_ioport_comps.all;

ENTITY mgc_out_reg_neg IS
  GENERIC (
    rscid    : INTEGER;
    width    : INTEGER;
    ph_en    : INTEGER RANGE 0 TO 1;
    ph_arst  : INTEGER RANGE 0 TO 1;
    ph_srst  : INTEGER RANGE 0 TO 1
  );
  PORT (
    clk      : IN  std_logic;
    en       : IN  std_logic;
    arst     : IN  std_logic;
    srst     : IN  std_logic;
    ld       : IN  std_logic;
    d        : IN  std_logic_vector(width-1 DOWNTO 0);
    lz       : OUT std_logic;
    z        : OUT std_logic_vector(width-1 DOWNTO 0)
  );
END mgc_out_reg_neg;

ARCHITECTURE beh OF mgc_out_reg_neg IS
BEGIN

  PROCESS ( clk, arst )
  BEGIN
    IF conv_integer(arst) = ph_arst THEN
      lz <= '0';
    ELSIF clk'EVENT AND clk = '0' THEN
      IF conv_integer(srst) = ph_srst THEN
        lz <= '0';
      ELSIF conv_integer(en) = ph_en THEN
        lz <= ld;
      END IF;
    END IF;
  END PROCESS;

  PROCESS ( clk, arst )
  BEGIN
    IF conv_integer(arst) = ph_arst THEN
      z  <= (others => '0');
    ELSIF clk'EVENT AND clk = '0' THEN
      IF conv_integer(srst) = ph_srst THEN
        z  <= (others => '0');
      ELSIF (conv_integer(en) = ph_en) AND (conv_integer(ld) = 1) THEN
        z <= d;
      END IF;
    END IF;
  END PROCESS;

END beh;


LIBRARY ieee;
USE ieee.std_logic_1164.all;
USE ieee.std_logic_unsigned.all;

LIBRARY mgc_hls;
USE mgc_hls.mgc_ioport_comps.all;

ENTITY mgc_out_reg IS
  GENERIC (
    rscid    : INTEGER;
    width    : INTEGER;
    ph_clk   : INTEGER RANGE 0 TO 1;
    ph_en    : INTEGER RANGE 0 TO 1;
    ph_arst  : INTEGER RANGE 0 TO 1;
    ph_srst  : INTEGER RANGE 0 TO 1
  );
  PORT (
    clk      : IN  std_logic;
    en       : IN  std_logic;
    arst     : IN  std_logic;
    srst     : IN  std_logic;
    ld       : IN  std_logic;
    d        : IN  std_logic_vector(width-1 DOWNTO 0);
    lz       : OUT std_logic;
    z        : OUT std_logic_vector(width-1 DOWNTO 0)
  );
END mgc_out_reg;

ARCHITECTURE beh OF mgc_out_reg IS
BEGIN

  GENPOS: IF ph_clk = 1 GENERATE
    REGPOS: mgc_out_reg_pos
      generic map (
        rscid => rscid,
        width => width,
        ph_en => ph_en,
        ph_arst => ph_arst,
        ph_srst => ph_srst
      )
      port map (
        clk    => clk,
        en     => en,
        arst   => arst,
        srst   => srst,
        ld     => ld,
        d      => d,
        lz     => lz,
        z      => z
      );
  END GENERATE;

  GENNEG: IF ph_clk = 0 GENERATE
    REGNEG: mgc_out_reg_neg
      generic map (
        rscid => rscid,
        width => width,
        ph_en => ph_en,
        ph_arst => ph_arst,
        ph_srst => ph_srst
      )
      port map (
        clk    => clk,
        en     => en,
        arst   => arst,
        srst   => srst,
        ld     => ld,
        d      => d,
        lz     => lz,
        z      => z
      );
  END GENERATE;

END beh;


LIBRARY ieee;
USE ieee.std_logic_1164.all;
USE ieee.std_logic_arith.all;
USE ieee.std_logic_unsigned.all;

LIBRARY mgc_hls;
USE mgc_hls.mgc_ioport_comps.all;

ENTITY mgc_out_buf_wait IS
  GENERIC (
    rscid    : INTEGER;
    width    : INTEGER;
    ph_clk   : INTEGER RANGE 0 TO 1;
    ph_en    : INTEGER RANGE 0 TO 1;
    ph_arst  : INTEGER RANGE 0 TO 1;
    ph_srst  : INTEGER RANGE 0 TO 1
  );
  PORT (
    clk      : IN  std_logic;
    en       : IN  std_logic;
    arst     : IN  std_logic;
    srst     : IN  std_logic;
    ld       : IN  std_logic;
    vd       : OUT std_logic;
    d        : IN  std_logic_vector(width-1 DOWNTO 0);
    lz       : OUT std_logic;
    vz       : IN  std_logic;
    z        : OUT std_logic_vector(width-1 DOWNTO 0)
  );
END mgc_out_buf_wait;

ARCHITECTURE beh OF mgc_out_buf_wait IS

  SIGNAL filled     : std_logic;
  SIGNAL filled_next: std_logic;

  SIGNAL sbuf       : std_logic_vector(width-1 DOWNTO 0);
  SIGNAL lbuf       : std_logic;

  SIGNAL dum        : std_logic_vector(0 DOWNTO 0);

BEGIN

  dum <= (others => '0');
  filled_next <= (filled AND NOT vz) OR (filled AND ld) OR (ld AND NOT vz);

  lbuf <= ld AND NOT (filled XOR vz);

  vd <= vz OR NOT filled;
  lz <= ld OR filled;
  z  <= sbuf WHEN conv_integer(filled) = 1 ELSE d;

  STATEREG: mgc_out_reg
    generic map (
      rscid => rscid,
      width => 1,
      ph_clk => ph_clk,
      ph_en => ph_en,
      ph_arst => ph_arst,
      ph_srst => ph_srst
    )
    port map (
      clk    => clk,
      en     => en,
      arst   => arst,
      srst   => srst,
      ld     => filled_next,
      d      => dum,
      lz     => filled,
      z      => open
    );

  BUFREG: mgc_out_reg
    generic map (
      rscid => rscid,
      width => width,
      ph_clk => ph_clk,
      ph_en => ph_en,
      ph_arst => ph_arst,
      ph_srst => ph_srst
    )
    port map (
      clk    => clk,
      en     => en,
      arst   => arst,
      srst   => srst,
      ld     => lbuf,
      d      => d,
      lz     => open,
      z      => sbuf
    );

END beh;


LIBRARY ieee;
USE ieee.std_logic_1164.all;
USE ieee.std_logic_arith.all;
USE ieee.std_logic_unsigned.all;

LIBRARY mgc_hls;
USE mgc_hls.mgc_ioport_comps.all;

ENTITY mgc_out_fifo_wait IS
  GENERIC (
    rscid    : INTEGER;
    width    : INTEGER;
    fifo_sz  : INTEGER;
    ph_clk   : INTEGER RANGE 0 TO 1;
    ph_en    : INTEGER RANGE 0 TO 1;
    ph_arst  : INTEGER RANGE 0 TO 1;
    ph_srst  : INTEGER RANGE 0 TO 1;
    ph_log2  : INTEGER;
    pwropt   : INTEGER RANGE 0 TO 2 := 0
  );
  PORT (
    clk      : IN  std_logic;
    en       : IN  std_logic;
    arst     : IN  std_logic;
    srst     : IN  std_logic;
    ld       : IN  std_logic;
    vd       : OUT std_logic;
    d        : IN  std_logic_vector(width-1 DOWNTO 0);
    lz       : OUT std_logic;
    vz       : IN  std_logic;
    z        : OUT std_logic_vector(width-1 DOWNTO 0)
  );
END mgc_out_fifo_wait;

ARCHITECTURE beh OF mgc_out_fifo_wait IS
    SIGNAL size : std_logic_vector(31 DOWNTO 0);

BEGIN
    CORE: mgc_out_fifo_wait_core
    generic map (
        rscid    => rscid,
        width    => width,
        sz_width => 32,
        fifo_sz  => fifo_sz,
        ph_clk   => ph_clk,
        ph_en    => ph_en,
        ph_arst  => ph_arst,
        ph_srst  => ph_srst,
        ph_log2  => ph_log2,
        pwropt   => pwropt
    )
   port map (
        clk  => clk,
        en   => en,
        arst => arst,
        srst => srst,
        ld   => ld,
        vd   => vd,
        d    => d,
        lz   => lz,
        vz   => vz,
        z    => z,
        size => size
      );
END beh;



LIBRARY ieee;
USE ieee.std_logic_1164.all;
USE ieee.std_logic_arith.all;
USE ieee.std_logic_unsigned.all;

LIBRARY mgc_hls;
USE mgc_hls.mgc_ioport_comps.all;

ENTITY mgc_out_fifo_wait_core IS
  GENERIC (
    rscid    : INTEGER;
    width    : INTEGER;
    sz_width : INTEGER;
    fifo_sz  : INTEGER;
    ph_clk   : INTEGER RANGE 0 TO 1;
    ph_en    : INTEGER RANGE 0 TO 1;
    ph_arst  : INTEGER RANGE 0 TO 1;
    ph_srst  : INTEGER RANGE 0 TO 1;
    ph_log2  : INTEGER;
    pwropt   : INTEGER RANGE 0 TO 2 := 0
  );
  PORT (
    clk      : IN  std_logic;
    en       : IN  std_logic;
    arst     : IN  std_logic;
    srst     : IN  std_logic;
    ld       : IN  std_logic;
    vd       : OUT std_logic;
    d        : IN  std_logic_vector(width-1 DOWNTO 0);
    lz       : OUT std_logic;
    vz       : IN  std_logic;
    z        : OUT std_logic_vector(width-1 DOWNTO 0);
    size     : OUT std_logic_vector(sz_width-1 DOWNTO 0)
  );
END mgc_out_fifo_wait_core;

ARCHITECTURE beh OF mgc_out_fifo_wait_core IS

  FUNCTION adjust(sz : INTEGER) RETURN INTEGER IS
    VARIABLE res : INTEGER RANGE 0 TO width*fifo_sz+1;
  BEGIN
    IF sz > 0 THEN
      res := sz;
    ELSE
      res := 1;
    END IF;
    RETURN res;
  END ;

  SIGNAL stat     : std_logic_vector(adjust(fifo_sz)-1 DOWNTO 0);
  SIGNAL stat_pre : std_logic_vector(adjust(fifo_sz)-1 DOWNTO 0);

  SIGNAL sbuf     : std_logic_vector(adjust(width*fifo_sz)-1 DOWNTO 0);
  SIGNAL buf_pre  : std_logic_vector(adjust(width*fifo_sz)-1 DOWNTO 0);

  SIGNAL en_l     : std_logic_vector(adjust(fifo_sz)-1 DOWNTO 0);
  SIGNAL en_l_s   : std_logic_vector(((adjust(fifo_sz)-1)/8) DOWNTO 0);

  SIGNAL const1   : std_logic;
  SIGNAL count    : integer range 0 to fifo_sz+1 := 0;
-- pragma translate_off
  SIGNAL peak : integer range 0 to fifo_sz+1 := 0;
-- pragma translate_on

BEGIN

  FIFO_REG: IF fifo_sz > 0 GENERATE
    const1 <= '1';
    vd <= vz OR NOT stat(0);
    lz <= ld OR stat(fifo_sz-1);
    size <= conv_std_logic_vector(count
            - (conv_integer(vz AND stat(fifo_sz-1)))
            + conv_integer(ld)
            , sz_width);   -- 32 == sz_width;
    Z_PROC: PROCESS(sbuf, d, stat)
    BEGIN
      IF conv_integer(stat(fifo_sz-1)) = 1 THEN
        z  <= sbuf(width*fifo_sz-1 DOWNTO width*(fifo_sz-1));
      ELSE
        z <= d;
     END IF;
    END PROCESS;

    FIFOPROC: PROCESS(ld, vz, d, stat, sbuf)
      VARIABLE stat_nxt,
               stat_before,
               en_l_var,
               stat_after   : std_logic;
      VARIABLE buf_nxt      : std_logic_vector(width-1 DOWNTO 0);
-- pragma translate_off
-- pragma translate_on
      VARIABLE n_elem : integer range 0 to fifo_sz+1;
      VARIABLE count_t : integer range 0 to fifo_sz+1;
    BEGIN
      n_elem := 0;
      FOR i IN fifo_sz-1 DOWNTO 0 LOOP
        IF i /= 0         THEN stat_before := stat(i-1); ELSE stat_before := '0'; END IF;
        IF i /= fifo_sz-1 THEN stat_after  := stat(i+1); ELSE stat_after  := '1'; END IF;
        stat_nxt := stat_after AND
          (stat_before OR (stat(i) AND NOT vz) OR (stat(i) AND ld) OR (ld AND NOT vz));
        en_l_var := '1';
        IF conv_integer(stat_nxt) = 1 THEN
          IF conv_integer(vz AND stat_before) = 1 THEN
            buf_nxt := sbuf(width*i-1 DOWNTO width*(i-1));
          ELSIF conv_integer(ld AND NOT((vz AND stat_before) OR (NOT vz AND stat(i)))) =  1 THEN
            buf_nxt := d;
          ELSE
            if pwropt = 1 THEN
              buf_nxt := (others => '0');
            ELSE
              buf_nxt := sbuf(width*(i+1)-1 DOWNTO width*i);
            END IF;
            en_l_var := '0';
          END IF;
        ELSE
          buf_nxt := (others => '0');
          en_l_var := '0';
        END IF;
        stat_pre(i) <= stat_nxt;
        IF conv_integer(ph_en) = 1 THEN
          en_l(i) <= en AND en_l_var;
        ELSE
          en_l(i) <= en OR (NOT en_l_var);
        END IF;
        buf_pre(width*(i+1)-1 DOWNTO width*i) <= buf_nxt;
        IF (stat_after = '1' AND stat(i) = '0') then
          n_elem := fifo_sz - 1 - i;
        END IF;
      END LOOP;

      IF conv_integer(ph_en) = 1 THEN
        en_l_s((adjust(fifo_sz)-1)/8) <= '1';
      ELSE
        en_l_s((adjust(fifo_sz)-1)/8) <= '0';
      END IF;
      FOR i IN fifo_sz-1 DOWNTO 7 LOOP
        IF (i rem 8) = 0 THEN
          IF conv_integer(ph_en) = 1 THEN
            en_l_s((i/8)-1) <= en AND (stat(i) OR stat_pre(i-1));
          ELSE
            en_l_s((i/8)-1) <= en OR (NOT (stat(i) OR stat_pre(i-1)));
          END IF;
        END IF;
      END LOOP;


      IF stat(fifo_sz-1) = '0' THEN
        count_t := 0;
      ELSIF stat(0) = '1' THEN
       count_t := fifo_sz;
      ELSE
        count_t := n_elem;
      END IF;
      count <= count_t;
-- pragma translate_off
      -- Although n_elem has not been initialized, it would be used only
      -- when it is assigned a value inside the FOR loop
      IF ( peak < count_t ) THEN
        peak <= count_t;
      END IF;
-- pragma translate_on
      --size <= conv_std_logic_vector(count_t, sz_width);   -- 32 == sz_width;
    END PROCESS;

    CGFIFO: IF pwropt > 0 GENERATE
    BEGIN
      BUF_GEN: FOR i IN fifo_sz-1 DOWNTO 0 GENERATE
      BEGIN
        BUFREG: mgc_out_reg
          generic map (
            rscid   => rscid,
            width   => width,
            ph_clk  => ph_clk,
            ph_en   => ph_en,
            ph_arst => ph_arst,
            ph_srst => ph_srst
          )
          port map (
            clk  => clk,
            en   => en_l(i),
            arst => arst,
            srst => srst,
            ld   => const1,
            d    => buf_pre(width*(i+1)-1 DOWNTO width*i),
            lz   => open,
            z    => sbuf(width*(i+1)-1 DOWNTO width*i)
          );
      END GENERATE;
    END GENERATE;
    CGSTATFIFO: IF pwropt = 1 GENERATE
    STATREG: mgc_out_reg
      generic map (
        rscid   => rscid,
        width   => fifo_sz,
        ph_clk  => ph_clk,
        ph_en   => ph_en,
        ph_arst => ph_arst,
        ph_srst => ph_srst
      )
      port map (
        clk  => clk,
        en   => en,
        arst => arst,
        srst => srst,
        ld   => const1,
        d    => stat_pre,
        lz   => open,
        z    => stat
      );
    END GENERATE;
    CGSTATFIFO2: IF pwropt = 2 GENERATE
      STATGEN2: FOR i IN fifo_sz-1 DOWNTO 0 GENERATE
      BEGIN
      STATREG2: mgc_out_reg
        generic map (
          rscid   => rscid,
          width   => 1,
          ph_clk  => ph_clk,
          ph_en   => ph_en,
          ph_arst => ph_arst,
          ph_srst => ph_srst
        )
        port map (
          clk  => clk,
          en   => en_l_s(i/8),
          arst => arst,
          srst => srst,
          ld   => const1,
          d    => stat_pre(i DOWNTO i),
          lz   => open,
          z    => stat(i DOWNTO i)
        );
      END GENERATE;
    END GENERATE;
    CGREG: IF pwropt = 0 GENERATE
    BEGIN
      STATREG: mgc_out_reg
        generic map (
          rscid   => rscid,
          width   => fifo_sz,
          ph_clk  => ph_clk,
          ph_en   => ph_en,
          ph_arst => ph_arst,
          ph_srst => ph_srst
        )
        port map (
          clk  => clk,
          en   => en,
          arst => arst,
          srst => srst,
          ld   => const1,
          d    => stat_pre,
          lz   => open,
          z    => stat
        );
      BUFREG: mgc_out_reg
        generic map (
          rscid   => rscid,
          width   => width*fifo_sz,
          ph_clk  => ph_clk,
          ph_en   => ph_en,
          ph_arst => ph_arst,
          ph_srst => ph_srst
        )
        port map (
          clk  => clk,
          en   => en,
          arst => arst,
          srst => srst,
          ld   => const1,
          d    => buf_pre,
          lz   => open,
          z    => sbuf
        );
    END GENERATE;
  END GENERATE;

  FEED_THRU: IF fifo_sz = 0 GENERATE
    vd <= vz;
    lz <= ld;
    z <= d;
    size <= conv_std_logic_vector (conv_integer(ld AND NOT vz), sz_width);   -- 32 == sz_width;
  END GENERATE;
END beh;


LIBRARY ieee;
USE ieee.std_logic_1164.all;
USE ieee.std_logic_unsigned.all;

LIBRARY mgc_hls;
USE mgc_hls.mgc_ioport_comps.all;

ENTITY mgc_out_prereg_en IS
  GENERIC (
    rscid    : INTEGER;
    width    : INTEGER
  );
  PORT (
    ld       : IN  std_logic;
    d        : IN  std_logic_vector(width-1 DOWNTO 0);
    lz       : OUT std_logic;
    z        : OUT std_logic_vector(width-1 DOWNTO 0)
  );
END mgc_out_prereg_en;

ARCHITECTURE beh OF mgc_out_prereg_en IS
BEGIN

  lz   <= ld;
  z    <= d;

END beh;

-----------------
-- INOUT ENTITIES
-----------------

LIBRARY ieee;
USE ieee.std_logic_1164.all;
USE ieee.std_logic_arith.all;
USE ieee.std_logic_unsigned.all;

LIBRARY mgc_hls;
USE mgc_hls.mgc_ioport_comps.all;

ENTITY mgc_inout_stdreg_en IS
  GENERIC (
    rscid    : INTEGER;
    width    : INTEGER
  );
  PORT (
    ldin     : IN    std_logic;
    din      : OUT   std_logic_vector(width-1 DOWNTO 0);
    ldout    : IN    std_logic;
    dout     : IN    std_logic_vector(width-1 DOWNTO 0);
    lzin     : OUT   std_logic;
    lzout    : OUT   std_logic;
    z        : INOUT std_logic_vector(width-1 DOWNTO 0)
  );
END mgc_inout_stdreg_en;

ARCHITECTURE beh OF mgc_inout_stdreg_en IS
BEGIN

  lzin  <= ldin;
  din   <= z WHEN ldin = '1'
      ELSE (others => 'Z');
  lzout <= ldout;
  z     <= dout WHEN ldout = '1'
      ELSE (others => 'Z');

END beh;

LIBRARY ieee;
USE ieee.std_logic_1164.all;
USE ieee.std_logic_unsigned.all;

LIBRARY mgc_hls;
USE mgc_hls.mgc_ioport_comps.all;

ENTITY mgc_hid_tribuf IS
  GENERIC (
    width    : INTEGER
  );
  PORT (
    I_SIG    : IN     std_logic_vector(width-1 DOWNTO 0);
    ENABLE   : IN     boolean;
    O_SIG    : OUT    std_logic_vector(width-1 DOWNTO 0)
  );
END mgc_hid_tribuf;

ARCHITECTURE beh of mgc_hid_tribuf IS
BEGIN
  O_SIG <= I_SIG when ENABLE
                 ELSE (others => 'Z');
END beh;

LIBRARY ieee;
USE ieee.std_logic_1164.all;
USE ieee.std_logic_arith.all;
USE ieee.std_logic_unsigned.all;

LIBRARY mgc_hls;
USE mgc_hls.mgc_ioport_comps.all;

ENTITY mgc_inout_stdreg_wait IS
  GENERIC (
    rscid    : INTEGER;
    width    : INTEGER
  );
  PORT (
    ldin     : IN    std_logic;
    vdin     : OUT   std_logic;
    din      : OUT   std_logic_vector(width-1 DOWNTO 0);
    ldout    : IN    std_logic;
    vdout    : OUT   std_logic;
    dout     : IN    std_logic_vector(width-1 DOWNTO 0);
    lzin     : OUT   std_logic;
    vzin     : IN    std_logic;
    lzout    : OUT   std_logic;
    vzout    : IN    std_logic;
    z        : INOUT std_logic_vector(width-1 DOWNTO 0)
  );
END mgc_inout_stdreg_wait;

ARCHITECTURE beh OF mgc_inout_stdreg_wait IS
  signal z_enable : boolean ;
BEGIN

  lzin  <= ldin;
  vdin  <= vzin;
  din   <= z;
  lzout <= ldout;
  vdout <= vzout;
  z_enable <= conv_integer(ldout) = 1 AND conv_integer(vzout) = 1;

  TRI_BUF:mgc_hid_tribuf
  GENERIC MAP(
    width    => width
  )
  PORT MAP (
    I_SIG    => dout,
    ENABLE   => z_enable,
    O_SIG    => z
  );

END beh;


LIBRARY ieee;
USE ieee.std_logic_1164.all;
USE ieee.std_logic_arith.all;
USE ieee.std_logic_unsigned.all;

LIBRARY mgc_hls;
USE mgc_hls.mgc_ioport_comps.all;

ENTITY mgc_inout_buf_wait IS
  GENERIC (
    rscid    : INTEGER;
    width    : INTEGER;
    ph_clk   : INTEGER RANGE 0 TO 1;
    ph_en    : INTEGER RANGE 0 TO 1;
    ph_arst  : INTEGER RANGE 0 TO 1;
    ph_srst  : INTEGER RANGE 0 TO 1
  );
  PORT (
    clk      : IN    std_logic;
    en       : IN    std_logic;
    arst     : IN    std_logic;
    srst     : IN    std_logic;
    ldin     : IN    std_logic;
    vdin     : OUT   std_logic;
    din      : OUT   std_logic_vector(width-1 DOWNTO 0);
    ldout    : IN    std_logic;
    vdout    : OUT   std_logic;
    dout     : IN    std_logic_vector(width-1 DOWNTO 0);
    lzin     : OUT   std_logic;
    vzin     : IN    std_logic;
    lzout    : OUT   std_logic;
    vzout    : IN    std_logic;
    z        : INOUT std_logic_vector(width-1 DOWNTO 0)
  );
END mgc_inout_buf_wait;

ARCHITECTURE beh OF mgc_inout_buf_wait IS

  SIGNAL lzout_buf : std_logic;
  SIGNAL vzout_buf : std_logic;
  SIGNAL z_buf     : std_logic_vector(width-1 DOWNTO 0);
  SIGNAL z_enable  : boolean;

BEGIN

  lzin  <= ldin;
  vdin  <= vzin;
  din   <= z;
  lzout <= lzout_buf AND NOT ldin;
  vzout_buf <= vzout AND NOT ldin;
  z_enable <= conv_integer(lzout_buf AND NOT ldin) = 1 AND conv_integer(vzout) = 1;

  TRI_BUF:mgc_hid_tribuf
  GENERIC MAP(
    width    => width
  )
  PORT MAP (
    I_SIG    => z_buf,
    ENABLE   => z_enable,
    O_SIG    => z
  );

  BUF: mgc_out_buf_wait
    generic map (
      rscid => rscid,
      width => width,
      ph_clk => ph_clk,
      ph_en => ph_en,
      ph_arst => ph_arst,
      ph_srst => ph_srst
    )
    port map (
      clk    => clk,
      en     => en,
      arst   => arst,
      srst   => srst,
      ld     => ldout,
      vd     => vdout,
      d      => dout,
      lz     => lzout_buf,
      vz     => vzout_buf,
      z      => z_buf
    );

END beh;


LIBRARY ieee;
USE ieee.std_logic_1164.all;
USE ieee.std_logic_arith.all;
USE ieee.std_logic_unsigned.all;

LIBRARY mgc_hls;
USE mgc_hls.mgc_ioport_comps.all;

ENTITY mgc_inout_fifo_wait IS
  GENERIC (
    rscid    : INTEGER;
    width    : INTEGER;
    fifo_sz  : INTEGER;
    ph_clk   : INTEGER RANGE 0 TO 1;
    ph_en    : INTEGER RANGE 0 TO 1;
    ph_arst  : INTEGER RANGE 0 TO 1;
    ph_srst  : INTEGER RANGE 0 TO 1;
    ph_log2  : INTEGER;
    pwropt   : INTEGER RANGE 0 TO 2 := 0
  );
  PORT (
    clk      : IN    std_logic;
    en       : IN    std_logic;
    arst     : IN    std_logic;
    srst     : IN    std_logic;
    ldin     : IN    std_logic;
    vdin     : OUT   std_logic;
    din      : OUT   std_logic_vector(width-1 DOWNTO 0);
    ldout    : IN    std_logic;
    vdout    : OUT   std_logic;
    dout     : IN    std_logic_vector(width-1 DOWNTO 0);
    lzin     : OUT   std_logic;
    vzin     : IN    std_logic;
    lzout    : OUT   std_logic;
    vzout    : IN    std_logic;
    z        : INOUT std_logic_vector(width-1 DOWNTO 0)
  );
END mgc_inout_fifo_wait;

ARCHITECTURE beh OF mgc_inout_fifo_wait IS

  SIGNAL lzout_buf : std_logic;
  SIGNAL vzout_buf : std_logic;
  SIGNAL size      : std_logic_vector(31 DOWNTO 0);
  SIGNAL z_buf     : std_logic_vector(width-1 DOWNTO 0);
  SIGNAL z_enable  : boolean;

BEGIN

  lzin  <= ldin;
  vdin  <= vzin;
  din   <= z;
  lzout <= lzout_buf AND NOT ldin;
  vzout_buf <= vzout AND NOT ldin;
  z_enable <= conv_integer(lzout_buf AND NOT ldin) = 1 AND conv_integer(vzout) = 1;
  --z     <= z_buf WHEN z_enable
  --               ELSE (others => 'Z');

  TRI_BUF:mgc_hid_tribuf
  GENERIC MAP(
    width    => width
  )
  PORT MAP (
    I_SIG    => z_buf,
    ENABLE   => z_enable,
    O_SIG    => z
  );

  FIFO: mgc_out_fifo_wait
    generic map (
      rscid   => rscid,
      width   => width,
      fifo_sz => fifo_sz,
      ph_clk  => ph_clk,
      ph_en   => ph_en,
      ph_arst => ph_arst,
      ph_srst => ph_srst,
      ph_log2 => ph_log2,
      pwropt  => pwropt
    )
    port map (
      clk  => clk,
      en   => en,
      arst => arst,
      srst => srst,
      ld   => ldout,
      vd   => vdout,
      d    => dout,
      lz   => lzout_buf,
      vz   => vzout_buf,
      z    => z_buf
    );

END beh;


------------------------------
-- IO SYNCHRONIZATION ENTITIES
------------------------------

LIBRARY ieee;
USE ieee.std_logic_1164.all;
USE ieee.std_logic_unsigned.all;

LIBRARY mgc_hls;
USE mgc_hls.mgc_ioport_comps.all;

ENTITY mgc_io_sync IS
  PORT (
    ld       : IN    std_logic;
    lz       : OUT   std_logic
  );
END mgc_IO_sync;

ARCHITECTURE beh OF mgc_io_sync IS
BEGIN

  lz <= ld;

END beh;


LIBRARY ieee;
USE ieee.std_logic_1164.all;
USE ieee.std_logic_unsigned.all;

ENTITY mgc_bsync_rdy IS
  GENERIC (
    rscid    : INTEGER;
    ready    : INTEGER RANGE 0 TO 1;
    valid    : INTEGER RANGE 0 TO 1
  );
  PORT (
    rd       : IN    std_logic;
    rz       : OUT   std_logic
  );
END mgc_bsync_rdy;

ARCHITECTURE beh OF mgc_bsync_rdy IS
BEGIN

  rz <= rd;

END beh;


LIBRARY ieee;
USE ieee.std_logic_1164.all;
USE ieee.std_logic_unsigned.all;

ENTITY mgc_bsync_vld IS
  GENERIC (
    rscid    : INTEGER;
    ready    : INTEGER RANGE 0 TO 1;
    valid    : INTEGER RANGE 0 TO 1
  );
  PORT (
    vd       : OUT   std_logic;
    vz       : IN    std_logic
  );
END mgc_bsync_vld;

ARCHITECTURE beh OF mgc_bsync_vld IS
BEGIN

  vd <= vz;

END beh;


LIBRARY ieee;
USE ieee.std_logic_1164.all;
USE ieee.std_logic_unsigned.all;

ENTITY mgc_bsync_rv IS
  GENERIC (
    rscid    : INTEGER;
    ready    : INTEGER RANGE 0 TO 1;
    valid    : INTEGER RANGE 0 TO 1
  );
  PORT (
    rd       : IN    std_logic;
    vd       : OUT   std_logic;
    rz       : OUT   std_logic;
    vz       : IN    std_logic
  );
END mgc_bsync_rv;

ARCHITECTURE beh OF mgc_bsync_rv IS
BEGIN

  rz <= rd;
  vd <= vz;

END beh;


LIBRARY ieee;
USE ieee.std_logic_1164.all;
USE ieee.std_logic_unsigned.all;

LIBRARY mgc_hls;
USE mgc_hls.mgc_ioport_comps.all;

ENTITY mgc_sync IS
  PORT (
    ldin     : IN    std_logic;
    vdin     : OUT   std_logic;
    ldout    : IN    std_logic;
    vdout    : OUT   std_logic
  );
END mgc_sync;

ARCHITECTURE beh OF mgc_sync IS

BEGIN

  vdin <= ldout;
  vdout <= ldin;

END beh;


LIBRARY ieee;
USE ieee.std_logic_1164.all;
USE ieee.std_logic_unsigned.all;

LIBRARY mgc_hls;
USE mgc_hls.mgc_ioport_comps.all;

ENTITY mgc_pipe IS
  GENERIC (
    rscid    : INTEGER;
    width    : INTEGER;
    sz_width : INTEGER;
    fifo_sz  : INTEGER;
    log2_sz  : INTEGER;
    ph_clk   : INTEGER RANGE 0 TO 1;
    ph_en    : INTEGER RANGE 0 TO 1;
    ph_arst  : INTEGER RANGE 0 TO 1;
    ph_srst  : INTEGER RANGE 0 TO 1;
    pwropt   : INTEGER RANGE 0 TO 2 := 0
  );
  PORT (
    clk      : IN    std_logic;
    en       : IN    std_logic;
    arst     : IN    std_logic;
    srst     : IN    std_logic;
    ldin     : IN    std_logic;
    vdin     : OUT   std_logic;
    din      : OUT   std_logic_vector(width-1 DOWNTO 0);
    ldout    : IN    std_logic;
    vdout    : OUT   std_logic;
    dout     : IN    std_logic_vector(width-1 DOWNTO 0);
    size     : OUT   std_logic_vector(sz_width-1 DOWNTO 0);
    req_size : in    std_logic
  );
END mgc_pipe;

ARCHITECTURE beh OF mgc_pipe IS

BEGIN
  FIFO: mgc_out_fifo_wait_core
    generic map (
      rscid    => rscid,
      width    => width,
      sz_width => sz_width,
      fifo_sz  => fifo_sz,
      ph_clk   => ph_clk,
      ph_en    => ph_en,
      ph_arst  => ph_arst,
      ph_srst  => ph_srst,
      ph_log2  => log2_sz,
      pwropt   => pwropt
    )
    port map (
      clk  => clk,
      en   => en,
      arst => arst,
      srst => srst,
      ld   => ldout,
      vd   => vdout,
      d    => dout,
      lz   => vdin,
      vz   => ldin,
      z    => din,
      size => size
    );

END beh;


LIBRARY ieee;
USE ieee.std_logic_1164.all;
USE ieee.std_logic_unsigned.all;
LIBRARY mgc_hls;
USE mgc_hls.mgc_ioport_comps.all;

ENTITY mgc_in_ram IS
generic
(
  ram_id            : integer;
  words             : integer;
  width             : integer;
  addr_width        : integer;
  re_active         : integer;
  num_byte_enables  : integer;
  no_of_ports       : integer
);
port
(
  d  : out  STD_LOGIC_VECTOR((no_of_ports * width) - 1 downto 0);
  ad : in  STD_LOGIC_VECTOR((no_of_ports * addr_width) - 1 downto 0) ;
  bd : in  STD_LOGIC_VECTOR((no_of_ports * num_byte_enables) - 1 downto 0) ;
  z  : in  STD_LOGIC_VECTOR((no_of_ports * width) - 1 downto 0);
  az : out  STD_LOGIC_VECTOR((no_of_ports * addr_width) - 1 downto 0) ;
  bz : out  STD_LOGIC_VECTOR((no_of_ports * num_byte_enables) - 1 downto 0)
);
END mgc_in_ram;

ARCHITECTURE beh OF mgc_in_ram IS
BEGIN
  d  <= z;
  az <= ad;
  bz <= bd;
END beh;


LIBRARY ieee;
USE ieee.std_logic_1164.all;
USE ieee.std_logic_unsigned.all;
LIBRARY mgc_hls;
USE mgc_hls.mgc_ioport_comps.all;

ENTITY mgc_out_ram IS
generic
(
  ram_id            : integer;
  words             : integer;
  width             : integer;
  addr_width        : integer;
  re_active         : integer;
  num_byte_enables  : integer;
  no_of_ports       : integer
);
port
(
  d  : in  STD_LOGIC_VECTOR((no_of_ports * width) - 1 downto 0);
  ad : in  STD_LOGIC_VECTOR((no_of_ports * addr_width) - 1 downto 0) ;
  bd : in  STD_LOGIC_VECTOR((no_of_ports * num_byte_enables) - 1 downto 0) ;
  z  : out  STD_LOGIC_VECTOR((no_of_ports * width) - 1 downto 0);
  az : out  STD_LOGIC_VECTOR((no_of_ports * addr_width) - 1 downto 0) ;
  bz : out  STD_LOGIC_VECTOR((no_of_ports * num_byte_enables) - 1 downto 0)
);
END mgc_out_ram;

ARCHITECTURE beh OF mgc_out_ram IS
BEGIN
  z  <= d;
  az <= ad;
  bz <= bd;
END beh;


LIBRARY ieee;
USE ieee.std_logic_1164.all;
USE ieee.std_logic_unsigned.all;
LIBRARY mgc_hls;
USE mgc_hls.mgc_ioport_comps.all;

ENTITY mgc_inout_ram IS
generic
(
  ram_id            : integer;
  words             : integer;
  width             : integer;
  addr_width        : integer;
  re_active         : integer;
  we_active         : integer;
  num_byte_enables  : integer; -- ##
  no_of_ports       : integer
);
port
(
 id  : out  STD_LOGIC_VECTOR((no_of_ports * width) - 1 downto 0);
 od  : in  STD_LOGIC_VECTOR((no_of_ports * width) - 1 downto 0);
 ad  : in  STD_LOGIC_VECTOR((no_of_ports * addr_width) - 1 downto 0) ;
 rd  : in  STD_LOGIC_VECTOR((no_of_ports * num_byte_enables) - 1 downto 0) ;
 wd  : in  STD_LOGIC_VECTOR((no_of_ports * num_byte_enables) - 1 downto 0) ;
 iz  : in  STD_LOGIC_VECTOR((no_of_ports * width) - 1 downto 0);
 oz  : out  STD_LOGIC_VECTOR((no_of_ports * width) - 1 downto 0);
 az  : out  STD_LOGIC_VECTOR((no_of_ports * addr_width) - 1 downto 0) ;
 rz  : out  STD_LOGIC_VECTOR((no_of_ports * num_byte_enables) - 1 downto 0);
 wz  : out  STD_LOGIC_VECTOR((no_of_ports * num_byte_enables) - 1 downto 0)
);
END mgc_inout_ram;

ARCHITECTURE beh OF mgc_inout_ram IS
BEGIN
  id <= iz;
  oz <= od;
  az <= ad;
  rz <= rd;
  wz <= wd;
END beh;


LIBRARY ieee;
USE ieee.std_logic_1164.all;
USE ieee.std_logic_unsigned.all;
LIBRARY mgc_hls;
USE mgc_hls.mgc_ioport_comps.all;

ENTITY funccall_inout IS
generic
(
  ram_id            : integer;
  width           : integer;  -- models the concat of the return value (data)
  addr_width      : integer  -- models the concat of the input arguments (addr)
);
port
(
  d  : out  STD_LOGIC_VECTOR(width - 1 downto 0);
  ad : in  STD_LOGIC_VECTOR(addr_width - 1 downto 0) ;
  bd : in  STD_LOGIC;
  z  : in  STD_LOGIC_VECTOR(width - 1 downto 0);
  az : out  STD_LOGIC_VECTOR(addr_width - 1 downto 0) ;
  bz : out  STD_LOGIC
);
END funccall_inout;

ARCHITECTURE beh OF funccall_inout IS
BEGIN
  d  <= z;
  az <= ad;
  bz <= bd;
END beh;


LIBRARY ieee;
USE ieee.std_logic_1164.all;
USE ieee.std_logic_unsigned.all;
LIBRARY mgc_hls;
USE mgc_hls.mgc_ioport_comps.all;

ENTITY modulario_en_in IS
  GENERIC (
    rscid    : INTEGER;
    width    : INTEGER
  );
  PORT (
    vd       : OUT std_logic;
    d        : OUT std_logic_vector(width-1 DOWNTO 0);
    vz       : IN  std_logic;
    z        : IN  std_logic_vector(width-1 DOWNTO 0)
  );
END modulario_en_in;

ARCHITECTURE beh OF modulario_en_in IS
BEGIN

  vd <= vz;
  d  <= z;

END beh;
