soheil647/High_Level_Synthesis/Catapult_ImageProssesing/ESL_modelsim/work/@convolotion/_primary.vhd

library verilog;
use verilog.vl_types.all;
entity Convolotion is
    port(
        clk             : in     vl_logic;
        rst             : in     vl_logic;
        in_rsc_singleport_data_in: out    vl_logic_vector(7 downto 0);
        in_rsc_singleport_addr: out    vl_logic_vector(17 downto 0);
        in_rsc_singleport_re: out    vl_logic;
        in_rsc_singleport_we: out    vl_logic;
        in_rsc_singleport_data_out: in     vl_logic_vector(7 downto 0);
        out_rsc_singleport_data_in: out    vl_logic_vector(7 downto 0);
        out_rsc_singleport_addr: out    vl_logic_vector(17 downto 0);
        out_rsc_singleport_re: out    vl_logic;
        out_rsc_singleport_we: out    vl_logic;
        out_rsc_singleport_data_out: in     vl_logic_vector(7 downto 0)
    );
end Convolotion;
