soheil647/High_Level_Synthesis/Catapult_ImageProssesing/ESL_modelsim/work/@ram/_primary.vhd

library verilog;
use verilog.vl_types.all;
entity Ram is
    port(
        Address         : in     vl_logic_vector(17 downto 0);
        Data_In         : in     vl_logic_vector(7 downto 0);
        Clock           : in     vl_logic;
        Rst             : in     vl_logic;
        WriteEnable     : in     vl_logic;
        finish          : in     vl_logic
    );
end Ram;
