soheil647/High_Level_Synthesis/Chisel_Introduction/CA5/Quartes_ALU/ALUAdd.v

module ALUAdd(
  input  [15:0] io_i_input1,
  input  [15:0] io_i_input2,
  output [31:0] io_o_out
);
  wire [16:0] _T_11; // @[ALUAdder.scala 11:27]
  wire [15:0] _T_12; // @[ALUAdder.scala 11:27]
  assign _T_11 = io_i_input1 + io_i_input2; // @[ALUAdder.scala 11:27]
  assign _T_12 = io_i_input1 + io_i_input2; // @[ALUAdder.scala 11:27]
  assign io_o_out = {{16'd0}, _T_12}; // @[ALUAdder.scala 11:12]
endmodule
