soheil647/High_Level_Synthesis/Matlab_HDLCoder_FIR/modesim_ESL/work/@f@i@r/_primary.vhd

library verilog;
use verilog.vl_types.all;
entity FIR is
    port(
        X               : in     vl_logic_vector(15 downto 0);
        clk             : in     vl_logic;
        rst             : in     vl_logic;
        \Out\           : out    vl_logic_vector(15 downto 0)
    );
end FIR;
