soheil647/High_Level_Synthesis/Matlab_HDLCoder_FIR/modesim_ESL/work/@m@u@x3/_primary.vhd

library verilog;
use verilog.vl_types.all;
entity MUX3 is
    port(
        \Select\        : in     vl_logic_vector(3 downto 0);
        \Out\           : out    vl_logic_vector(3 downto 0)
    );
end MUX3;
