soheil647/High_Level_Synthesis/Matlab_HDLCoder_FIR/modesim_ESL/work/@subsystem/_primary.vhd

library verilog;
use verilog.vl_types.all;
entity Subsystem is
    port(
        clk             : in     vl_logic;
        reset           : in     vl_logic;
        clk_enable      : in     vl_logic;
        In1             : in     vl_logic_vector(15 downto 0);
        ce_out          : out    vl_logic;
        Out1            : out    vl_logic_vector(15 downto 0)
    );
end Subsystem;
