soheil647/High_Level_Synthesis/Matlab_HDLCoder_FIR/modesim_ESL/work/@subsystem_tc/_primary.vhd

library verilog;
use verilog.vl_types.all;
entity Subsystem_tc is
    port(
        clk             : in     vl_logic;
        reset           : in     vl_logic;
        clk_enable      : in     vl_logic;
        enb_16_1_1      : out    vl_logic;
        enb             : out    vl_logic;
        enb_1_1_1       : out    vl_logic
    );
end Subsystem_tc;
