soheil647/High_Level_Synthesis/Matlab_HDLCoder_FIR/modesim_ESL/work/f0/_primary.vhd

library verilog;
use verilog.vl_types.all;
entity f0 is
    port(
        A               : in     vl_logic_vector(15 downto 0);
        \Out\           : out    vl_logic_vector(15 downto 0)
    );
end f0;
